BaslyHedi/Nexus-Platform/mechanical/README.md

# Mechanical - the parts we make, the chassis model, and its renders

Everything we build and model mechanically: the rear fascia, the proposed carrier tray, the
plate-1 stand-ins and the whole-vehicle model. The **why** lives in the design decisions
([`../decisions/README.md`](../decisions/README.md)); this folder owns the geometry.

| Folder | Holds |
|---|---|
| [`cad/`](cad/) | Models and the files made from them: OpenSCAD sources, the print STLs, the drilling template, and (untracked) the whole-vehicle model and its parts |
| [`scripts/`](scripts/) | The Python and Blender scripts that build the model and animate it |
| `renders/` | Videos and stills, **generated and untracked** - re-run the scripts. The SVGs are committed: the hand-made tray's template is the source of [`cad/carrier-tray-hand-template.pdf`](cad/carrier-tray-hand-template.pdf) |

The scripts find everything relative to themselves, so they run from any directory.

**Animation naming.** One rule for every animation: the script is `scripts/animate-<part>.py` and writes `renders/<part>-animation.mp4`; its stills are `renders/<part>-still-<seconds>.png`. `<part>` is the same slug as the part's CAD or drawing file, so the four are `harness-board` (MEC-16), `stm32-carrier` (`hardware/scripts/stm32-carrier.py`), `carrier-tray` (`carrier-tray.scad`, MEC-17, with the rear pad) and `compute-tray` (`compute-tray.scad`, MEC-18). Every script takes `-- --preview` (half size, every 4th frame) and, except the harness board's, `-- --still <seconds>`. They share one lighting (`paint.sl`), because the default studio light leaves surfaces seen from below black.

| File | Size | What it is |
|---|---|---|
| [`cad/fascia.scad`](cad/fascia.scad) | 18 kB | **Source of truth for both panels.** Every dimension, and why, in comments. Edit only here |
| [`cad/fascia-lower.stl`](cad/fascia-lower.stl) | 1.3 MB | Print file - lower panel, 124.2 × 18.9 × **52** mm, 19.6 cm³ (~25 g in PETG) |
| [`cad/fascia-upper.stl`](cad/fascia-upper.stl) | 2.2 MB | Print file - upper panel, 124.2 × 18.9 × **42** mm, 16.7 cm³ (~21 g in PETG) |
| [`cad/carrier-tray.scad`](cad/carrier-tray.scad) | 11 kB | **Carrier tray** (MEC-17), ordered 2026-10-06 (BOM 3.28): one plate under boards A, B and C and the Bauer converter, in two steps - the boards placed on the tray in its own frame, then the tray placed on plate 2 by one `PLACE` offset. It copies the plate-2 holes under it and bolts down at six of them with nut pockets; the Bauer is screwed to it through its own two holes. **Kept as ordered since board B became a 3×7 (2026-10-26):** one 2.1 mm hole is drilled in it by hand for B's rear inboard corner, at plate 2 (187.04, 83.65), and B's inboard pair stays empty (header STATUS, MEC-17). `PART="tray"` → [`cad/carrier-tray.stl`](cad/carrier-tray.stl) to print; `PART="template"` → a 1:1 SVG with a 50 mm check bar (the hand-cut fallback); `PART="step1"` / `"step2"` → the two placement views in `renders/`. Output is mirrored once from the layout frame into the real world |
| [`cad/compute-tray.scad`](cad/compute-tray.scad) | 9 kB | **Compute tray** (MEC-18), ordered 2026-10-06 (BOM 3.28): one 236.6 x 108.0 x 4 mm plate on plate 3, both boards turned across the vehicle - a spare pad in the nose (plate 3's outline moved in 5 mm), the Pi 5 pad, a plug gap with two ribs, the FRDM pad. Standoff screws go in from the underside through counterbores; 14 fixings to plate 3's own holes. `PART="tray"` -> [`cad/compute-tray.stl`](cad/compute-tray.stl) to print |
| [`cad/compute-tray-preview.scad`](cad/compute-tray-preview.scad) | 7 kB | The preview scene for MEC-18: plate 3, the tray, both boards on their standoffs (the FRDM's connectors from the NXP Quick Start Guide), the screws. `VIEW="top"`, `"iso"`, `"explode"` or `"side"`; the camera on the command line (see the file) |
| [`cad/plate3-data.scad`](cad/plate3-data.scad) | 5 kB | **Generated** by [`scripts/plate3-data.py`](scripts/plate3-data.py) from the layout drawing: plate 3's outline, holes, slots, standoffs and clamp holes. Do not edit |
| [`cad/plate2-rear-pad.scad`](cad/plate2-rear-pad.scad) | 5 kB | **Rear pad** (MEC-19), ordered 2026-10-06 (BOM 3.28): a separate 55 x 96 x 4 mm plain plate spread over plate 2's rear (x 196-251, y 12-108), to drill; six fixings on plate 2's own slot and holes, clear of the cross-slot, the standoffs and the carrier tray; the J7 lead lies across it. `PART="tray"` -> [`cad/plate2-rear-pad.stl`](cad/plate2-rear-pad.stl) to print |
| [`cad/carrier-tray-hand-template.pdf`](cad/carrier-tray-hand-template.pdf) | 52 kB | **Print-ready template for the hand-made tray** (MEC-17): A4 landscape, 1:1, print at 100 % and check the 100 mm bar. Written from `scripts/carrier-tray-hand.py`; regenerate it when the script changes |
| **Hiwonder** · *Ackermann Chassis (Single Layer)* `.3dm` | 186 MB | Hiwonder's own CAD, untouched. **Not in the repository** - it is theirs, not ours to redistribute, and it has to be fetched by hand on a fresh clone. Every chassis number in the project is measured from this, not from photos - see [`../bom/parts/2.1-Hiwonder-Ackermann-Chassis/SPECS.md`](../bom/parts/2.1-Hiwonder-Ackermann-Chassis/SPECS.md). It is the **single-plate** version |
| `cad/chassis-3deck-fascia.obj` | 65 MB | Whole-vehicle mock-up: Hiwonder's chassis + our deck 3 + the current panels. **Untracked, and a seed rather than output** - `make-assembly.py` reads it and rewrites it in place, so it cannot be rebuilt from this repository alone. It began as a Rhino export of the `.3dm`. Keep a local backup |
| `cad/assembly.stl` | 69 MB | The same assembly as one mesh, for renders. **Generated and untracked** - delete it and re-run |
| `cad/plate1/*.stl`, `cad/plate1/states/`, `cad/chassis-3deck-fascia.mtl` | 1 MB | **Generated and untracked** - the plate 1 parts; the two wires that cross between the decks in the `raised` and `open` positions (plate 2 lowering, 60 mm up, or hinged over like a book); and the colours. Re-run the two scripts |
| [`scripts/plate1.py`](scripts/plate1.py) | 20 kB | **Plate 1 stand-ins for an eye review** (MEC-16): every component and every wire run as its own STL in `cad/plate1/`, at the assumed sizes, plus the four tires the CAD leaves off (about 68 x 30, estimated from a photo). Not for building from |
| [`scripts/make-assembly.py`](scripts/make-assembly.py) | 8 kB | Rebuilds the assembly in `cad/` from the current STLs, fascia and plate 1, coloured through the `.mtl`. Run it after any fascia or plate 1 change |
| [`scripts/animate-harness-board.py`](scripts/animate-harness-board.py) | 10 kB | **Assembly animation** of the harness-board sandwich, in MEC-16's build order: parts onto the upturned plate 2, then all 30 wire runs one by one (each with a caption naming its ends and the clip, terminal or plug it finishes in), the flip, the lowering, the plugs, plate 3. `blender -b -P scripts/animate-harness-board.py` writes `renders/harness-board-animation.mp4` (about 1 min at double speed, 1080p; the timeline is in seconds at the top of the script); `-- --preview` renders a quick quarter-size version |
| [`scripts/animate-carrier-tray.py`](scripts/animate-carrier-tray.py) | 30 kB | **Carrier tray assembly animation** (MEC-17, MEC-19): the carrier built on the tray at the bench, then the tray set on plate 2, screwed from below, the separate rear pad nutted and screwed on behind it (67 s), and plate 2 lowered onto its standoffs; the Discovery plugs on last. Plate 2 is the survey's own outline and holes, the tray is `cad/carrier-tray.stl`, the boards are the as-built carrier through `carrier_model.py`, the Bauer is from the seller's drawing; the harness parts and the Discovery are stand-ins. `blender -b -P scripts/animate-carrier-tray.py` writes `renders/carrier-tray-animation.mp4` (50 s); `-- --preview` renders a quick half-size version; `-- --still 30` writes one PNG |
| [`scripts/animate-compute-tray.py`](scripts/animate-compute-tray.py) | 30 kB | **Compute tray assembly animation** (MEC-18): the nuts into the 14 pockets, the FRDM on its six standoffs and four screws from below, the Pi 5 on its standoffs (a later phase), the unit carried to plate 3 (held 60 mm clear of its standoffs), the 14 fixing screws from below, plate 3 lowering onto the chassis, then the BOM's three cables (J1, J11, J7). Plate 3 is the layout drawing's own outline, holes and slots (through `plate3-data.scad`); the FRDM's connectors are read off the Quick Start Guide. `blender -b -P scripts/animate-compute-tray.py` writes `renders/compute-tray-animation.mp4` (84 s, 1080p, about 20 min); `-- --preview` renders a quick half-size version, `-- --still 42` one frame at 42 s |
| [`scripts/carrier_model.py`](scripts/carrier_model.py) | 18 kB | The finished carrier (boards A, B, C and the Nucleo mock) as Blender objects, read from `hardware/scripts/stm32-carrier.py`. Used by `animate-carrier-tray.py`; `animate-stm32-carrier.py` still builds the same geometry step by step |
| [`scripts/carrier-tray-hand.py`](scripts/carrier-tray-hand.py) | 7 kB | **The hand-made tray's template** (MEC-17): a 1:1 A4 SVG (print at 100 %) with the all-right-angle cut line, true-size holes, the boards and the Bauer in outline, and the hole table, for a 4 mm sheet. Checks that no hole is too near an edge or another hole. `python3 scripts/carrier-tray-hand.py` -> `renders/carrier-tray-hand-template.svg` |
| [`scripts/animate-stm32-carrier.py`](scripts/animate-stm32-carrier.py) | 33 kB | **Carrier assembly animation** (MEC-15, HW-19), in the drawing's build order: sockets with the Discovery as the jig, the parts, the solder side run by run, the bridge, the module and standoffs, then board C. Built entirely from [`../hardware/scripts/stm32-carrier.py`](../hardware/scripts/stm32-carrier.py), so it cannot drift from the drawing. The Discovery is a **mock**: outline and headers from UM1472, everything on it placed by eye. `blender -b -P scripts/animate-stm32-carrier.py` writes `renders/stm32-carrier-animation.mp4` (47 s at double speed, 1080p); `-- --preview` renders a quick half-size version, `-- --still 40` one frame at 40 s |

## Building

```bash
cd cad
openscad -D 'PART="lower"' -o fascia-lower.stl fascia.scad
openscad -D 'PART="upper"' -o fascia-upper.stl fascia.scad
openscad -D 'PART="tray"'     -o carrier-tray.stl          carrier-tray.scad
openscad -D 'PART="tray"'     -o compute-tray.stl          compute-tray.scad
openscad -D 'PART="tray"'     -o plate2-rear-pad.stl       plate2-rear-pad.scad
openscad -D 'PART="step1"' --camera=0,0,0,0,0,0,300 --projection=o --autocenter --viewall -o ../renders/tray-step1.png carrier-tray.scad   # and step2
cd ..
python3 scripts/plate1.py
python3 scripts/make-assembly.py
blender -b -P scripts/animate-harness-board.py
blender -b -P scripts/animate-stm32-carrier.py
blender -b -P scripts/animate-carrier-tray.py
blender -b -P scripts/animate-compute-tray.py
```

Open `chassis-3deck-fascia.obj` in a viewer that reads OBJ materials (Blender, MeshLab, f3d) to see
the colours; the `.mtl` sits beside it. Plate 1's parts are the `P1_*` groups, one per component and
one per wire run, numbered as in the run table on the chassis layout drawing. Wire colours: red
unswitched +, orange switched +, black ground, teal the servo's 6 V.

`PART` also takes `both` / `exploded` / `blank` for previews, `fit` to see the panels
against the rear chassis, and **`clash`**, which intersects both panels with the plates and
standoffs. That one is the gate:

```bash
openscad -D 'PART="clash"' -o /tmp/clash.stl cad/fascia.scad   # must be zero volume
```

Zero volume - a few hundred triangles of coincident face - is a pass; those are the pad faces
lying on the plates, which is the clamp. Real volume is an interference. It has caught a live
bug once already (MEC-07), so run it before every print.

`PART="portclash"` is the second gate. It checks rough stand-ins of the three upper-panel
connectors against the panel, the rear chassis and each other, and must also
render zero volume (MEC-13):

```bash
openscad -D 'PART="portclash"' -o /tmp/portclash.stl cad/fascia.scad   # must be zero volume
```

## Print settings

PETG, 0.2 mm layers, ≥40 % infill, 4 walls, flat on the rear face, no supports.
Material choice and the reasoning behind it: **MEC-02**.

## Two panels, two heights

The gaps were measured on the built kit as **50 mm (lower)** and **40 mm (upper)** - the kit
ships two standoff lengths. So the panels are different parts and are **not** interchangeable
(**MEC-09**, which retires MEC-03). Mark each one on the inside face as it comes off the printer.

## What each decision owns

| | |
|---|---|
| **MEC-02** | The fascia exists at all, material, what each gap carries |
| **HW-18** | DE-9 as the CAN debug port, pinout |
| **MEC-03** | The split into two panels - its *interchangeable* half is retired by MEC-09 |
| **MEC-04** | Vents |
| **MEC-05** | The three debug ports and which board each reaches. Positions and apertures superseded by MEC-13 |
| **MEC-06** | DRIVE / LOGIC legends |
| **MEC-07** | The fixing: four pads per panel, six M3, captive nuts |
| **MEC-09** | The measured gaps, and the panels being different parts |
| **MEC-13** | The ports mounted from behind in pockets, in two horizontal rows; the USB-C grip limit; the upper panel's vents |
| **MEC-14** | The switch holes (⌀22.4) and what the switch drawing settles |
| **MEC-18** | *Proposed:* the compute tray on plate 3 - FRDM and Raspberry Pi 5 |

## Caveats worth knowing before you trust this geometry

- **Deck 3 is ours, not Hiwonder's.** The `.3dm` is the single-plate version; deck 3 in the
  `.obj` is a copy of deck 2, dropped to the measured 40 mm gap by `make-assembly.py`. Fixing
  the source CAD would make that patch unnecessary.
- **Some port geometry is read off photos** - the USB-C body width and flange depth, the Mini-B
  screw pitch and body. None of it is critical any more: the nearest body is 6 mm from a standoff,
  and the Mini-B's slotted hole takes any pitch from 27 to 30 (MEC-13).
- **The switch harness depth is checked on the real parts (2026-10-11).** The bare switch is 25 mm
  deep and clears the motors by about 8 mm; with the plug-on socket harness fitted it still fits
  behind the motors, with the cables pushed slightly to the side (MEC-14).
