BaslyHedi/Nexus-Platform/hardware/README.md

# Hardware

Build drawings for NEXUS. Each is an `.svg` in [`renders/`](renders/) **written by the script of the same name** in
[`scripts/`](scripts/): `chassis-layout.py` writes `chassis-layout.svg`, `wiring-schematic.py` writes `wiring-schematic.svg`,
`stm32-carrier.py` writes `stm32-carrier.svg`. Edit the script, never the SVG, then run it:

```bash
python3 hardware/scripts/chassis-layout.py        # -> hardware/renders/chassis-layout.svg
python3 tools/check-drawings.py                  # fails if any SVG is not what its script writes
```

[`scripts/drawing.py`](scripts/drawing.py) holds the small SVG helpers the first two share. The chassis plate (outline, slots, holes,
standoffs) is one table in millimetres drawn on all four plans; the wiring schematic's nets are one colour palette shared with its key.
Both scripts were made on 2026-10-05 from the SVGs as they stood and reproduce them exactly (the layout without 24 stray blank
lines), so nothing in a drawing changed when they took over. The plate outline in `chassis-layout.py` was traced from Hiwonder's CAD
export; the early scripts that did it were not kept (they can still be read in the commits of PR #6).

**No PDFs.** They are generated once, when the design is frozen. Until then the SVG is the
truth and a stale PDF beside it is just a second thing to get wrong. To read one, open the
SVG in a browser; to render, point headless Chrome at it.

| Drawing | Owns |
|---|---|
| [chassis-layout.svg](renders/chassis-layout.svg) | Where components sit on the **three** decks, to scale at 1.7 px/mm, plus the side elevation of the deck stack |
| [wiring-schematic.svg](renders/wiring-schematic.svg) | What connects to what - fuses, switches, wire gauges, 5 V rails, CAN, I²C, motor control |
| [stm32-carrier.svg](renders/stm32-carrier.svg) | Soldering and wiring for the three kit boards: A and B, which the NUCLEO-H533RE drops onto, and C, the 5 V split. Component side and solder side, hole by hole, with netlist and pre-solder checks (MEC-08, MEC-15, HW-19). **Generated** by `python3 stm32-carrier.py`, which also feeds the 3D animation in [`../mechanical/scripts/animate-stm32-carrier.py`](../mechanical/scripts/animate-stm32-carrier.py) |
| [`../decisions/README.md`](../decisions/README.md) | **Why** the drawings look the way they do - HW, MEC, SYS and SW entries, each with its reasoning and consequences. Not in this folder any more |

Part numbers, prices and status live in [`../bom/BOM.md`](../bom/BOM.md);
datasheets in [`../bom/`](../bom/).

## Still open

### Plate 1, the motor driver - fitted 2026-09-21

Footprint and position are both settled and the drawing matches the hardware. Geometry, the
as-mounted coordinates and the method behind them are in
[`../bom/parts/2.4-Encoder-Motor-Module/SPECS.md`](../bom/parts/2.4-Encoder-Motor-Module/SPECS.md).
In short: **42 x 58 at x 168-210, y 22.6-80.6**, long axis across the vehicle, connector edge to
the vehicle's right, **2 x M3 and spacers through the chassis slot at x 203.5**.

No chassis hole pattern matches the board's 32.4 x 48.4 - all 96 plate-1 features were searched,
nothing within 1.5 mm in either orientation - so that one slot is the whole fixing, and it takes
both rear holes anywhere along its length. What is still open:

- **The front pair is not fixed.** Two screws on one line let the board pivot. The front-left hole
  (y 75.8) sits **directly over the 14.6 x 59.8 cutout**, so a cable tie there is a straight pull
  with no diagonal; the front-right (y 27.4) lands on solid plate 3 mm past the cutout's end and
  can tie diagonally to the ⌀2.71 hole at x 169.9, y 20.2. Two ties, no new parts.
- **Spacer height is now a clearance, not a preference.** The board's rear 7 mm sits over the
  front of the motor cans, and at x 210 the ⌀33 can is only 10.7 mm above the plate. Measure what
  is fitted before ordering more.
- **M3 spacers are still not in the BOM** even though they are on the vehicle.
- **VM cannot be fed the way every other load is.** Input is a 2-pin 2.5 mm connector, about 3 A
  and 22 AWG, while the drive branch is 18 AWG behind a 5 A fuse and can see 4.6 A with both
  motors stalled. The adapter, and whether to double up through the 3-pin port, is open.
- **The board sits 8.6 mm off the centreline** because the forward screw is at the end of its
  slot. Fine as it is; the UBEC it displaced no longer sits on the floor at all (MEC-16).

### Plate 1 and the harness board - 2026-09-28

The pack is fixed right behind the tie rod (x 85-162). Plate 1's floor carries only the pack and the
driver; every clip, fuse, splice, the INA226 and the UBEC are taped to **plate 2's lower face**, and
the drops to plate 1 fold down when plate 2 is lowered (MEC-16). The logic fuse is gone (HW-20). The
drawing has plate 2's two faces as separate plans and the run table with cut lengths; the 3D model
is [`../mechanical/scripts/plate1.py`](../mechanical/scripts/plate1.py). What it still rests on:

- **Clip outlines**: 221-415, DOMAXWILL 3-port and 2-port, and which face the wires enter.
- **Fuse holder body**, with calipers - the base / cap shape is the seller's photo (2026-10-07), the sizes are scaled off it.
- **Battery height with its felt, and the driver's top height** - they set the clear air under the
  harness board.
- **The carrier and board C screw heads under plate 2** against the taped parts.
- **SW1 / SW2 tab layout** and the lengths of the SM-2P mating lead and the Bauer's own leads.

### Elsewhere

- **The carrier and board C are placed but not fitted** (MEC-15). The carrier's header row 1 is at
  x 181.20, fixed at four existing plate-2 holes. Board C sits across the waist at x 85.5-115.5, on
  the M3 pair at x 99.24. Two of the carrier's holes are drilled off grid, marked from the plate.
  Still to check: six 10 mm M2.5 standoffs in stock, and the Bauer not moving rearward into C.
- **The Bauer 50 W is still parked** on plate 2 with a `?` on it, because its 54 mm ear pitch
  matches no chassis rectangle.
- **The pack is fixed** right behind the tie rod, on a felt pad under two felt strips and zip ties
  (BOM 3.24, MEC-16). The hook-and-loop straps once planned were not needed.
- **The pack's real capacity is unknown.** 63 x 77 x 20 with the leads on a 63 face is three
  21700s in a single row, so 3S1P and **4300-5000 mAh, not the 6000 on the label**. Measure it on
  the first full discharge through the INA226 - it is the denominator for coulomb counting.
- **The CAN matrix is still to draw** - Phase 1 needs only the flashing identifiers and a heartbeat, the application messages come in Phase 2 ([`../system/phases.md`](../system/phases.md)).
- Switch depth and mounting-nut OD, once SW1/SW2 arrive (MEC-07).
- USB-C and Mini-B aperture sizes on the parts ordered 20 Sep (MEC-05).

## Related 3D files

The rear fascia and the chassis CAD live in
[`../mechanical/`](../mechanical/). Its
[README](../mechanical/README.md) owns the file-by-file description, the build
commands and the `PART="clash"` check that must pass before any print. The decisions behind the
panels are MEC-02, HW-18 to MEC-07 and MEC-09 in
[`../decisions/README.md`](../decisions/README.md).
