BaslyHedi/Nexus-Platform/decisions/MEC-Mechanical-Decisions.md

# MEC · Mechanical design decisions

Packaging, the deck stack, printed parts and how things are fixed to the vehicle. Each entry is settled - revisit one only if something concrete contradicts it.

Numbering is `MEC-nn`, unique across the project and never reused. Format, and how to add one: [README](README.md). Parts, prices and status: [`../bom/BOM.md`](../bom/BOM.md).

Drawings: [chassis layout](../hardware/renders/chassis-layout.svg). Geometry and build commands: [`../mechanical/README.md`](../mechanical/README.md).

| # | Decision |
|---|---|
| **MEC-01** | Power domain low, compute domain high |
| **MEC-02** | Rear fascia - 3D printed, covers the inter-deck gaps |
| **MEC-03** | The fascia is two interchangeable panels |
| **MEC-04** | Vents - six obround slots per panel, in the bands the features do not use |
| **MEC-05** | Board debug ports on the fascia - and the DE-9 moves off centre to fit |
| **MEC-06** | Switch legends - DRIVE and LOGIC, not POWER |
| **MEC-07** | The fascia is clamped at four corners - six M3 for the whole thing |
| **MEC-08** | The STM32 rides on a perfboard carrier, not on the chassis directly |
| **MEC-09** | The two deck gaps are 50 and 40 mm - the panels are different parts |
| **MEC-10** | The chassis holes are three sizes - and half of them are M2.5, not M3 |
| **MEC-11** | The FRDM's mounting holes land on the Hiwonder grid - 0.06 mm out |
| **MEC-12** | Component allocation across the three plates |
| **MEC-13** | The debug ports mount from behind, in two horizontal rows |
| **MEC-14** | The switch drawing closes the lower panel - and its holes open to 22.4 |
| **MEC-15** | The carrier is two kit boards joined by the Discovery, not one board. *The NUCLEO-H533RE joins them since 2026-10-25, CN7 over A since 2026-11-01* |
| **MEC-16** | Plate 2's lower face is the harness board - plate 1 carries only the battery and the driver |
| **MEC-17** | One tray carries boards A, B and C and bolts to plate 2 |
| **MEC-18** | One wide tray on plate 3 - a spare nose, the Pi 5, a plug gap, the FRDM, all turned across |
| **MEC-19** | A separate pad spread over plate 2's rear |

---

## MEC-01 · Power domain low, compute domain high

*Formerly HD-12.*

**Updated by HW-15:** the fuse block is replaced by a bus bar pair, so its placement on standoffs above the battery no longer applies.

**Decision.** Bottom deck: battery, Hiwonder driver, shunt, switches, fuse block on standoffs
above the battery. Top deck: both compute boards, both converters, CAN transceiver.

**Why.** Three reasons in order of weight: the fuse block is ~20 % of a deck and competes with
the boards; the battery is already on the bottom deck by the chassis's own design, so the
highest-current runs stay short; and motor switching currents end up on a different deck from
the CAN bus with an aluminium plate between them - free noise separation from a mounting choice.

**Converters go on the top deck deliberately.** Long wires then carry 12 V at low current and
short wires carry 5 V board-adjacent, which is where droop actually hurts.

---

## MEC-02 · Rear fascia - 3D printed, covers the inter-deck gaps

*Formerly HD-15.*

**Updated by MEC-14:** the switch holes are ⌀22.4, not 22.2.

**Updated by MEC-13:** the upper panel's ports are in two rows, not one, and mount from behind.

**Superseded in part by MEC-09 (2026-09-20).** The gaps were measured on the built kit: **lower 50,
upper 40** - the kit ships two standoff lengths. Everything below that assumes 52 mm pitch, a
104 mm span and identical gaps is wrong; the panels are 52 and 42 mm tall and the upper deck's top
face is z 123.12, not 133.12.

**Status.** Unfrozen 2026-09-17 - the CAN connector is chosen (HW-18) and the reserved
upper-gap cut-out is now defined. Source of truth:
[`../mechanical/cad/fascia.scad`](../mechanical/cad/fascia.scad); visual check:
`chassis-3deck-fascia.obj` in the same folder (`mechanical/cad/`).

**Decision.** Printed panels close the rear of the vehicle between deck 1 and deck 3
(z 29.12 → 133.12, 104 mm). They follow the real rear taper of the plate - 88.5 mm at the rear
face - rather than a rectangle, and fix to plate holes that already exist
(x −41.34 / +46.30, y 124.54, on every deck). **Split into two interchangeable panels by
MEC-03** - that record owns the split, the fixing count and the absence of vents.

| Zone | z | Carries |
|---|---|---|
| Lower gap | 29.12 → 79.12 | **SW1 / SW2** ⌀22.2 at 44 mm centres, z 54.12 · labelled **DRIVE / LOGIC** (MEC-06) |
| Upper gap | 81.12 → 131.12 | **Three ports in one row at z 101.12** (MEC-09; was 106.12) - USB-C (x −28.58), **DE-9 CAN** (x 0, HW-18), Mini-B (x +31.06). Layout and apertures owned by **MEC-05** |

**Why.**

- **Advanced kit has three decks at 52 mm pitch** (confirmed on the real kit), not the two in
  the Hiwonder "Single Layer" CAD - the model was extended by duplicating the plate and its four
  standoffs.
- **The rear tapers** from 118.7 mm at y 114 to 88.5 mm at the edge; a flat panel overhangs it.
- **Nothing below deck 1** - the running gear stays open and there is no ground-clearance question.
- **Printed nylon/PETG, not acrylic** - acrylic is notch-sensitive and would crack from its holes
  under vibration.
- Tabs are clipped to the wall interior and notched around the bronze standoffs, so they cannot
  break through the taper or foul the pillars.

**Consequences.**

- **Button bodies protrude ~25 mm into the rear of the lower gap**, which is also where the FRDM
  and STM32 are meant to sit - board placement must stay forward of y ≈ 109.
- **The deck-2 tab sits on the floor of the upper gap** (x ±38…50). This was once read as "keep the
  CAN connector central"; that is **retired by MEC-05** - the tab is at local z 0…4 and every port
  flange is at z 18…32, so they never interact and the DE-9 is free to move in x.

**Open before printing.** Measure all three port apertures against the parts in hand (MEC-05); ~~screw retention~~ (closed by MEC-07); optional chamfer on the square wrap ends at y 118.

---

## MEC-03 · The fascia is two interchangeable panels

*Formerly HD-22.*

**Updated by MEC-07:** 8 M3 becomes 6 - the tabs are now pads with captive nuts, and deck 2's shared hole takes one M3×10 through both panels, the option this record already foresaw.

**Decision.** The rear fascia is **two panels from one blank**, one per inter-deck gap, differing
only in their cut-out: buttons in one, the DE-9 in the other. Vents are common to both and are
owned by **MEC-04**.

**Why the split is free.** The one-piece part spanned z 29.12 → 133.12 = **104 mm = exactly two
deck pitches of 52**, both gaps measure **50.00 mm**, and the rear profile is a constant
cross-section. So the halves are the *same* blank rather than two parts that merely resemble each
other, and both cut-outs already fell at local z 25.0 of their own half. Splitting at deck 2's top
face cost no geometry change.

**Why interchangeable is worth having.** Either panel bolts into either gap, so the ports can swap
decks later without a reprint. One blank means one print profile to tune and one spare to keep. A
damaged panel - the buttons are the part that gets handled - is replaced on its own instead of
reprinting 104 mm of shell.

**Consequences.**

- **8 M3 instead of 6.** Each panel is caught at both ends (tabs at local z 0 and 46), where the
  one-piece part relied on three tab levels. More fixings, and no unsupported free edge.
- **Deck 2's hole is now shared** by the lower panel's top tab (underneath) and the upper panel's
  bottom tab (on top). Use one M3×16 through tab + deck + tab with a nyloc nut, or two M3×8 from
  opposite faces. Either way the tabs are clamped, so no heat-set inserts are needed there.
- **Each panel wraps the deck above it** (52 mm, not 50), so the rear face stays continuous and no
  deck edge is exposed. The only shut line is at z 81.12.
- **Verified disjoint:** the two panels rendered together give 3 CGAL volumes - two separate solids
  plus outer space - so nothing interferes at the shut line.
- Print both from `fascia.scad` with `-D 'PART="lower"'` and `-D 'PART="upper"'`; `PART="blank"`
  gives the uncut body if a third panel is ever wanted.

---

## MEC-04 · Vents - six obround slots per panel, in the bands the features do not use

**Updated by MEC-13:** on the upper panel the two port rows fill the middle, so its vents are six short slots at the ends and top corners.

**Updated by MEC-14:** the lower panel's vents are redesigned for cooling: a centre ladder, an upright slot at each end and a top row, 164 mm of slot. The rule below is kept in its intent (~10 mm from any switch hole).

*Formerly HD-23.*

**Decision.** Each panel carries **six obround slots**, two rows of three, symmetric about the
panel centreline and about the cut-out centre. They are cut into the **shared blank**, so both
panels get exactly the same pattern and interchangeability is unaffected.

| | |
|---|---|
| Rows | local z **8.5** and **41.5** - 16.5 mm either side of the centre at 25 |
| Slots | outer pair **7.0 × 3.0 mm**, centre pair **16.0 × 3.0 mm**, radiused ends (⌀3.0) |
| Columns | centres at XC ±38.67 and XC - the three gaps beside and between the button holes |
| Material above/below each switch | **9.9 mm**, solid - no slot is cut over or under a button hole |
| Thinnest in-plane margin | 2.9 mm (centre slot to button hole) · 2.1 mm (outer slot to the face fold) |

**Why this pattern and not the first one.** The original vents failed for two reasons, and both
are fixed here rather than worked around:

- **They were square-cornered `cube()` cuts.** A sharp internal corner is a stress riser and is
  where a crack starts in a printed part under vibration. These are obround - two radiused ends
  hulled together - so there is no corner to initiate from.
- **They ran directly over and under the button holes.** That is the load path around a ⌀22.2
  hole in a panel that vibrates, and a slot 3.9 mm from the hole edge pinches it to a ligament.
  Moving the rows down in height would only have taken that to 4.4 mm. Instead the slots were
  moved *sideways*, into the three x-gaps the buttons leave free, so the material above and below
  each switch is now solid for the full 9.9 mm - a 2.5× gain in the section that actually carries
  load. The rows remain clear of the DE-9 flange (18.7–31.3) and both tab bands (0–4, 46–50).

**Why vent at all**, given the chassis is open on three sides: cross-flow past warm boards is
cheap once the slots cost nothing structurally, and the lower gap is where the FRDM and STM32 sit.

**Consequences.**

- **Verified identical on both panels:** the vent vertex delta is **the same on each**, so the
  pattern is provably common to both and the blank stays shared. Both compile as a single solid.
- **Open airway is ~42 % of the first pattern** (180 mm² per panel vs 432 mm²). Accepted
  deliberately: the chassis is open on three sides, so the rear panel is not the airflow path,
  and strength around the switches was the binding constraint. The outer slots are short (7 mm);
  if they are not earning their keep they can be dropped without touching anything else.
- The slots are **through-cuts in a 3 mm wall**; no bridging, so they print without support in the
  panel's natural flat-on-the-bed orientation.
- **They consume no connector space.** The bays beside the DE-9 are bounded by the flange and the
  flat face, not by the vents, so the vent rows do not reduce room for debug ports (MEC-05).

---

## MEC-05 · Board debug ports on the fascia - and the DE-9 moves off centre to fit

*Formerly HD-24.*

**Updated by MEC-13:** both extensions mount from behind in pockets, the Mini-B flange is 36 mm, and the ports are in two rows, centred: DE-9 on top at x +2.48, USB-C (x −16.52) and Mini-B (x +21.48) below. The single row, positions, apertures and Mini-B figures below are historical.

**Updated by MEC-07:** the flat face widened from 88.47 to 94.24 mm. Port positions are unchanged, so every bay gained ~3 mm of margin.

**Vendor drawings checked 2026-09-19.** The DE-9 is fully confirmed - flange **30.84 ±0.38**, screw centres **24.99 ±0.13**, shell **16.92 ±0.13 × 8.38 ±0.13**, its own flange holes ⌀3.05. The USB-C drawing confirms flange 23, screw centres 15, body 40 × 7.5. The Mini-B photo confirms 28.0 across the flange. Apertures were opened to suit: DE-9 **17.9 × 9.2** (0.5 and 0.4 mm a side on the measured shell, was 17.6 × 9.0 against an assumed 16.9 × 8.4), and all three screw clearances to 3.0–3.4 mm, since every flange covers its holes. **Still unmeasured:** the USB-C and Mini-B apertures (both sized for a moulded boss nobody has published) and the Mini-B screw pitch - which is now designed around rather than measured.

**The Mini-B's outboard hole is a 5.5 × 3.0 slot** (2026-09-19). Its screw centre can sit anywhere across ±1.25 mm, so any pitch from **18.5 to 23.5 mm** bolts up, against a plausible range of 20–22. Only that one hole is slotted: the inboard hole stays round and locates the connector, so the part can only pivot slightly about it rather than slide bodily - two slots would be the loose, needs-glue failure. The 28 mm flange covers the slot, and a washer under the screw head spans it. The USB-C keeps two round holes, its 15 mm pitch being on the drawing.

**Decision.** Both compute boards get their debug connector brought out to the **upper panel**,
in one row with the DE-9, all three centred at local z 25:

| x | Port | Goes to | Flange |
|---|---|---|---|
| **−28.58** | USB-C panel-mount extension (CY type, 20 cm) | FRDM **J11** - USB-C UART console, 115200 8N1 | 23.0 wide, screws 15 mm |
| **0** | DE-9 male, CAN (HW-18) | CAN bus stub | 30.8 wide, screws 24.99 mm |
| **+31.06** | Mini-B panel-mount extension (JSER type, 50 cm) | Discovery **CN1** - ST-LINK/V2 | 28.0 wide overall |

**Labels.** Each port is named on the panel - **IMX91 · CAN · STM32** - debossed **0.6 mm**,
4.5 mm cap height, centred on its port at z 36. They name the *board*, not the connector: the
connector is obvious by shape, which board it reaches is not. The band at z 32…40 between the
flange tops and the upper vent row holds them with 1.75 mm clear either side, and 0.6 mm into a
3 mm wall removes nothing structural.

- **Debossed, not raised.** Raised letters on a vertical wall are fragile and print mushy; a
  recess takes a paint pen - wipe across, wipe the face clean, the letters stay filled. That is
  what makes them readable without a second filament.
- **The text is mirrored in the model on purpose.** The rear face looks down **+y**, so an
  observer standing behind the vehicle sees world **+x running to their left**. Without the flip
  in `label()` every name would print backwards. This is why STM32 (x +31.06) appears on the left
  in a face-on render and IMX91 (x −28.58) on the right - that is the correct real-world reading.

**The DE-9 moves from x 2.48 to x 0.** The three flanges total 81.8 mm across an 88.47 mm flat
face, leaving 6.67 mm. Left where it was, the bays came out 28.86 and 28.81 mm - the 23 mm USB-C
fits one comfortably, but the **28 mm Mini-B would have had 0.4 mm a side and does not fit**. A
2.5 mm shift rebalances the bays to 26.36 and 31.31, giving **~1.67 mm each side of every part**.

**Why that shift is allowed.** MEC-02 recorded "keep the CAN connector central" because the deck-2
tab occupies x ±38…50 on the floor of the upper gap. That tab is at local **z 0…4**; every port
flange here is at **z 18…32**. They never interact, so the constraint was stale rather than real.
On an 88 mm face a 2.5 mm move is invisible, and x 0 is a cleaner datum than 2.48.

**Why J11 and not J1.** J1 is the *power* input, fed dumb 5 V (HW-02). J11 is the separate USB-C
UART console. Bringing J1 out here would be actively wrong.

**Consequences.**

- ⚠️ **Every aperture is NOMINAL - measure all three parts before printing.** The DE-9's 24.99 mm
  screw pitch is the only genuinely fixed number. The USB-C flange (23) and screw pitch (15) are
  read off a vendor drawing; the Mini-B's **screw pitch is inferred** from its 28 mm overall, and
  both aperture sizes are guesses at the moulded boss. All are named constants in `fascia.scad`.
- **~1.67 mm margins are tight.** If a measured part comes in larger, the cheapest fix is a
  narrower CAN connector or accepting a smaller vent column - not squeezing the margins further.
- **Verified:** the upper panel went 1904 → 2496 vertices, **+592 = exactly 2 × 296**, the same
  delta the DE-9 alone produced. Both ports cut cleanly and the panel is still a single solid.
  Adjacent screws clear each other by 8.6 mm (USB-C↔DE-9) and 8.1 mm (DE-9↔Mini-B).
- **The lower panel is untouched** and still carries only the two buttons, so the blank stays
  common and the panels stay interchangeable (MEC-03).
- **A USB-C extension is not a USB-spec-compliant thing to build.** Fine for a 115200 baud UART,
  but if the cable does not pass CC through, a C-to-C lead from the PC will not enumerate - test
  with both C-to-C and A-to-C on arrival.
- **Cable runs are upward**: both boards live in the *lower* gap (MEC-02), so each port's tail has
  to reach the upper panel. 20 cm (USB-C) and 50 cm (Mini-B) both cover ~100 mm comfortably.

---

## MEC-06 · Switch legends - DRIVE and LOGIC, not POWER

*Formerly HD-25.*

**Updated by MEC-14:** the legends sit at z 41, not 43, to make room for the lower panel's top vent row.

**Decision.** The lower panel names both switches, debossed 0.6 mm at 4.5 mm cap height, z 43:

| x | Legend | Switch | LED |
|---|---|---|---|
| **+24.48** | **DRIVE** | SW1 - power train | red |
| **−19.52** | **LOGIC** | SW2 - compute | green |

**Why not "POWER".** SW1 switches the power *train*. **Neither switch is a master cut-off** - that
is the battery connector (HW-08: neither switch carries full pack current). A panel reading POWER
invites someone reaching for an emergency stop to believe they have found one. DRIVE says what it
actually does and carries no such promise.

**Why z 43, when there is only 3.9 mm above a button.** A ⌀22.2 hole spans z 13.9…36.1, leaving
bands far too thin for 4.5 mm text above or below it. The upper vent row solves it: its slots sit
at x −39.69…−32.69, −5.52…10.48 and 37.65…44.65, so the **27.2 mm spans between them** are clear
from the button tops to the panel top - and each span sits almost exactly over its own button.
z 43 also clears a 26 mm switch bezel by 2.75 mm, which the hole diameter alone does not.

**Which button is which - a choice, not a record.** Nothing in the project fixed the left/right
assignment. Taken from the SW1/SW2 numbering: **SW1 leftmost as faced**. Faced from behind the
vehicle world +x runs to the observer's **left**, so SW1 is x +24.48. The opposite convention -
logic on the left, switched on first, reading left to right - is equally defensible; swapping is
one line in `labels_lower()`.

**Consequences.**

- Lower panel 1896 → 3296 vertices, still a single solid. Upper unchanged at 5058.
- **Labels are per-panel, not in the blank**, like the ports. The blank stays common and the
  panels stay interchangeable (MEC-03).
- Same debossed-and-paint-filled treatment as the upper panel (MEC-05), and the same `mirror()` -
  without it every legend prints backwards.
- **The legends assume the red switch is fitted at x +24.48.** Colour and legend must agree on
  assembly; if the switches go in the other way round the panel lies, which is worse than no
  legend at all.

---

## MEC-07 · The fascia is clamped at four corners - six M3 for the whole thing

**Updated by MEC-14:** the switch drawing gives the nut (25 A/F, 28.5 across corners) and the bare depth (25 mm), closing the check below for the switch itself. **Checked on the real switches (2026-10-11):** the harness fits behind the motors, with the cables pushed slightly to the side. The harness depth is closed.

**Confirmed by MEC-10 (2026-09-20):** both fixing positions land exactly on real CAD holes,
and both are ⌀3.18 - the only M3-capable class on the plate.

*Formerly HD-26.*

**Decision (2026-09-18).** Each panel is clamped to the plate below *and* the plate above by a
**pad at each corner**, screwed through the plate holes that already exist at
**x −41.34 / +46.30, y 124.54** on every deck. Pads are 5 mm thick, at local z 0…5 and 45…50.
**Every nut is captive in a pad** - nothing has to be held inside the chassis.

| Joint | Screw | Driven from | Nut |
|---|---|---|---|
| Plate 1 | M3×8 | under the vehicle | captive in the lower panel's bottom pads |
| Plate 2 | M3×12 | above, in the open upper gap, downward | captive in the lower panel's **top** pads - **one screw clamps both panels**, the shared hole MEC-03 identified |
| Plate 3 | M3×8 | on top of the vehicle, downward | captive in the upper panel's top pads |

Washer under every head. Each pocket opens *away* from its own plate, so every nut is pulled onto
the closed end of its pocket as the screw tightens, and every screw is driven from whichever side
is open at that point in the build.

**Plate 2 is driven from above, not below.** The nut goes in the *lower* panel's top pad, pushed up
into its pocket from the open gap below; the screw then comes down through the upper panel's bottom
pad. The other way round - nut in the upper panel, screw upward from the lower gap - works
mechanically but asks for a blind upward drive in the gap where the FRDM and STM32 live. The upper
panel's own bottom pocket is then unused, and the washer under that head spans it.

**How this was arrived at.** The first cut of MEC-07 hung the panels on ring hangers round the
rear standoffs - screwless, dropped on during stacking. It was dropped before printing:

- **Rings locate, they do not clamp.** Bore 7.4 over a 6.0 A/F hex leaves 0.24 mm of play towards
  a corner and 0.7 mm towards a flat, ±0.36° of rotation (±0.37 mm at the panel ends) and 0.4 mm
  vertically. A panel carrying two latching switches and three connectors would have buzzed, and
  a switch press would have felt spongy.
- **Rings *and* screws is two features doing one job.** Once screws are there, they locate as well.
- **Bottom-only screws leave one direction open.** Pushing the panel in is stopped by the wrap
  hitting the plate edge after 0.4 mm, but *pulling* it - tugging a CAN or USB lead - is resisted
  only by the wall bending: about 0.3…0.5 mm of spring at 30 N, and a hard yank puts the load
  into the pad root. Clamping the top band removes it.
- **Top pads cost two screws, not four**, because plate 2's screw serves both panels.

**Why not the old 8 × M3 of MEC-03.** Same clamping for six screws instead of eight, and the
shared plate-2 hole is now used deliberately rather than worked around.

**Fixed along the way - the old wall collided with the decks.** The MEC-02 wall followed the plate
edge *on* the plate: its inner face was 0.3 mm inside the rear flat and up to ~3 mm inside along
the taper. Since each panel wraps the deck above (z 50…52), both printed panels would have hit a
deck across their whole width. The wall is now the plate outline offset by **0.4 mm clearance +
3 mm wall**, so it passes outside the deck edge. The rear face moves from y 134.24 to **134.94**,
which also widens the flat from 88.47 to **94.24 mm** - every port bay gained ~3 mm (MEC-05).

**Consequences.**

- **Assembled during stacking**, because each panel wraps the deck above it: lower panel in,
  plate 2 on, upper panel in, plate 3 on, then the six screws. Removal reverses that - this is a
  build-once fascia, which is what it is for.
- **Locked in all six directions** once the screws are tight. The only remaining motion is elastic.
- **Verified with a clash render.** `PART="clash"` intersects both panels with a stand-in of the
  three rear plates (holes and cross-slot cut) and the four rear standoffs: **zero volume** - the
  944 triangles it returns are the pad faces lying on the plates, which is the clamp itself. As
  controls, the same check on the pre-MEC-07 STLs returns solid overlap through the full panel
  height, and forcing `CLR=-0.3` returns 159 mm³. Both panels are single solids (CGAL: 2 volumes).
- **Parts:** 124.2 × 18.9 × 52 mm, 20.5 / 21.7 cm³ - about 26 and 28 g in PETG (was 19.0 / 20.2
  cm³ with the MEC-03 tabs). Re-quote before ordering.
- **Pads clear the standoffs** by 8.35 mm centre to centre, nicked to leave 0.5 mm, and sit in the
  z bands nothing else uses: vents 7…10 and 40…43, buttons and their nuts ~10…40, port flanges
  18…32.
- **Print orientation unchanged** - flat on the rear face, pads and nut pockets facing up and
  down, no support.

**Check before printing.** Switch depth with the spade terminals fitted, and the mounting nut's
outside diameter (switches arrive 29 Sep – 13 Oct): the body must clear the motors at y 101.7 -
a 25 mm body now ends at y ≈ 109.9, about 8 mm clear - and a nut over ~30 mm across would reach
the pad bands.

---

## MEC-08 · The STM32 rides on a perfboard carrier, not on the chassis directly

**Updated by MEC-15:** no kit board is large enough, so the carrier is two boards, A under P1 and B under P2, and the 130 × 85 outline is gone.

**Updated by MEC-15 (revision 2026-10-25) and HW-22:** the Discovery failed and a NUCLEO-H533RE drops onto the carrier by its ST morpho headers, CN10 on A and CN7 on B. The decision stands; the Discovery's pins and headers below are history.

**Resolved 2026-09-20:** the Discovery's P1/P2 pins protrude **downward**, so the carrier sits
**below** the board and the Discovery drops onto female headers. The open question about pin
direction is closed, and the arrangement in the carrier schematic is the correct one.

*Formerly HD-27.*

**Decision (2026-09-20).** The Discovery plugs into a hand-built **prototype-PCB carrier** (5.11).
The carrier is what bolts to the chassis; the Discovery is a module that lifts out. Everything the
board needs crosses one board-to-board interface instead of a loom of flying leads.

**UM1472 says this is the intended use.** §4.9: *"The male headers P1 and P2 can connect the
STM32F4DISCOVERY to a standard prototyping/wrapping board."* The headers ship populated and the
100 mil pitch matches the perfboard grid, so no adapter is invented.

| Carries | From | Note |
|---|---|---|
| **5 V in + GND** | Bauer 50 W via SW2 (HW-17) | §4.3: the 5 V pin is a valid **input**, and **D1/D2 protect it from external supplies** - the rail and the ST-LINK USB cannot fight |
| **CAN PD0 (RX) / PD1 (TX), AF9** | P2 | Put the **SN65HVD230 on the carrier** - it keeps the TX/RX stubs to a few cm and gives H/L/GND one clean twisted exit |
| **I²C2 PB10 SCL / PB11 SDA** | P2 | INA226, and possibly the motor module on the same bus at a different address (HW-10) |
| **Servo PWM** | STM32 → 3.18 UBEC'd servo | Signal only; the servo's power never touches this board |
| **3.3 V for the transceiver** | Discovery 3 V pin | ⚠️ §4.3: 5 V and 3 V as **outputs are limited to 100 mA**. The SN65HVD230 is ~10 mA, fine - but **nothing else may hang off them**, in particular not the motor module |

**Why a carrier rather than mounting the Discovery directly and running flying leads.**

- **Vibration.** Dupont jumpers are the project's known weak point (5.7: copper-clad aluminium,
  crimps that degrade under vibration). A carrier turns dozens of vibrating individual crimps into
  one seated header pair plus soldered joints.
- **The Discovery becomes replaceable.** Unplug and swap without unpicking the loom - worth a lot
  on a board carrying the only ST-LINK.
- **One ground reference.** The carrier gives a single point to bring back to the (−) WAGO bus,
  which is what HW-06's star ground asks for.

**Consequences.**

- ⚠️ **Check which way P1/P2's pins protrude on the board in hand.** The plan assumes the
  Discovery drops *onto* female headers. If the pins stand proud of the top face only, the carrier
  sits above the board instead of beneath it, or the headers need re-soldering. **This is the one
  thing that decides the mechanical arrangement, and the board is on the desk.**
- **Board size:** P1/P2 run the long edges, 25 pins = 63.5 mm, and the Discovery is ~97 × 66 mm.
  The carrier must span ~70 × 66 mm minimum - a 70 × 90 mm perfboard from the kit is enough; it
  does not have to match the Discovery's footprint.
- **Dry-fit before soldering anything.** The P1–P2 row spacing must land on the 2.54 mm grid.
  UM1472's wording implies it does, but a dry fit costs nothing and a misjudged row spacing wastes
  the board.
- **Two PC ground paths now exist** - the fascia Mini-B ST-LINK (5.10) and the CAN debug port
  (HW-18) both tie PC ground to battery ground. *This made an isolated USB-CAN adapter a requirement;
  **waived 2026-10-07** (HW-18): both paths meet the same laptop at the same time, so isolating the
  CAN one alone does not break the ground tie.*
- **Height:** carrier + female header + Discovery is ~28 mm in a 50 mm gap. It fits, but board
  placement must still stay forward of **y ≈ 109** where the switch bodies intrude (MEC-02).

---

## MEC-09 · The two deck gaps are 50 and 40 mm - the panels are different parts

*Formerly HD-28.*

**Updated by MEC-13:** the upper panel's ports are no longer one row at local z 20; they are two rows, at z 26 and z 9.

**Decision (2026-09-20).** Measured on the built kit: the **lower gap is 50.00 mm and the upper is
40.00 mm**. The kit ships two standoff lengths. The fascia is therefore two different panels -
**52 mm** and **42 mm** tall - and MEC-03's "one blank, two panels" is dead.

**Where the wrong number came from.** Hiwonder's `.3dm` is the **single-plate** version: one 50 mm
standoff. Our 3-deck model was built by duplicating that plate *and its standoffs*, which silently
asserted a second 50 mm gap. MEC-02 then recorded "three decks at 52 mm pitch (confirmed on the real
kit)" - a confirmation that never actually happened. Tape measurements off the build photos put the
upper gap at ~45, close enough to 40 to prove the equal-gap assumption wrong but not to replace it;
the standoffs themselves settled it.

**The corrected stack.**

| | z |
|---|---|
| plate 1 | 27.12 … 29.12 |
| **lower gap 50** | 29.12 … 79.12 |
| plate 2 | 79.12 … 81.12 |
| **upper gap 40** | 81.12 … 121.12 |
| plate 3 | 121.12 … 123.12 |

**What changed in the model.** `fascia.scad` is now parameterised per gap: `SO_L`/`SO_U` drive
`GAP_L`/`GAP_U`, panel heights, and each panel's cut-out centre (`FZ_L` 25, `FZ_U` 20).

- **Lower panel: unchanged.** 52 mm tall, buttons at local z 25, vents at 8.5 and 41.5. The STL is
  identical to the pre-MEC-09 one.
- **Upper panel: 42 mm tall**, ports at local z 20 (world 101.12), pads at 0…5 and 35…40.
- **Its vents moved** to rows at 9 and 31 (`VENT_DZU` 11). A 40 mm gap leaves only two clear bands -
  5…13.7 and 26.3…35, between the pads and the DE-9 flange - and the rows sit centred in them,
  keeping the ~3 mm margins MEC-04 asked for. Slot pattern and columns are untouched.
- **Its labels moved** to z 34.5, between the upper vent row and the wrap line.
- **Volumes:** lower 20.5 cm³ (26 g PETG), upper 17.5 cm³ (22 g) - the upper panel got cheaper.

**Consequences.**

- **No interchangeability.** A panel fits one gap only. Mark them on the inside face before fitting.
- **Six M3 unchanged** - the pads sit at each panel's own top and bottom, so MEC-07 is unaffected.
- **Verified:** `PART="clash"` is still zero volume against the corrected stack (plate 3 at 121.12),
  both panels single solids, and `CLR=-0.3` still returns 159 mm³ as the control.
- **`chassis-3deck-fascia.obj` is corrected too** - `make-assembly.py` drops our duplicated deck 3
  by 10 mm and shortens its four standoffs to 40 mm about their bases. The right fix is in the
  source CAD; this keeps the mock-up honest until then.
- **The chassis layout drawing** now states both gaps and draws the elevation to scale.

**Still assumed:** that both panels' gaps are uniform across the vehicle - i.e. that all four lower
standoffs are 50 and all four upper ones 40. Worth a glance when the panels go in.

---

## MEC-10 · The chassis holes are three sizes - and half of them are M2.5, not M3

**Decision (2026-09-20).** Fixings follow the hole that is already there, not a single preferred
thread. Surveyed from Hiwonder's CAD via the chassis layout: **64 holes per plate, in three
classes**.

| ⌀ | Count | Takes | Used for |
|---|---|---|---|
| **3.18** | 32 | **M3**, close fit (0.09 mm a side - not a clearance fit) | fascia clamps, STM32 carrier |
| **2.71** | 28 | **M2.5** clearance | compute boards on their own standoffs |
| **2.47** | 4 | M2.5 tight / M2 | - |

**MEC-07's fixing holes are verified.** Both clamp positions sit on real holes at **distance
0.00**, both ⌀3.18, spaced **87.65 mm** against `FIX`'s 87.64. `fascia.scad`'s "existing 3.2 mm
plate holes" is right to 0.02 mm.

**The M3 grid.** The ⌀3.18 holes form a regular block over the rear two-thirds - x stations
**99.24 · 148.18 · 196.88 · 245.88** (pitch ≈ 48.9) against y **23.76 · 38.76 · 81.76 · 96.76**
(pairs 15 apart, pair centres 58 apart). Usable rectangles are therefore **48.9 / 97.7 / 146.7**
wide by **43 / 58 / 73** deep. Plus pairs at x 104.41, 186.12, 50.00 and the clamps at 262.94.

**The M2.5 grid** is sparser but has one large rectangle: **58.00 × 92.00** at x 169.88/227.88,
y 14.24/106.24 (with 86 and 80 variants using the inner y holes), and **71.10 × 48.60** at
x 49.00/120.06.

**Why this matters.** The intent was "M3 everywhere". **Half the plate cannot take M3**, and the
M2.5 assortment already bought is the right kit for those. Forcing M3 would mean drilling out
28 holes in an anodised plate - for no gain, since the boards' own standoffs are M2.5 anyway.

**Consequences.**

- **Boards mount M2.5 into ⌀2.71**, on their own standoffs, the way the FRDM already is.
- **The STM32 carrier is ours to design, so its holes go onto the M3 grid** - MEC-08's carrier
  should be re-cut so its four holes land on a chassis rectangle rather than wherever is convenient.
- **M3 in ⌀3.18 is a close fit.** With the fascia's two screws 87.65 mm apart and 0.09 mm a side,
  the panel pads carry the tolerance. If a panel fights going in, ease the *panel*, not the plate.
- The survey lives in the chassis layout drawing, which draws all 64 holes per plate to scale.

**Resolved by MEC-11.** The FRDM's pattern came out of NXP's drill file, not a measurement, and
the transverse hypothesis above was wrong - it mounts fore-aft on the M3 grid.

---

## MEC-11 · The FRDM's mounting holes land on the Hiwonder grid - 0.06 mm out

**Updated by MEC-18:** the board is about 95 x 65 mm, not 105 x 65 (the 105 is the non-S board's), and it now sits across the vehicle at x 184-249 on a tray; the 49.00 x 58.00 grid match below no longer applies to it.

**Updated by MEC-15:** the carrier's 49.00 × 58.00 pattern is gone. The kit-board carrier fixes to (148.18, 23.76), (148.2, 72.2), (169.88, 14.24) and (169.88, 100.24).

**Decision (2026-09-20).** The FRDM-IMX91 bolts **fore-aft to plate holes that already exist**, on
four of its six mounting holes, with **M2.5 screws and washers up through the chassis** into the
female standoffs the board already carries.

**Where the pattern came from.** NXP's design files (`FRDM-IMX91_DESIGNFILES-Rev A1`), drill file
`LAY-94610_A1-1-10.drl`, tool **T11 = 106 mil = 2.692 mm, non-plated, quantity 6** - M2.5
clearance, and six of them, matching the standoffs on the board. Neither UM12262 nor the QSG
publishes this; the drill file is the authority.

| FRDM hole (board datum, mm) | |
|---|---|
| (3.5, 3.5) · (3.5, 61.5) | 3.5 mm inset all round - confirms the 105 × 65 outline |
| (52.5, 3.5) · (52.5, 61.5) | |
| (101.5, **23.0**) · (101.5, 61.5) | the sixth is pulled inboard, so the six are **not** a grid |

**The match.** FRDM spacings are **49.00 mm in x, 58.00 mm in y**. The chassis M3 grid (MEC-10)
is **48.94 in x, 58.00 in y**. That is **0.06 mm out in x and exact in y** - the board was never
designed for this chassis, and it fits anyway.

| FRDM hole | Chassis hole |
|---|---|
| (3.5, 3.5) | **(99.24, 23.76)** |
| (3.5, 61.5) | **(99.24, 81.76)** |
| (52.5, 3.5) | **(148.18, 23.76)** |
| (52.5, 61.5) | **(148.18, 81.76)** |

Board then spans **x 95.74 … 200.74**, y 20.26 … 85.26 - 7.5 mm off the centreline, which is
free to swap to the y 38.76/96.76 pair if the other side suits the wiring better.

**Why M2.5 into a ⌀3.18 hole is right.** The chassis holes on that grid are ⌀3.18, so an M2.5
screw has 0.34 mm a side of slop. **A washer spans it** - and the kit already bought has 60 of
them. The slop is a feature here: it absorbs the 0.06 mm pitch error without a fight.

**Consequences.**

- **Only four of the six holes are used.** The fifth (101.5, 23.0) has no chassis hole near it and
  the sixth is 0.36 mm out. Four M2.5 on a 105 × 65 board is ample.
- **Both boards cannot share plate 2.** The FRDM occupies x 95.7–200.7, which swallows the 196.88
  x-station. The STM32 carrier needs its own deck - see the layout note below.
- **The carrier is ours, so its holes are designed onto the grid**, not measured off it: four at
  **49.00 × 58.00**, which is an exact chassis rectangle (x 196.88/245.88 against y 23.76/81.76).
  That supersedes MEC-08's arbitrary 80 × 120 outline.
- **Recommended split:** carrier on **plate 2** (its I/O - servo PWM, I²C, motor module - all runs
  down to plate 1), FRDM on **plate 3** (Ethernet and Wi-Fi 6 want clear air, not a metal plate
  10 mm above them). Both plates are identical, so both use the same grid coordinates.

**To confirm.** Standoff height under the FRDM: the microSD is on the **underside** and a card is
fitted, so the standoff sets card access, not just clearance.

---

## MEC-12 · Component allocation across the three plates

**Updated by MEC-16:** plate 1's floor now carries only the battery (moved to x 85-162, behind the tie rod) and the driver. The buses, fuses, INA226, UBEC and splices are taped to plate 2's lower face, and the (−) B bus is gone.

**Updated by MEC-15:** on plate 2 the carrier is x 117.0-215.0 (boards to x 187.0), and board C, the 5 V split, sits across the waist at x 85.5-115.5.

**Updated by MEC-18:** on plate 3 the FRDM and, later, the Raspberry Pi 5 ride on one compute tray, both across the vehicle, with a spare pad in the nose.

**Updated by MEC-17:** the Bauer sits at x 11-75, screwed to the carrier tray through its own two holes, and the S6 / S7 splices are in two lanes either side of it; the carrier and board C ride on the same tray.

**Decision (2026-09-21).** Parts sit where their function puts them, not where a rule puts them.

| Plate | Carries |
|---|---|
| **1** (z 29.12) | front to rear: steering servo and axle, **battery** (x 55-132), **INA226** and **UBEC** above a **3 x WAGO 221-415** column (x 135-153.6), **motor driver** (x 158-200), motors from x 203.2 |
| **2** (z 81.12) | **STM32 carrier** (x 93.2-223.2) and the **Bauer 50 W converter** (x 20-85). Rear region x 224-266 left clear for the harness |
| **3** (z 123.12) | **FRDM-IMX91S** |

**Order along the vehicle (revised 2026-09-21).** The first cut put the motor driver at x 54-96,
so both motor looms ran the length of the chassis to reach the motors at x 203. The driver now
sits at **x 158-200, 3.2 mm clear of the motors**, and the battery moved forward into the waist
to make room. The heavy, electrically noisy motor wiring is now the shortest run on the plate
instead of the longest, and it no longer crosses the sensing and distribution area.

**Why this split and not "power low, compute high".** That rule was the starting point, but two parts
argue harder than the rule:

- **The INA226 cannot leave plate 1.** Its shunt is in the battery path, so moving it up would drag
  the full pack current onto the compute deck. The same logic keeps the WAGO buses low: they are
  where the high current is distributed, and the switches they feed sit in the lower gap.
- **The UBEC belongs near the servo**, which is at the front of plate 1. Putting it on plate 2 would
  run 6 V down a deck and back forward for no gain.

**Why the converter goes up.** The Bauer feeds only 5 V loads, both of which are above it: the
carrier on plate 2 and the FRDM on plate 3. Plate 1 also has no contiguous space left once the
battery (99.9-176.9) and motors (from 203) are placed; the free gaps there are 52 mm at the waist
and 26 mm behind the battery.

**Consequences.**

- **12 V climbs one deck and comes back down.** Battery on plate 1, converter on plate 2, motor
  driver back on plate 1. Accepted: the alternative was no home for the converter at all.
- **The rear of plate 2 (x 224-266) is deliberately empty.** That is where the harness to the three
  fascia debug ports fans out, and filling it would make the one part of the loom that gets
  unplugged regularly the hardest to reach.
- **Plate 1 packing is now high.** Region A (x 52-98) holds the motor driver, region B (x 177-203)
  the WAGO column, and the band above the battery the INA226 and UBEC.

**To confirm.** **Two footprints on the drawing are placeholders**, and both are on the critical
path: the **Bauer 50 W** (drawn 65 x 55) and the **Hiwonder motor driver** (drawn 40 x 60). Neither
is measured, and the Bauer is the larger risk since plate 2's front region is only 80 mm wide at
the waist.

---

## MEC-13 · The debug ports mount from behind, in two horizontal rows

**Decision (2026-09-24, layout revised 2026-09-25).** Both panel-mount extensions sit in
**pockets on the inside face** of the upper panel, not on its outside. All three ports are
**horizontal**, in **two rows**: the DE-9 alone on top, the two USB debug ports side by side
below. The layout is **centred on what shows on the face** (the flanges are hidden inside): the
DE-9 on the chassis centreline XC, the two USB sockets 19 mm either side of it, and the group
centred on the 42 mm face height. Every connector body clears the rear standoffs:

| Row | x | Port | Mounting | Held by |
|---|---|---|---|---|
| top, z 26 | **+2.48** (XC) | DE-9 (4.5), unchanged in itself | from behind, as before | its own screws, as before |
| bottom, z 9 | **−16.52** (XC − 19) | USB-C (5.9), flange 23 × ~8.3 × 6 deep | pocket 23.6 × 9.0, **1.2 mm skin**, rim slot 9.6 × 3.8 | its own **2 × M2.5 × 5** from outside, through the skin into the flange's metal inserts |
| bottom, z 9 | **+21.48** (XC + 19) | Mini-B (5.10), flange **36 × 10 × 8 deep** | pocket 36.4 × 10.4, **1.5 mm skin**, grip aperture 14 × 9.5 | its own M2.5 screws from outside, inboard hole round, outboard a slot |

Local z is measured from the top of deck 2; world z is 81.12 higher (top row 107.12, bottom row
90.12).

**What the parts showed (measured 2026-09-24).** Both extensions have **threaded M2.5 holes** in
the flange face, so the screws come from the front and the flange has to sit behind the wall.
Neither body can pass through the panel. And the Mini-B flange is **36 mm**, not the 28 read off
the vendor photo in MEC-05.

**Why.**

- **The bodies run forward into the vehicle, past the rear standoffs.** The USB-C body is ~14 wide
  and ~40 long; at MEC-05's x −28.58 it overlapped the left standoff (flat at x −32.61) by ~3 mm.
  Only the flanges had ever been modelled, never the bodies. At **x −16.52** it clears by **9.1 mm**.
  The Mini-B body (~20 wide) at x 11.5…31.5 clears the right standoff (flat at x +37.57) by 6.1 mm.
- **Three flanges side by side no longer fit.** 23 + 30.84 + 36 = 89.8 mm on a 94.24 mm face, and
  the two standoffs pin the outer bodies inward. Two rows take the width problem away: the bottom
  row carries 23 + 36 = 59 mm with 8.5 mm between the flanges, and the DE-9 has its row to itself,
  so it goes back on the chassis centreline.
- **Centred on what is visible.** The flanges sit behind the wall, so centring them would leave the
  sockets off-balance. The sockets, screws and labels are what the eye reads, so the USB sockets
  are placed symmetric about the DE-9 (±19) and the visible group, apertures at z 4.25 up to the
  CAN label at 37.75, is centred on the face height.
- **The rows fit the 40 mm gap with room left.** Bottom-row flanges span z 4…14, the DE-9 flange
  z 19.7…32.3, which leaves 5.7 mm between the rows and 7.7 mm to the wrap line at z 40. Nothing
  in either row reaches the fixing pads (z 0…5 and 35…40, x beyond ±36.7).
- **The USB-C uses its own screws, the way the vendor's bracket does.** The part ships with a
  ~1 mm steel bracket and two M2.5 × 5 screws driven from the front into the flange's metal
  inserts. The heads are **~4 across, 15 apart**, which leaves **~11 mm** clear between them. The
  bench cable's round grip is **10 mm** (tape-measured), and a photo of it seated in the vendor
  bracket confirms it clears the heads. Metal threads survive any number of refits.
- **The Mini-B uses its own screws too.** They are ~28.5 apart, so the heads sit ~11.7 mm from
  centre, far outside any Mini-B grip.
- **Skins, not full walls, in front of the sockets.** The USB-C metal rim stands ~0.9 proud of its
  flange, so a 1.2 skin leaves the socket face ~0.3 below the outside and the plug seats with the
  grip clear of the panel. The Mini-B surround is flush with its ears, so its grip enters a 1.5 mm
  skin through a generous aperture.
- **Rejected: the Mini-B standing upright** in a single row (USB-C −25.0 · DE-9 +3.25 · Mini-B
  +25.0, 2026-09-24). It fitted, but left one port turned 90° to the others and pushed the STM32
  label onto its side. Two horizontal rows read as one panel and give every part more margin.
- **Rejected: two rows packed to the left** (USB-C −25.0, Mini-B +12.0, rows at z 11 and 28). The
  first two-row draft kept the USB-C where the single row had it, which left the group visibly
  off-centre and the USB-C body 0.61 mm from its standoff.
- **Rejected: turning the DE-9 around**, mounting it from the front so its flange sits outside the
  others. In the single-row layout it would have put the DE-9 flange on the outer face exactly
  where the Mini-B's screw heads went.
- **Rejected: a printed clip behind the USB-C flange.** It was designed first, for the worst case:
  the USB-C spec allows a plug grip up to **12.35 wide**, which would land on the heads and stop the
  plug ~1.8 mm short of seating. The clip pressed the flange's side shoulders and was screwed to two
  printed bosses. It worked with any cable, but it added a part and put the thread in printed PETG
  instead of the flange's metal inserts. Dropped once the real cable proved narrow enough. Thinning
  the wall or countersinking the heads does not fix a fat grip: a countersunk M2.5 head is ~1.5
  tall, and only ~0.9 mm lies between the flange face and where the grip ends up.

**Consequences.**

- **The USB-C debug lead must have a slim grip, under ~11 mm.** The 10 mm bench cable fits. Most
  chunky USB-C cables (11.5-12.5 mm) will stop on the screw heads and not seat. Keep one slim
  cable as the robot's debug lead.
- **Each label sits directly above its port.** IMX91 and STM32 at z 14.75…19.25, between the
  screw heads and the DE-9 aperture; CAN at z 33.25…37.75, above the DE-9.
- **The upper vents are laid out after the ports, in the space they leave (updates MEC-04 for
  this panel).** Little heat sits behind this panel (the 5 V converter at under 1 A, the STM32
  carrier), so the slots stay short and the face stays stiff: one upright slot at each end (XC ± 42,
  z 12…28) and two flat slots in each top corner beside the DE-9 (XC ± 28.25, z 23 and 30, 12 long).
  80 mm of slot. The right upright keeps 3.3 mm of web to the Mini-B pocket. Dropped on the way: a
  118 mm set of long slots, too little face left to keep the panel stiff; and a 40 mm set matched to
  the lower panel's columns, symmetric but too little air.
- **The upper panel is now 16.7 cm³** (~21 g PETG).
- **`PART="portclash"` is a second gate**, beside `clash`. It checks rough stand-ins of the three
  connectors, including the screw heads, against the upper panel, the rear chassis and each
  other. It renders **zero volume**; the faces it returns are the flange-on-pocket contacts.
- **No thin margins left.** The closest are 6.1 mm from the Mini-B body to the right standoff and
  3.3 mm of web between the right vent and the Mini-B pocket.

**To confirm.**

- **USB-C body width** behind the flange: 14.0 is read off a photo. It is no longer critical:
  anything up to ~31 mm clears the standoff.
- **The grip limit** rests on a tape measure: collar 10, heads 4, so ~0.5 mm a side. The photo of
  the cable seated in the vendor bracket is the stronger evidence.
- **Mini-B screw pitch** (~28.5, photo). The outboard slot takes 27…30.
- **Mini-B body**, ~20 × 10 × 13 (photo). It has 6.1 mm to the standoff, so it would have to be
  over 32 mm wide to touch.
- **The DE-9 rear insulator** is assumed 19 × 10.5 × 8 in the stand-in, not measured.
- **The USB-C body against the STM32 carrier - closed by MEC-15:** the boards now end at x 187, and the Discovery reaches x 215 only at z 101 or higher, so even a 40 mm body clears by 5.3 mm. *Original note:* If the drawing's 40 mm body
  is all behind the flange, the body ends at y 87.7; the carrier's rear edge (MEC-12, plate x 223.2)
  is at y 84.8. That leaves **2.9 mm** at the carrier's height, and the cable still has to leave the
  body and bend up to the FRDM on deck 3. If the 40 mm includes the 6 mm flange, the gap is 8.9 mm.
  `portclash` cannot see this: it checks the plates and standoffs, not what sits on them. Moving
  the port sideways does not help, since the carrier spans that width. It is a packaging question,
  not a print one: measure the body length behind the flange, then either shift the carrier
  forward (up to ~8 mm before it meets the converter at x 85) or route the cable around it.

---

## MEC-14 · The switch drawing closes the lower panel - and its holes open to 22.4

**Decision (2026-09-24).** The lower panel's two switch holes are **⌀22.4**, up from 22.2. The
vendor drawing for the 22 mm switches (3.5a/3.5c) settles everything else the printed part
depended on, so the lower panel is ready to print.

| From the drawing (22 mm version) | What it settles |
|---|---|
| Thread **M22 × 1**, mounting hole 22 | the hole |
| Bezel **⌀24.8 × 2.0** | sits on the outer face. The DRIVE / LOGIC labels, moved to z 41 for the top vent row, clear it by 1.35 mm |
| Nut **25.0 A/F, 28.5 across corners** | under MEC-07's ~30 mm limit before a nut reaches the pad bands. The two nuts, 44 apart, are 15.5 mm apart |
| Thread length 14.2 | 3 mm wall plus nut uses ~6 of it |
| Body **20** behind the bezel, tabs **5** more | 25 mm: exactly the depth MEC-07 assumed, ending at y ≈ 109.9, 8 mm clear of the motors |
| Tabs **4.8 mm** wide | not 6.3 as BOM 3.17 assumed |

**Why 22.4.** 22.2 left 0.2 mm over a 22.0 thread. FDM holes from a print service commonly come out
0.1-0.2 mm small, which would leave the thread binding or no clearance at all. The bezel and nut
cover a 22.4 hole with 1.2 mm to spare a side.

**Consequences.**

- **MEC-07's "check before printing" is closed** for the switch itself: nut size and bare depth
  are on the drawing.
- **The wiring on the tabs is still open.** The red plug-on socket harness runs straight back;
  if the bezel-to-wire-exit depth is over ~33 mm it reaches the motors. The seller has been asked.
  The fallback is 4.8 mm flag (right-angle) receptacles, which add only 2-3 mm past the tabs.
- **BOM 3.17 is 4.8 mm receptacles, not 6.3.**
- **The lower panel's vents are redesigned for cooling (updates MEC-04),** 2026-09-25. The heat is
  behind this panel: the motor driver at the rear of plate 1, the UBEC, the battery. So it gets most
  of the open area, low to let air in by the driver and high to let warm air out:
  - a **centre ladder** between the switches, five 12 mm slots at z 8…40 with 5 mm bars;
  - an **upright slot at each end**, XC ± 41, z 8…42, 34 mm long;
  - a **top row** over each switch, XC ± 22, z 47.5, 18 mm long.

  164 mm of slot, against 60 originally. MEC-04's rule is kept in its intent rather than its
  letter: no slot comes within ~10 mm of a switch hole (the top row is 9.8 mm above), and none
  cuts into the nut footprint on the inside (25 A/F, 28.5 across corners). The closest is the
  centre ladder, 1.6 mm from a nut corner turned towards it. The DRIVE / LOGIC legends drop from
  z 43 to **z 41** to make room for the top row (updates MEC-06). The panel is 19.6 cm³.
- **Drag is not a concern.** A reader may worry the rear panel acts as an air brake at speed. At
  1.5 m/s it is ½ · 1.2 · 1.5² · 1.2 · 0.012 m² ≈ **0.02 N**, and about 0.2 N even at 5 m/s,
  against ~0.4 N of rolling resistance for a ~2 kg vehicle. What matters at speed is the panel
  staying put under vibration, which is MEC-07's clamp, unchanged by the vents.
---

---

## MEC-15 · The carrier is two kit boards joined by the Discovery, not one board

**Revised 2026-10-25: the NUCLEO-H533RE replaces the Discovery (HW-22).** The decision stands with a
different board: A and B are rebuilt on fresh boards and joined by the Nucleo's morpho headers. See
"Revision 2026-10-25", the two 2026-10-26 revisions and the 2026-10-27 one at the end. Everything about P1, P2 and the
Discovery below is the earlier build.

**Hole names changed 2026-09-29.** Holes are now named as **printed on the kit boards**: letters
A-X along the 70 mm side, numbers across, A1 bottom-left with the print readable, written board·hole
(A·K12). On A and B, header row n is letter X for row 1 back to A for row 24; P1 sits on A's
columns 10 (odd) and 9, P2 on B's 12 (odd) and 11. The fixings are **F1-F6**, so no fixing name
reads as a hole. The drawing computes every name from the geometry. Older text in this record uses
the drawing's first scheme, column letter + header row: A g14 is A·K12, B d14 is B·K15, and on
board C e4 is C·F4 and e21 is C·F21 (they were C·D6 and C·U6 until 2026-10-05, when C's print
was found to run the other way round: numbers along the long side, letters across).

**As built 2026-10-03: the CAN module lies face down, and A takes its ground from its own P1-5.**
The module's 1×4 socket is at B·F5-F2 (CTX, CRX, GND, 3V3) and its CAN H / L come down through a
1×2 socket at B·M4 / M3. Only the 3V3 bridge crosses between the boards. See the last three
revisions at the end.

**As built 2026-10-03: A's P1 sockets went in one hole toward CN1.** Only A is affected; B's
sockets are as drawn. A's grid now sits one pitch forward of B's, P1 pins 1/2 are not connected,
and B and the Discovery sit 2.54 mm further back on plate 2. See "Revision 2026-10-03" at the end.

**Rerouted 2026-09-30: every wire is insulated and runs pad to pad.** Wires meet only at pads,
no pad takes more than two wire ends, and the bare spines and bridges are gone. See "Revision
2026-09-30" at the end.

**Revised 2026-09-29: board A is a second 5×7 board, and the sockets are 1×25.** A keeps its outboard
edge and every hole name, and grows inward to 5.9 mm from B. The GND and 3V3 bridges now cross a
5.9 mm gap instead of about 50 mm of open air under the Discovery. Row 25 (pins 49/50, GND on both headers) is socketed: its tail is snipped and the
socket rests on the board margin, which has no hole there. See "Revision 2026-09-29" at the end.

**Decision (2026-09-28).** The carrier is built from the prototype kit that is in hand (BOM 5.11), as
**two boards under the two headers**: **board A**, a 3×7 cm board (10 × 24 holes), under P1, and
**board B**, a 5×7 cm board (18 × 24 holes), under P2. Each carries two 1×24 female sockets. The
Discovery plugs into both and is what holds them 53.34 mm apart. The USB-C pull-ups and the 5 V bulk
capacitor go on a third board, C, which is HW-19's business. The build drawing is
[`stm32-carrier.svg`](../hardware/renders/stm32-carrier.svg).

**Why.**

- **Nothing in the kit spans the Discovery and leaves room outboard.** *Corrected 2026-09-29:* the kit
  holds 6 × 2×8, 6 × 3×7, 3 × 4×6, 3 × 5×7 and **one 7×9 cm board**. This record first said the 7×9 was
  not in the kit; it is. The outer header rows are 53.34 mm apart (UM1472 Fig. 10), 22 holes across, and a
  header is 25 rows long. The 7×9 (24 × 30) takes both headers, but the 66 mm Discovery covers its 70 mm
  width, so every terminal, the 470 µF can and the module would have to sit under the board. Its five
  spare rows can only stick out at the front, into board C and the plate's waist.
- **The Discovery is a better jig than a ruler.** Soldering the four sockets with the board plugged in
  puts A and B exactly where the pins are, which a single large board would only do if its grid and
  the Discovery's agreed.
- **24 rows of holes are enough.** Row 25 is pins 49/50, GND on both headers, and GND already enters
  at row 1. Every net the carrier uses is in rows 1-18. *Since 2026-09-29* row 25 is still socketed, for
  grip, without a hole (see the revision below).
- **Tall parts go outboard.** Terminals, the servo and I²C headers, the capacitor and the SN65HVD230
  sit beyond the Discovery's edge, so the part of each board under it carries only wire and resistors.
  B needs the wider board because the transceiver module lives there.

**Rejected.** One 2×8 rail per header (25 rows): the 8 columns leave about 10 mm outboard, too
narrow for the 470 µF can or the module. Cutting and butting two 5×7 boards across the middle: it adds
a seam without adding anything the Discovery does not already provide.

**Consequences.**

- **The carrier is 98 × 106 mm, not 130 × 85:** 70 mm of board plus the Discovery's 28 mm rearward
  overhang, and 106 mm across. It needs the full-width part of plate 2, which runs from x 114 and is
  about 115 mm wide there.
- **Where it sits (2026-09-28).** Header row 1 at **chassis x 181.20**, boards from x 117.0 to 187.0,
  the Discovery's rear edge at x 215.0. *As built since 2026-10-03: B is x 119.54-189.54, header
  row 1 at x 183.74, the Discovery's rear edge at x 217.54. A is unchanged.* Board A's outboard edge at y 4.95 (5.11 since 2026-09-29), board B's at y 110.99. The
  window was narrow: the front is held by the plate's full width starting at x 114, and the rear by
  the fascia port bodies near x 220 and the harness zone behind x 224.
- **Fixings, all into holes plate 2 already has.** Only one M3 cross-line (x 148.2) and one M2.5 line
  (x 169.88) fall on the boards in that window, and the parts on A and B were moved to suit them:

  | Fix | Board hole | Chassis hole |
  |---|---|---|
  | F1 (was A1) | A·K12, on grid | M3 ⌀3.18 (148.18, 23.76) |
  | F2 (was B1) | B·K15, 0.18 mm | M2.5 ⌀2.71 (148.2, 72.2) |
  | F3 (was A2) | A, between T16 and S15, off grid | M2.5 ⌀2.71 (169.88, 14.24) |
  | F4 (was B2) | B, between T4 and S4, off grid, under the module | M2.5 ⌀2.71 (169.88, 100.24) |

  A 21.7 × 86 mm four-point pattern. ⌀3.2 in the board, **M2.5 on 10 mm standoffs**, a washer in
  every ⌀3.18 hole, as for the FRDM (MEC-11). Drill F1 and F2 on the grid, screw the carrier down,
  then mark F3 and F4 from under the plate. 10 mm keeps the solder side, wires included, well
  off the aluminium, and the stack still clears plate 3: the Discovery's top is at about z 111
  against the FRDM's screw heads at z 119.4 under plate 3.
- **Board C sits across the waist**, x 85.5-115.5 and y 25.2-95.2, between the Bauer and the
  carrier with 1.5 mm to spare at each side. Its terminals are at the two short ends, facing the
  plate edges, because there is no room at the front or rear for wires to enter. *Since
  2026-09-29 the row-1 end carries the USB-C socket instead, opening to the vehicle's right
  (HW-19). The plug stands about 20 mm past the plate edge there, which is still to be checked.* It is fixed at
  **F5 at C·F4 and F6 at C·F21** to the M3 holes (99.24, 38.76) and (99.24, 81.76), which are 43.00 mm apart:
  17 rows plus 0.18 mm. The Bauer's position is still a placeholder, and if it moves rearward it
  meets C.
- **MEC-13's USB-C clearance question is closed.** The boards now end at x 187 (B at 189.54 as
  built). Only the Discovery reaches x 215 (217.54 as built, 2.8 mm short of the body's end), and it does so at about z 101 or higher, above the bottom-row ports at z 90. A
  40 mm body behind the flange, which ends at x 220.3, still clears by 5.3 mm.
- **The two boards meet only through the Discovery and two soldered bridges** (GND and 3V3). *Since
  2026-09-30* each bridge is one insulated wire, from a P2 pin to the part it feeds on A. *Since
  2026-10-03 only the 3V3 bridge is left*: A takes its ground from its own P1-5.
- **Hook-up wire is not in the BOM.** The Dupont leads are copper-clad aluminium (5.7) and are not
  used for anything soldered here.

**To confirm.**

- The kit's hole counts. The drawing assumes the usual 18 × 24 for A and B and 10 × 24 for C.
- The SN65HVD230 module's outline. B reserves rows 3-17 by columns k-r, about 36 × 21 mm, and the
  module is socketed so that it can move within that. F4's screw sits under it, so the module comes
  out to reach that screw.
- That six 10 mm M2.5 standoffs are in the M2.5 kit. They are not in the BOM.
- Clearance under the Discovery with it seated. The design only needs resistor height there.

**Revision 2026-09-29 · two 5×7 boards, 1×25 sockets.**

- **Board A is a 5×7 (18 × 24), not a 3×7.** Its col a keeps its place, so everything in cols a-j keeps
  its hole name. Cols k-r are new and sit under the Discovery. The outboard edge moves 0.16 mm in, to
  y 5.11, and the inboard edge is at y 55.11. B is unchanged, from y 60.99, so the boards are **5.88 mm
  apart**. That gap is not a choice: A holds P1 at cols i/j and B holds P2 at g/h, and the Discovery
  fixes the rest. Butting the boards would take a 0.8 mm gap, and B would lose its outer two columns.
- **The bridges** *(as rerouted 2026-09-30; the GND one was replaced on 2026-10-03 by A's own
  P1-5)* are one insulated wire each: GND from B·X12 (P2-1) to A·V16 (6V IN −), 3V3 from B·V12
  (P2-5) straight to A·D16 (I2C-A VCC). Nothing lands in A's V column,
  so A·V9, which is P1-4 (VDD behind JP1), stays clear of the 3 V rail. Both boards are screwed down,
  so the short span across the gap cannot flex.
- **1×25 sockets.** Cut four strips of 25 from the kit's 40-pin female headers and snip each 25th tail
  flush. Row 25 falls 3.25 mm from the board's end, on the bare margin, clear of the corner holes (the
  sockets are mid-board). All 100 pins are held. Pins 49/50 carry no current through the carrier.
- **Kept:** the fixings and their hole names, the 106 mm width, the placement on plate 2 and board C.
  A now covers x 117-133, y 40-55 of plate 2's opening. The 6 V pair and the driver's I²C lead still
  rise through it at x 114-117, in front of the boards, as MEC-16 routes them.
- **Kit use:** 2 of the 3 5×7 boards (A, B) and 1 of the 6 3×7 boards (C).

**Revision 2026-09-30 · insulated wire, pad to pad.** The build uses insulated wire throughout, and
insulated wire can only be joined at a pad. The routing is redone to suit.

- **Every wire runs pad to pad on the solder side.** A wire meets another only at a pad, and no pad
  takes more than two wire ends. A pigtail or link arriving through the hole counts as one of them.
  Crossings are fine; running along another wire, or under a standoff, is not.
- **Nets with several pins are chains, part to part.** On A, GND runs 6V IN − → C2 − → SERVO →
  I2C-B → I2C-A, and 6 V runs 6V IN + → C2 + → SERVO +. On B, each P2 supply pin feeds one thing:
  P2-1 the CAN GND and the GND bridge, P2-2 the 5V IN return, P2-4 the 5V IN feed, P2-5 the 3V3
  bridge, P2-6 the transceiver. The Discovery ties each pair internally, which is what makes that
  legitimate.
- **Wire.** The servo current on A and the FRDM current on C run in **18 AWG silicone copper** (BOM
  3.11). Everything else is **22 AWG insulated copper hook-up wire**, still not in the BOM, and not
  the CCA Dupont leads (5.7). *(R1 and R2 were dropped on 2026-10-07, so C has no bent leads any more, HW-19.)*
- **A's P1 GND pins are no longer wired.** A's ground arrives through the GND bridge, and with the
  Discovery in, through its ground plane as well. *Reversed on 2026-10-03: the bridge is gone, and
  A's ground comes from its own P1-5 (last revision).*
- **The drawing's routing is checked by a script**, [`../tools/check-carrier-routing.py`](../tools/check-carrier-routing.py).
  It checks every net end to end through the Discovery's own pin ties, looks for shorts, and counts
  wire ends per pad. It also checks standoff clearance, overlaps, and wires lying over another net's
  joint. Run it after any change to the carrier.

**Revision 2026-10-03 · A's P1 sockets as built, one hole toward CN1.** The two P1 strips on
board A were soldered one hole toward the ST-Link end. P2 on B is as drawn. Rather than desolder
two 25-pin strips, the drawing follows the board.

- **What it means on A.** Discovery header row n now sits over A's hole row n - 1. **P1 row 1
  (pins 1/2, GND) hangs past A's last hole and is not connected.** Row 25 (pins 49/50) is soldered
  in hole A·A, so P1's tails cover A·A-X in columns 10 (odd pins) and 9 (even pins). Nothing used
  P1-1/2: A's ground came over the GND bridge (B·X12 → A·V16), and since the last revision comes
  from P1-5. P1-49/50 at A·A10 / A·A9 are GND
  and spare.
- **Three wires move one hole:** PE9 from A·K10 to **A·L10**, PB10 from A·H9 to **A·I9**, PB11 from
  A·G10 to **A·H10**. Every part on A keeps its holes. The routing check passes on the as-built map.
- **Because the Discovery holds both headers, A's grid is one pitch forward of B's.** In the
  chassis, A stays where it was: moving it forward would put its front edge 1 mm into board C,
  which is fixed by F5 and F6. **B and the Discovery move 2.54 mm rearward instead.** B is now
  x 119.54-189.54, header row 1 is at x 183.74, and the Discovery's rear edge is at x 217.54.
- **Fixings.** F1 and F3 on A are unchanged. On B, the plate holes now fall one row further along:
  **F2 at B·J15** (was K15), still on grid, and **F4 between S4 and R4** (was T4 / S4), marked from
  the plate as before. If F2 is already drilled at B·K15, drill B·J15 as well; the plate hole decides.
- **Clearances.** The Discovery's rear edge comes 2.54 mm closer to the fascia's port bodies. The
  USB-C extension's 40 mm body, ending at x 220.3, still clears by 2.8 mm, and it sits lower than
  the Discovery anyway. The CN1 plug of the Mini-B extension (5.10) has 2.5 mm less room behind it.
  **Check on the vehicle that the plug and its cable still bend clear.**

**Revision 2026-10-03 · the CAN module lies flat.** *(Face up and row 16 below were superseded the
same day: it went in face down, at row 19; see the next revision.)* The SN65HVD230 module in hand (BOM 4.1,
[`SPECS.md`](../bom/parts/4.1-SN65HVD230-Module/SPECS.md)) is **26.98 × 10.24 mm**, with a straight
header in its own plane. Plugged upright into its socket it would reach about 50 mm above plate 2,
and plate 3 is 40 mm up. The 25 × 18 mm flat module this record assumed was never the real part.

- **It lies flat, component side up,** about 10 mm above board B. Its four pins are bent 90° at the
  spacer, or its header is swapped for a right-angle one from the 5.11 kit. The screw terminal's
  top is then about 21 mm above B, well under plate 3.
- **Its socket moves from row 13 to row 16 (B·I5-I2)**, and the module points to the rear. Its
  terminal ends 8.6 mm short of B's CAN terminal, which is room for the H / L links, whose wires
  enter the terminal from the module's end. It stays clear of R3a / R3b and the TERM header in
  front, and outboard of the Discovery.
- **F4's screw head sits under the module's far end.** It is low enough; as before, the module
  comes out to reach it.
- **The four solder-side runs to the socket move with it** (3V3, GND, CAN TX, CAN RX). They are
  shorter than before, and the routing check passes.

**Revision 2026-10-03, later · the CAN module is face down, and CAN H / L use its 2-pin header.**
The module was bent toward its component side, so it lies **face down**. That changes four things
against the face-up revision above.

- **Pin order reverses across the socket.** The 1×4 socket now reads **CTX, CRX, GND, 3V3** from
  column n to q. It moves to **row 19, B·F5-F2**: at row 16 or 18, the screw terminal that now hangs
  under the module's far end would sit on F4's screw head. At row 19 it clears by 2.3 mm.
- **CAN H / L come down through the module's own 2-pin header**, which now points at the board, into
  a **1×2 socket at B·M4 (CANH) / B·M3 (CANL)**. That is seven holes behind the 4-pin row: the
  module has 17.55 mm there, so the pin bend is set to land it. **No link wires, and the screw terminal
  is unused.** The module plugs in and out as one part.
- **On the solder side** CAN H chains CAN terminal → socket → R3a, and CAN L chains CAN terminal →
  socket → TERM. The transceiver's GND now comes from the 5V IN return (B·B2), and its 3V3 runs
  along B's outer edge to clear F4. Routing check passes.
- **To measure:** the screw terminal's real height. 1.5 mm off the board is the estimate for a
  10 mm terminal. If it touches, it is plastic and may rest on the board, but nothing may be
  soldered under it.

**Revision 2026-10-03 · A takes its ground from its own P1-5.** The GND bridge (B·X12 → A·V16) is
replaced by one wire on A, **A·W10 (P1-5, as built) → A·V16 (6V IN −)**, the head of A's ground
chain. The Discovery ties all its GND pins together, so A's servo, I²C and INA226 grounds reach
the STM32 through it, as on B. **One wire still crosses between the boards: the 3V3 bridge**
(B·V12 → A·D16), built as a soldered end and a plug. Routing check passes.

**Revision 2026-10-25 · the NUCLEO-H533RE on A and B.** The Discovery failed (HW-22) and the
NUCLEO-H533RE takes its place. Boards A, B and C, their standoffs and the tray (MEC-17) keep their
places on plate 2; A and B are rebuilt on fresh boards (Hedi: no desoldering of the old sockets).

- **Sockets.** The Nucleo plugs in by its ST morpho headers, whose rows are **63.50 mm apart** (25
  pitches, UM3121 Fig. 7). Each board's sockets move two columns outboard of the Discovery's: **A g/h
  under CN10, B i/j under CN7**, four 1×19 female strips, every tail in a hole (A rows 5-23, B 6-24).
- **Position.** The board sits 5 rows forward of the Discovery's row 1, **rear edge at plate 2 x 202.7**.
  Its top is at z 113.8, 4.8 mm under the plate-3 screw heads, none of which is over a tall part.
- **The parts follow the pins.** Every CAN and I2C1 pin the carrier uses is on CN10, and the only supply
  pins are on CN7 (HW-22), so **A carries the CAN side**: the SN65HVD230 module, the CAN terminal and
  the two I2C headers; **B carries power and the servo**: 5V IN to E5V, 6V IN, C2, R4 and the SERVO header.
- **One wire crosses between the boards: 3V3**, from CN7-16 on B to I2C-A's VCC on A, which feeds the
  transceiver. A takes its ground from its own CN10-9 and CN10-20; the Nucleo ties its grounds.
- **I2C headers in each module's own order**, so a straight lead is right: I2C-A is VCC, SDA, SCL, GND
  (the INA226 module), I2C-B is SCL, SDA, GND (the motor module) with pin 4 not wired. The mismatched
  order is what took the Discovery. Both are 90° headers **on top of A**, along the gap to B, pointing
  forward; their leads leave A's front edge over the tray window. **The solder side carries wires only**
  (Hedi).
- **Left out:** R3a, R3b and the TERM jumper (HW-09: the module's own 120 Ω terminates this end), and
  any LED on the carrier (Hedi). The node's only user LED is the Nucleo's LD2.
- The drawing, the 3D model, the routing check and the layout follow (`stm32-carrier.py`,
  `carrier_model.py`, `check-carrier-routing.py`).

**Revision 2026-10-26 · board B on a 3×7.** A and B are rebuilt on fresh boards for the NUCLEO-H533RE
(revision 2026-10-25 above), and only one 5×7 is left in the kit.

- **A keeps the 5×7.** It uses all 18 columns: the CAN module and its terminal outboard (a-d), the
  CN10 sockets (g/h) and I2C-A out to column r.
- **B moves to a 3×7 (10 × 24).** Every part on B is in columns i-q: the CN7 sockets (i/j), R4 (k),
  SERVO (m-o), C2 (n) and both terminals (q). The 3×7 covers i-r, flush with the old outboard edge
  (plate 2 y 81.15-111.15, 0.16 mm further out), with the same 24 rows, so no part and no wire moves.
  The scripts keep the 18-column letters; the printed names follow the 3×7's own print, as on C:
  numbers 1-24 from the front, letters A-J from column r inward, A1 at the front outboard corner.
- **The gap between A and B is 26 mm, not 5.9.** Only the 3V3 bridge crosses it, one insulated wire,
  laid along the tray.
- **Three corner holes on B, not four** (MEC-17). The front inboard one is 2 mm from the end of the
  CN7 socket, so a screw head or nut there would sit against it.
- **Not used:** the 7×9 (90 mm across where the carrier needs 106, and none of its holes meets the
  tray), the 4×6 and the 2×8 (too short for the 19-row socket and the terminals, or too narrow).
- **Kit use:** the last 5×7 (A) and a second 3×7 (B; C is the first).
- **The routing check** now also fails any pad or wire that is off its board's columns.

**Revision 2026-10-26 · no wire on a pin: it lands on a free hole, bridged to the pin.** Soldering a
wire onto a pin whose tail already fills the hole is hard (Hedi). On A and B every wire end now lands
on a free hole orthogonally beside its pin, one wire per hole, and a solder bridge joins that hole to
the pin. Board C is built and stays as it is.

- **Rules the routing check enforces:** a bridge holds pins of one net only; none of its free holes
  has another net's pin beside it; a pin with two wires gets two free holes, or a bridge over two
  holes. That is why I2C-B's SDA bridge runs down its column (k20-k18), and SCL and CN10-9's GND fork
  at the socket over two holes: every I2C header pin has only the hole behind it, because the plug
  lies on the row in front and its neighbours are pins.
- **Short same-net runs are bridges, not wires:** C2 + to SERVO + (n20-n23) and R4 to SERVO SIG
  (k23-m23).
- **Two pins move to CN7's outer row, where column k gives them a free hole:** B's ground to the
  Nucleo now uses **CN7-19** (was CN7-22), and the servo PWM uses **PA15 on CN7-17** (was PA0 on
  CN7-28). PA15 has TIM2_CH1 on AF1 (DS14539 Rev 3), the same timer channel PA0 had, so only the pin
  changes in firmware. After reset PA15 is JTDI with its pull-up on, so the servo line idles high
  through R4 until software takes it; the bootloader should drive it low early.
- **Two exceptions stay, in B's column i:** E5V (CN7-6) and 3V3 (CN7-16) take the wire straight on
  the pin. Neither exists on the outer row: E5V is the only 5 V input (UM3121 Table 8), and the
  other 3V3 is Arduino CN6-4, on top, where a plug would have to fit in about 7 mm under plate 3.
  Shifting B one column inboard (h-q) would give them a free hole, but its outboard corners would
  then fall 2.38 mm from the tray's printed holes, so every new hole would run into an old one.
  Hedi kept i-r and the printed tray as it is.
- The drawing shows the bridges in silver on the solder side and rings the two exceptions.

**Revision 2026-10-27 · the servo PWM on PC2, R4 turned round.** PA15 is tied to the ST-LINK's JTDI on
the Nucleo, and the Nucleo is not modified (HW-22), so the servo PWM moves to **PC2 on CN7-35**, B·I2,
on CN7's outer row. Its only free neighbour, B·H2, is where R4's lead was, so **R4 is turned round**: its
MCU end now sits in B·H2, bridged straight to PC2 (two pins, no wire), and its servo end stays in B·H6.
One wire runs from B·G6 (bridged to R4's B·H6) to B·F1, bridged to SERVO SIG at B·F2. CN7-17 is now
free, and so is B·H11, the hole that served it. Routing check passes.

**Revision 2026-10-27 · a header for the LED stick at B's rear.** The optional WS2812B stick (BOM 1.3,
HW-22) sits on top of plate 3, just behind the FRDM, facing the rear; how it stands is decided when plate 3
is assembled. On the carrier it takes a **straight 1×3 male header on top of B at B·F22, E22, D22**
(DIN, 5V, GND), behind the CN7 sockets and outboard of the Nucleo's edge, so nothing is above the plug.
Data comes from **PC12 on CN7-3** (B·I18, bridged to the free hole B·H18), 5 V from a second free hole on
5V IN + (B·B13), GND from a fourth hole on 5V IN − (B·A11); each header pin is bridged to a free hole
beside it, as everywhere on B. No level shifter is fitted (Hedi). The 3-wire lead to plate 3 is made when
the stick is mounted. Routing check passes.

**Revision 2026-11-01 · A under CN7, B under CN10: the parts change boards (HW-24).** The drawing showed
the Nucleo mirrored across the vehicle. Seen from above with CN1 at the rear, CN7 is over A and CN10
over B (Hedi's photo of the Nucleo on the boards as soldered, sockets at A·B11-T12 and B·I1-J19, as
drawn). The sockets, the boards, their corner holes and the tray stay; the parts follow the pins, with
no GPIO change (HW-24):

- **A carries power, the servo and the LED stick, all tall parts on its outboard strip (a-e):** 5V IN
  at A·P17 / N17 and 6V IN at A·K17 / I17, entry outboard; C2 at A·D16 (+) / F16 (−); SERVO, straight,
  across the front at A·B15 (SIG) / B16 / B17 (GND outboard); the LED header, straight, across the rear
  at A·V15 (DIN) / V16 / V17. R4 lies flat in column f under the Nucleo's edge, its MCU end A·C13
  bridged straight to PC2 (CN7-35, A·C12), its servo end A·G13. E5V, 3V3, PC12, PC2 and GND (CN7-19)
  each land on a free hole beside the pin; A has no wire straight on a pin.
- **B carries CAN and I2C:** the face-down module in columns l-o, its 1×4 at B·G13-D13 (CTX, CRX, GND,
  3V3) and its CANH / CANL at B·F19 / E19 (six holes behind, where the 2-pin header landed; it was drawn at
  F20 / E20, seven behind), pointing to the rear, 0.5 mm outboard of the Nucleo's edge;
  the CAN terminal in the outer column at B·A13 (H), A11 (L), A9 (GND), entry outboard, under plate
  3's left slot; I2C-B (B·G7-E7: GND, SDA, SCL) and I2C-A (B·D7-A7: 3V3, SDA, SCL, GND), 90°,
  across the front, pointing forward. The headers sit on hole row 18, so the plugs stop 1 mm short of
  B's front outboard screw head. I2C-B is a 1×3: a fourth pin for the motor module's unwired 5V, in
  column k, does not clear the CN10 socket (Hedi, 2026-11-01). PB6 and PB7 are the board's only wires straight on a pin (B's first column).
- **One wire crosses: 3V3**, A·M10 to B·D12, behind the sockets (A row 2.5 = B row 3.5).
- **Routing check passes:** 29 wires (9 in 18 AWG), 35 solder bridges, 2 wires on a pin. The check
  now takes the board of the 5V IN terminal from the data instead of assuming B.
- **The Nucleo model is mirrored** in `stm32-carrier.py` (`ny()`): CN1 is nearer CN10, CN12 on A's
  side, CN11 on B's, CN5 / CN9 beside CN10 and CN6 / CN8 beside CN7. The 3D model takes it from there;
  the animations are not re-rendered.

---

## MEC-16 · Plate 2's lower face is the harness board - plate 1 carries only the battery and the driver

**Decision (2026-09-28).** Every clip, fuse, splice and the INA226 is stuck to the **lower face of
plate 2** with 3M double-sided foam tape, and the harness is wired there with plate 2 upside down on
the bench. The **lower fascia panel with SW1 and SW2 rides with plate 2** during the build, so the
switches are wired there too. Plate 1's floor keeps only the battery and the motor driver. Plate 2
and the panel go down onto plate 1 together, and **only two plugs cross between the decks** - the
SM-2P and the driver's VM - both plugged from the vehicle's right side once it is closed. The
harness closes like a sandwich.

Positions, x from the front of plate 1 and y from its right edge, as modelled in
[`../mechanical/scripts/plate1.py`](../mechanical/scripts/plate1.py) and checked there against Hiwonder's CAD:

| Part | Where | On |
|---|---|---|
| **Battery** | x 85-162, y 30-93, lengthwise right behind the tie rod | plate 1, felt pad, felt straps and zip ties - fixed 2026-09-28 |
| **Motor driver** | x 168-210, y 22.6-80.6 | plate 1, as mounted 21 Sep |
| **(+) bus**, 221-415, 2 of 5 ports (INA226, S8) | x 88-107, y 40-70, entry face towards the opening | plate 2, levers down |
| **(−) bus**, 221-415, 4 of 5 ports (battery, S4, S5, S7) | x 134-153, y 40-70, entry face towards the opening | plate 2, levers down |
| **Main fuse** 7.5 A | x 96-146, y 2-29: base 34 x 12 (x 104-138), cap 26 x 15 (x 108-134) toward the right | plate 2 |
| **Motor fuse** 5 A | x 152-202, y 2-29, base x 160-194, cap x 164-190 toward the right | plate 2 |
| **UBEC fuse** 5 A | x 157-207 (moved 5 mm rear, clear of S5), y 91-118, cap toward the left | plate 2 |
| **INA226** | x 108-134, y 78-100, upside down, terminals facing the opening | plate 2 |
| **SW1 split**, DOMAXWILL 3-port | x 178-197, y 51-69, over the driver | plate 2 |
| **S8** (switch feed), 3-port | x 157-176, y 51-69, ports on its front face | plate 2 |
| **S9** (SW1 out + its LED +), 3-port | x 178-197, y 32-51, beside the split | plate 2 |
| **UBEC** | x 100-135, y 100-112 | plate 2 |
| **S1** (SM-2P + to main fuse) | x 83-96, y 21-40 | plate 2 |
| **S2 / S4** (driver VM + and −) | x 157-176, y 35-48, stacked | plate 2 |
| **S3 / S5** (UBEC + and −) | x 139-157; **S5 is a 5-port clip** (y 87-117, taped to the plate) with the 2-port S3 (y 104-117) hanging under it | plate 2 |
| **S6 / S7** (Bauer + and −) | beside the Bauer; **S6 is a 3-port clip** (y 96-114) | plate 2, top face |

The two buses face each other across **plate 2's 22.7 × 35.4 opening** (x 110-133). Every wire that
has to reach plate 2's top face - the UBEC's 6 V pair to carrier board A, the Bauer's feed and
return - goes up through it, between the buses. The rearward runs lie flat on plate 2 in one
**trunk** and cross over the motors, where there is 9 mm under plate 2 for wires but not for parts.

**Why.**

- **The clips and fuses were never on the drawing.** MEC-12 placed bare WAGO bodies and no fuse
  holders. The holders are about 50 long and 28 across in plan, 18 deep (a 34 x 12 base with a narrower 26 x 15 cap on a strap, as the seller's photo shows) with 12-13 cm leads each side, and every clip needs
  strip length and a bend in front of its face.
- **The battery fixed the floor.** Hiwonder's CAD puts the steering linkage at x 47-85.5 - servo
  bracket up to 38.5 mm high, the tie rod at 15-19 mm - so a 21 mm pack cannot sit forward of
  x 85.5. The drawing's x 55-132 went through the tie rod. On the vehicle the pack went in right
  behind it, which fills the old bus bay up to the plate cutout, and the floor has no room left for
  a clip with its wires.
- **Plate 2's lower face is the one large free surface.** Forward of the motors the tallest thing
  on the floor is the driver at about 16 mm, so 34 mm is free under plate 2. Over the motors, which
  Hiwonder's CAD puts at 40.8 mm, there is 9 mm: enough for wires lying flat, not for a part. The
  first drafts of this entry assumed 16 mm there and hung the split and both SW1 fuses over them;
  the 3D model showed the collision.
- **A harness built flat on one board is built at a bench, not inside a 50 mm gap.** Every joint
  is made with plate 2 upside down and in the open, and checked before it closes.
- **Only two wires cross, and both end in a plug that already exists.** The pack lead's SM-2P
  and the driver's VM connector are both at the vehicle's right side, below the harness board, so
  they are plugged with the sandwich closed. The SM-2P last, because it is the disconnect.
- **The switches ride with plate 2 because the lower panel already clamps to it** (MEC-07). Wired
  on the bench, their leads never cross the decks. The first version of this entry had them as
  drops with 6 cm spare, plugged with plate 2 held above; the 3D states showed that slack had
  nowhere to go - over the motors there is 9 mm.
- **Modelled open, lowering and closed.** `plate1.py` gives each crossing wire a fixed length and
  recomputes its curve for each position of plate 2.
- **Foam tape instead of zip ties.** The parts are small and light, the tape takes up the plate's
  holes and slots, and it holds a part wherever it has to go rather than where a hole happens to be.
- **The UBEC left plate 1** because its output never stays there: HW-19 routes the servo's 6 V
  through carrier board A, so it climbs to plate 2 whatever happens.
- **One (−) bus is enough.** Since 2026-10-06 the two switch LED returns join the UBEC's return in S5, so the star has four returns: battery, driver, UBEC (with both LEDs) and Bauer. One port is spare.

**Rejected.**

- **Everything on plate 1's floor.** Four fuse holders alone need about 6000 mm²; once the pack was
  in, the free floor was two strips about 25 mm wide beside it.
- **Parts over the motors.** 9 mm under plate 2.
- **Fuse lids facing down.** A holder is 30 mm tall that way, and changing a fuse needs about 20 mm
  more below the lid.
- **Zip ties through plate 2's holes.** They fix a part only where a hole is, and two of the
  carrier's screw heads (F3, F4) sit under plate 2 where the ties would go.

**Building it.**

1. **Plate 2 off, upside down on the bench**, on two blocks so the carrier and the Bauer on its top
   face hang free. Clean the face with isopropyl alcohol where each part goes.
2. **Hold the lower fascia panel with SW1 and SW2 to plate 2** at its top pads - a temporary
   M3 × 8 into each captive nut, replaced by the M3 × 12 when the upper panel goes on (MEC-07).
3. **Tape the parts** in the positions above: buses levers-down, fuse holders flat with the lids to
   the sides, the INA226 upside down, the splices beside their runs. Fuses out.
4. **Wire everything**, switches included. Two tails stay loose: the SM-2P male (from S1 and the
   (−) bus) and the driver's VM plug (from S2 and S4), about 3 and 7 cm.
5. **Lower plate 2 and the panel together** onto the standoffs, the panel's bottom pads onto
   plate 1, and fit the screws (panel bottom from under the vehicle). Check nothing is pinched
   against the pack.
6. **From the right side**, plug the driver's VM, fuses in, then the SM-2P last - the battery is
   the disconnect (HW-08).
7. The driver's I²C lead goes up to the carrier on plate 2's top face; route it with the 6 V pair
   through plate 2's opening.

**Consequences.**

- **The (−) bus has no spare port.** A sixth return means bridging one of the three spare 221-415s
  back in, which is the HW-16 arrangement.
- **3M double-sided foam tape is a new BOM line**, and the hook-and-loop straps in BOM 3.24 were not
  used: the pack is held by felt strips and zip ties.
- **The fuse lids face the sides of the lower gap** and are changed from there without lifting
  plate 2. The main fuse's front end reaches past the plate edge by about 4 mm at the waist.
- **18 AWG needed is about 1.5 m red and 1.1 m black** against 2.5 m each bought. The clips come from stock: 2 × 221-415 (3 spare),
  1 × 3-port and 7 × 2-port from the DOMAXWILL kit.
- **The chassis layout drawing shows plate 1's floor only**; the harness board is this table and
  the 3D model, where each part and each run is its own coloured group.

**To confirm.**

- The clip outlines and which face the wires enter: the model uses 30 × 18.6 × 8.5 for the 221-415
  and 18.6 × 18.4 for the 3-port.
- The fuse holder body with calipers - the base / cap shape is the seller's photo (2026-10-07), the sizes are scaled off it.
  *Decided 2026-10-07: no calipers, so the estimates stand (fuse holders, the kit boards' corner holes at 2.5 mm in, the switch harness). They are checked by dry-fit instead: tape the holders to plate 2 before wiring, lay boards A and B on a 1:1 printout, measure the harness length with a ruler and read its gauge off the ferrule that fits.*
- The pack's height with its felt (modelled 21 + 3) and the driver's top height.
- **The switch wiring (decided 2026-10-06).** Each switch has four wires: **two green** (the contact, no polarity), **red** (LED +) and **black** (LED −); the LED has its own resistor and runs on 12 V (tested). To light the LED only when the switch is on, **LED + is joined to the switched output, never to the (+) bus**. Every join ends in a clip, so no wire meets another without one:
  - **S8** (3-port, toward the rear) takes **(+) bus port 2** and both switches' first green wires. One bus port feeds both switches, so the switch harness reaches (run 05, 06a, 06b). (+) bus port 3 is spare.
  - **SW1's output** (second green) and **its red LED +** meet in **S9** (3-port), and one wire goes from S9 to the SW1 split (runs 07a-07c).
  - **SW2's output** and **its red LED +** meet in **S6**, which becomes a **3-port** clip with the Bauer's red lead (runs 15a, 15c, 15b). Two wires pass up the left slot instead of one: 2.4 + 1.6 mm in an opening about 5 x 10 mm, so check it on the real tray.
  - **Both black LED − wires** go into **S5**, which becomes a **5-port** clip: UBEC (−), the run to the (−) bus (port 4), and the two LED returns (runs 13a, 13b). The (−) bus is then **4 of 5** ports, one spare.
  - S9's pigtail enters the split's second port. Nothing is crimped on the switch tabs: the supplied socket harness is used, so BOM 3.17 (flag receptacles) is not needed.
  [`../tools/check-harness-clearance.py`](../tools/check-harness-clearance.py) fails if a part overlaps another, a wire runs through a part, two wires share space, or wires meet with no clip.
  Clips used: **3-port x 4** (split, S8, S9, S6), **5-port x 1** (S5), **2-port x 5** (S1, S2, S3, S4, S7). The positions of S8, S9 and S5 are stand-ins in the model; what must hold is the height over the motors (9 mm: no clip there, 8.5 mm + 1 mm of tape).
- The screw heads under plate 2 - carrier F1-F4 and board C's F5, F6 - against the taped parts. *Done for the tray's own six fixings in MEC-17 (2026-10-05); the direct-fixing scheme it replaces would have clashed.*
  F3 lands at the motor fuse's lid edge.
- **Checked on the real parts (2026-10-11):** battery and driver are about 20 mm tall; the clips and fuse holders went in as designed and the wiring is clean. The layout stands unchanged.
- The switch harness: wire length (the model assumes the leads reach S8 / S9 or are extended) and gauge of the contact wires, which carry up to about 6 A for SW1.
- That the driver's VM socket can be reached from the right side under the motor fuse - about
  16 mm of height between the floor parts and the holder. If not, the VM tail needs about 12 cm to
  be plugged with plate 2 held above, and that slack has to be stowed.
- The Bauer's own lead length, which sets S6 and S7. S6 is a 3-port clip since 2026-10-06 (y 96-114): check it fits on the tray before the splices are taped.
- The tires' outside diameter. The model uses about 68 mm, scaled off a photo - the CAD has the
  rims only. At that size a rear tire's front edge is at about x 191 at fuse height, and the
  motor and UBEC fuse lids end at x 190, so the lids are reached from the side just in front of
  the rear tires.

---

## MEC-17 · One tray carries boards A, B and C and bolts to plate 2

**Status (2026-10-06): fit-reviewed for a single print; see "Fit review before ordering". Ordered 2026-10-06 (BOM 3.28), nothing printed yet.** Proposed 2026-10-05. A brainstorm with Hedi, modelled so it can be
judged. Source: [`../mechanical/cad/carrier-tray.scad`](../mechanical/cad/carrier-tray.scad).
**Recommendation: print it** (PETG, 4 mm), for the reasons in "Two ways to make it" below.

The layout drawing ([`chassis-layout.svg`](../hardware/renders/chassis-layout.svg)) shows the tray, the Bauer, the splices and the six
fixings on plate 2's top face, and the six screw heads among the taped parts on its lower face.

**Placed in two steps (2026-10-05).** First the carrier on the tray, then the tray on plate 2.

1. **Boards on the tray, in the tray's own frame** (u from the front, v from the right edge, origin at
   the tray's front-right corner): A at u 108.50-178.50, v 0-50; B at u 111.04-181.04, v 55.88-105.88;
   C at u 77.00-107.00, v 20.09-90.09; the Bauer's end of the tray ahead of C. The tray is 183 x 110 mm with its corner pads.
   The Discovery fixes A against B (5.88 mm apart, A one pitch ahead); C's 1.5 mm to A is a choice,
   since the tray no longer forces it.
2. **Tray on plate 2** by one offset, `PLACE = (8.50, 5.11)` in the plate-2 layout frame. That puts
   the boards exactly where MEC-15 has them: A at x 117.0-187.0, B at x 119.54-189.54, C at
   x 85.5-115.5.

**The tray also carries the Bauer 50 W (2026-10-05).** Its front end reaches x 8.5, which is as far as
plate 2's narrowing front allows (the front is tapered to stay 1.5 mm inside the plate edge). The Bauer
is screwed to the tray **through its own two mounting holes**, so it needs no cable ties and no plate hole
of its own. From the seller's drawing and Hedi's photo (2026-10-05): 64 x 57 x 22 mm, corners chamfered
about 8 x 6.5, two 6.8 mm holes **inside the outline**, 5 mm in from each end (54 mm apart) and 26 mm
from the edge the leads leave by, a raised central plateau with three ridges, two fins each side of it
(round bosses on the outer ones), and the four leads (yellow, black, black, red) leaving through a
grommet in the middle of that long edge. (This record had taken the holes for ears outside the body;
the BOM's "54 mm matches no chassis rectangle" no longer matters.)

- **Where it sits:** x 11-75, y 28.5-93 (the body with its side walls, 2026-10-06; 32-89 was the base alone), 9 mm ahead of where `plate1.py` parks it, with its **leads wall on
  the vehicle's left** (y 93), the side board C's 5 V terminals face. **Cable room:** a lane of tray beside
  that wall (3 mm clear before the S6 splice, 4 mm on the right before S7), 10.5 mm behind the Bauer before
  board C, and a mirror lane on the right. The two output leads (yellow, black) run along the left lane and the
  rear lane to C's IN terminal. Nothing closes the lanes (the rim is gone). The S6 / S7
  splices and their wiring are under "Where the splices go" below.
- **Holding it:** two M3 x 8 screws from above through its holes into M3 nuts held in hex pockets in the
  tray (E1 at (16, 63), E2 at (70, 63)) (the rim of four corner legs that located it is removed, see "Fit review before ordering", item 6).
- **Held to the plate** by T1 (24.82, 60.24) and T2 (52.82, 60.24), two of the plate's M3 holes under the Bauer.
- **Cable passages:** the plate's two slots beside the Bauer (x 56-80, y 27-37 and 83-93) are open in the
  tray too, but the Bauer's body (to x 75) covers all except their last 5 mm (x 75-80); the wires to the splices come up there. The window
  by C is left for the 6 V pair and the driver's I2C lead.

**The tray has the plate's holes.** Every plate-2 hole wholly under the tray is copied at the plate's
own diameter, plus the plate's slots, so nothing open on the plate is blocked. Surveyed from the
chassis layout. Not copied, with the reason in the .scad: the holes outside the tray or too near its
edge, those that would run into a nut pocket (the two 9 mm holes among them), and the two long side
slots (x 109-158) that run off the tray's edge. The large slot at x 161-176 cuts the A-B bridge; the
tray stays one piece through the front part and the 20-25 mm bands beside the slot.

**Fixings (T1-T6).** Six of those holes take the tray down, M2.5 from below: T1 (24.82, 60.24) and T2 (52.82, 60.24) under
the Bauer, T3 (99.24, 81.76) under board C, T4 (120.06, 35.94) under A, T5 (148.18, 81.76) and T6 (148.18, 96.76) under B. They
are named T so they do not collide with MEC-15's F1-F6, the direct-fixing scheme this replaces. Each has a hex pocket on the top
that captures the nut. This matters: the nut sits under a board or the Bauer, so without a captive pocket the tray could not
be unscrewed without taking them off first. A hand-cut sheet cannot have the pocket. The board holes are separate (four per
board, M2.5, counterbored from below) and no longer have to match anything on the plate.

**Assembly order (proposed), animated in
[`../mechanical/scripts/animate-carrier-tray.py`](../mechanical/scripts/animate-carrier-tray.py).** The tray goes on after
plate 2's harness is built and plate 2 is the right way up, because its screws come from below and
its boards would be in the way while plate 2 lies upside down (MEC-16).

1. At the bench, with the tray on three posts clear of every screw: a nut pressed into each of the eight
   pockets (six M2.5, two M3).
2. The Bauer onto the tray, two M3 screws with 9 mm washers through its holes. Boards C, then A and B, lowered onto the
   tray, their nylon standoffs on the tray's board holes.
3. Twelve M2.5 screws from below into the standoffs.
4. The S6 and S7 splices into their outlines, either side of the Bauer.
5. The unit is lifted across onto plate 2 (raised on blocks, as in MEC-16's lowering), its holes over
   the plate's, the Bauer's 12 V wires pulled up the two slots to the splices.
6. T1 to T6: an M2.5 screw from below into each nut pocket, a washer in the M3 holes.
7. Plate 2 comes off the blocks and lowers onto the chassis standoffs; the Discovery plugs on last.

This differs from the MEC-16 animation, which has the carrier on plate 2 from the start. The tray lifts
out again as one unit, six screws from below. The video builds the boards from `stm32-carrier.py`, so
they are the boards as built; the harness parts under plate 2 and the Discovery are stand-ins.

**Screw heads under plate 2, checked against `plate1.py` (2026-10-05).** This was MEC-16's open check, and it decided which holes
the tray uses. Against the taped parts (head r 2.3, washer r 3.0, distance from the hole centre to the part's edge), the
direct-fixing holes clash: F1 (148.18, 23.76) is 2.2 mm from the main fuse holder, F2 (148.18, 72.24) 2.2 mm from the (-) bus, F5
(99.24, 38.76) only 1.2 mm from the (+) bus. The tray does not need those holes, because it can use any plate hole under
it, so it takes six that are clear: T3 8.8 mm from the nearest part (the INA226), T5 7.3 (the UBEC fuse), T4 3.9 (the main
fuse), T6 3.8 (the UBEC fuse, 0.8 mm clear of a washer), and T1, T2 under the Bauer, where nothing is taped. That
rejects the alternative of moving the buses. The wire runs still have to be routed round the heads.

**The window** is now the plate's real opening (x 110.3-133.0, y 42.5-77.9, measured on the layout,
where this record had assumed y 40.4-75.8) cut off at x 115.0, so it stays 1.7 mm clear of A's
front-inboard corner counterbore. It is 4.7 mm wide.

**The idea.** Instead of six separate fixings (F1-F6) drilled through the boards and screwed into
plate 2, the three boards sit on one tray, using their own M2.5 corner holes and the nylon
standoffs already fitted. Only the tray is screwed to plate 2.

**Why it is attractive.**

- **Nothing drilled into the built boards.** The kit boards' four corner holes are all free on A
  and B (fitted with standoffs, 2026-10-03), and the tray follows the boards as built, A's one-pitch
  offset included.
- **Six screws through plate 2, none off-grid and none new.** The tray uses six existing plate holes
  chosen to be clear of the taped parts (see "Fixings"), so MEC-15's F1-F6, three of which clash with a fuse holder or a bus
  under plate 2, are all dropped.
- **The electronics lift out as one unit** for bench work, and the tray can stand on its own.
- **It carries the S6 / S7 splices too,** in lanes either side of the Bauer (see "Where the splices go"), where
  their levers can open and the plate's two slots bring up their wires.

**Two ways to make it, one file.**

| | Best | Cheap |
|---|---|---|
| How | printed PETG, 4 mm, ~25 € (Craftcloud quote) | 3 or 4 mm plastic sheet (PVC foam, ABS or polycarbonate; not acrylic, MEC-02), cut and drilled by hand |
| File | `carrier-tray.stl` | a 1:1 A4 template from [`carrier-tray-hand.py`](../mechanical/scripts/carrier-tray-hand.py), printed and taped to the sheet; a 100 mm bar checks the print scale. See "The hand-made tray" below |
| Board screws | from below into the standoffs, in printed counterbores, so the tray sits flat | from below; the heads lift the sheet ~1.8 mm, accepted |
| Board height | 4 + 8 mm standoffs = 12 mm | 3 + 1.8 + 8 = 12.8 mm |

**The hand-made tray (2026-10-05).** Printing was quoted at about 25 €, and the cheapest result under Craftcloud's CNC tab was 47.91 € plus
14.07 € shipping for laser-cut acrylic (which cannot make the pockets and is excluded by MEC-02 anyway; no milling price was
looked at). So the sheet is the way to try next, and the printed tray's features are cut to what can be done with a saw and a drill.
[`carrier-tray-hand.py`](../mechanical/scripts/carrier-tray-hand.py) writes a 1:1 A4 template (SVG; print at 100 %, the 100 mm bar
must measure 100 mm; the PDF is stored as [`carrier-tray-hand-template.pdf`](../mechanical/cad/carrier-tray-hand-template.pdf)) with the cut line, true-size holes, the boards and the Bauer in dashed outline, and the hole table.

- **Outline:** twelve straight cuts, all right angles, 182.5 x 109.4 mm, the closest point 1.1 mm inside plate 2. It needs a sheet
  of at least 189 x 116 mm. The printed tray's tapered front, curved corner pads, splice wings and rim are gone.
- **21 holes, not about 70:** 12 board screws (3.4 mm), four fixings to plate 2 (T1, T3, T4, T5; T2 and T6 are left out, four spread
  points are enough for a part that only has to stay down), the Bauer's two M3, and three 8 mm cable windows (W1 by board C, W2 under A, W3 under B) spread over plate 2's opening (x 110.3-133.0, y 42.5-77.9), so the 6 V pair and the I2C lead can drop through next to where they end. Plate 2's
  own copied holes and slots are not needed.
- **Nuts:** no pockets. Tap the fixing holes M2.5 (2.1 mm drill) and the Bauer's M3 (2.5 mm) in the sheet, or open them to
  2.8 / 3.2 mm and glue a nut on the top. Tapping needs a material that takes a thread: nylon (PA6), acetal, ABS or polycarbonate,
  not PVC foam.
- **Board screws:** 3.4 mm holes countersunk 90 degrees from below for flat-head M2.5 x 8, so the tray lies flat on plate 2. If you
  only have pan-head screws, drill a 6 mm x 2 mm counterbore instead (twelve of them, with a depth stop).
- **Splices:** S6 and S7 go back on plate 2's top face at the same x, y (x 42-60.6, y 96-109 and 11.5-24.5), taped, beside the tray.
  They were on the tray only because the tray had to carry them; the tray's edges at y 31 and y 89 leave the outer 4 mm of each of the plate's two slots (x 56-80) open,
  so the Bauer's 12 V wires still come straight up beside them. Whether 4 mm is wide enough for both wires is checked at fitting.
- **Mark from the boards if you can:** stand the boards, with their standoffs fitted, in their dashed outlines on the sheet and
  mark the twelve holes through the standoffs. That makes the unmeasured corner inset irrelevant.
- **Heights:** a 4 mm sheet leaves every height unchanged (boards 12 mm above plate 2). The 3 mm ABS sheet bought on 2026-10-06 puts them at 11 mm, which only adds clearance to the FRDM above; at 3 mm the 90 degree countersink leaves about 0.6 mm of sheet under the screw head, so cut it shallow.

**Heights.** All three boards stay on the 8 mm M2.5 standoffs already fitted (Hedi, 2026-10-05: the same on
A, B and C, length not gauged; the corner holes were widened by hand with scissors to take them), so
they stand 12 mm above plate 2, 2 mm higher than with direct fixing on 10 mm standoffs. The Discovery is 2 mm closer
to the FRDM above it: MEC-15 put its top at about z 111 against the FRDM's screw heads at z 119.4 under plate 3,
which leaves about 6 mm.

**Where the splices go (decided 2026-10-05).** S6 and S7 (the Bauer's 12 V + and -) are 8.5 mm tall (`plate1.py`)
and C's underside is only 8 mm above the tray, before the solder joints and wires that hang 1-3 mm lower, and a
lever splice needs room above it to open. So they are not under C. S6 (+) sits at x 42-60.6, y 96-109, left of the
Bauer, beside the plate's left slot (x 56-80, y 83-93); S7 (-) is its mirror at y 11.5-24.5, right of the Bauer, beside
the right slot. Plate 2 narrows behind x 62, so two splices do not fit in one lane; it is symmetric about y 60.25,
which is why the second lane is the mirror of the first. The tray has a wing for each (1.5 mm inside the plate edge).

- **Wiring:** SW2's wire comes up the left slot into S6, the (-) bus wire up the right slot into S7. The Bauer's red
  lead goes into S6; its black input lead runs round the Bauer's rear, through the 10.5 mm lane before C, to S7
  (about 135 mm of the lead's roughly 150 mm, measured by Hedi on 2026-10-05, so about 15 mm to spare). The window no longer carries the
  Bauer feed.
- **Harness changes** (`plate1.py`, the cut table in `chassis-layout.svg`): run 15 (SW2 to S6) is 32 cm, was 31;
  run 16 (S7 to the (-) bus) is 22 cm, was 13. Both go under plate 2 along y 73-88 and y 75, clear of the buses
  and the INA226.
- **Rejected:** 12 mm standoffs under C only (a part that is not in the BOM, splices buried under a board with
  about 1.7 mm of margin and no room for the levers); recessing them into the tray (4 mm is too thin).

**Fit review before ordering (2026-10-06).** One print, so every open point was checked against the real plate data
(`chassis-layout.py`, the survey) and `plate1.py`, with shapely on the model's own outline. Findings, worst first:

1. **The tray sat on two chassis standoffs (fixed).** The four chassis standoffs (6 mm hex, `STANDOFFS`) stand on plate 2's top face to carry plate 3.
   Two of them, (27.35, 22.17) and (27.35, 98.36), are under the Bauer end's two lanes, and the tray was solid over both (22.8 mm2 of overlap each,
   in either hex orientation): it would have rested on two hexes and not on the plate, and the model had copied the plate's 4.29 mm
   hole there as if it were a free hole. Now a ⌀9.0 notch round each. The hand-cut sheet template starts at y 31 and never reached them.
2. **The six fixings had no tolerance (fixed).** Tray hole 2.8 against an M2.5 screw left +-0.15 mm, and T4 sits on a 2.71 plate hole (+-0.10), so T4
   tolerated +-0.26 mm in total, less than a printed part's error over 120 mm (0.3 % is 0.37 mm). Now the tray holes are 3.4, so the captive nut
   locates the screw, the nut pockets are 5.4 across flats (nut 5.0; a printed hex comes out 0.1-0.2 small), and T4's hole and pocket are slots 1.0 mm long
   along the tray, so its nut can sit 0.5 mm either way. The other five have +-0.34 from their 3.18 plate holes plus the nut's float.
3. **The board holes had little margin (fixed).** The inset is an estimate (2.5 +-0.5), the standoffs were fitted into holes widened with scissors, and 3.4 mm held +-0.45.
   Now 4.0 mm, with a 6.4 mm counterbore 2.4 mm deep (was 6.0 and 2.0) so a screw head up to 2.2 mm tall still leaves the tray flat on plate 2.
4. **M3 nut pockets** for the Bauer widened from 5.7 to 5.9 across flats (nut 5.5).
5. **Checked and fine:** the tray is one piece (one 2D region, no feature under 1.2 mm), 0.60 mm inside plate 2's edge at its closest (board A's front
   corner pad, 6.8 mm of edge within 1 mm; the survey and the print each add about 0.3 mm, so it may touch the edge and cannot hang over by more than a
   tenth), every fixing sits on a plate hole within 0.01 mm, the nut pockets are at least 1.9 mm from any other opening, and the counterbores 4.5 mm
   from any pocket. The screw heads under plate 2: T4 3.9 mm, T6 3.8, T3 8.8, T5 10.9 from the nearest taped part. T4 is the only clear hole
   under board A, so it stays.
6. **The Bauer, measured from Hedi's photo on 5 mm paper (2026-10-06; no callipers).** Scale from the grid (17.2 px/mm), corrected for the camera's
   height (about 36 cm, so +1.7 % at the tab and +6 % at the fin tops). Holes **54 mm apart** (read 53.8, +-1) and about 5 mm from each tab end: the
   critical dimension is confirmed. Bore about 6.9 mm. But the body is **about 64 wide across the holes' axis, not 57**: the side walls of the fin banks stand
   3.5-4 mm outside the base, so the holes are about **30 mm from the leads wall and 34 from the other** (the drawing's 26 + 31 = 57 is the base). The fin
   tips also reach about 5 mm past the tab at one end, the front once the leads are on the vehicle's left. Consequences, all handled in the file or below:
   - the **rim would have collided** (its legs stood 1.2 mm off a 57 mm body, inside the real walls): removed, the two screws locate the Bauer alone;
   - the body covers y 28.5-93 (was 32-89): **3.0 mm from S6, 4.0 from S7, 1.9 and 2.9 mm from the two chassis standoffs, 10.5 from board C**, all clear;
   - it **covers most of the plate's two tie slots**, which run x 56-80: only the last 5 mm (x 75-80) is open for the S6 and S7 wires, enough for one
     18 AWG wire each (2.4 mm), no more. Route them there;
   - the Bauer's hole is 6.8 mm, wider than an M3 head (5.5), so each screw needs a **washer of 8 mm or more (M3 DIN 9021, 9 mm)** on top, not in the BOM. M3 x 8 suits a
     tab 3-6 mm thick; try the stack on the real part first.
7. **Nuts.** The M2.5 nut was checked on 5 mm paper on 2026-10-06: **5.0 mm across flats**, matching the 5.4 mm pocket. The M3 nuts and screws are not bought yet:
   buy **plain hex nuts** (ISO 4032 or DIN 934, 5.5 mm across flats, 2.4 thick; **not nyloc**, 4 mm tall, which would not sit in the 2.6 mm pocket), M3 x 8 screws with a
   pan, cheese or socket head (not countersunk), and two DIN 9021 washers (9 mm).
8. **Still not verifiable from here:** the corner-hole inset (now absorbed, not known). A socket-cap M2.5 head is 2.5 mm tall, 0.1 mm more than the 2.4 mm counterbore:
   the tray would rest on the heads by 0.1 mm, harmless.
9. **How it is printed matters:** flat, PETG, 0.2 mm layers, 3 perimeters, 20 % infill, a brim against warping (a 183 x 110 x 4 mm slab curls a
   little at its corners). Order it as FDM and not as SLS or resin, whose small holes close up.

**To measure or decide before making it.**

- **The corner holes' inset** from the board edges is **estimated, not measured: 2.5 mm, give or take 0.5**. The basis is
  Hedi's photo of board C (2026-10-05): the 5.8 mm-across-corners standoff hexes sit almost flush with the board edges,
  so their centres are close to the edge, and the holes are separate from the 2.54 mm grid (its first hole is 3.6 mm from the
  long edge and 5.8 mm from the end). Hedi cannot measure them. So the tray is built to tolerate the error: board holes of
  4.0 mm for the M2.5 screws (0.75 mm of play each way, less about 0.1 a printed hole loses; changed from 3.4 on 2026-10-06) and a round pad of r 4.6
  mm round each corner so the 6.4 mm counterbore, even 0.5 mm off centre, leaves a 0.9 mm wall at the tray's edge. The pads stay inside plate 2 (0.6 mm to spare
  at board A's front corner). A hand-cut sheet should be drilled from the boards, not the template.
- **Board C's corner holes:** C is built (2026-10-05) with a standoff in each of its four corners, so the four board holes per
  board are right; their inset is the estimate above.
- **Board C's silkscreen is the other way round from A and B** (photo, 2026-10-05): numbers 1-24 along the long side, 1 at the USB-C end, letters A-J across. *Renamed the same day:* A1 is at the bottom left with components up and the USB-C socket on the left, so F5 is C·F4 and F6 is C·F21, in `stm32-carrier.py`, MEC-15, HW-19 and the BOM.
- **Whether a 4.7 mm window is wide enough** for the 6 V pair and the driver's I2C lead, and how the 6 V pair then gets from the window to A's 6V IN, about 60 mm away under the 8 mm gap.
- **Whether anything above plate 2 stands on (186.12, 9.71) and (186.12, 110.82).** The tray covers them: they are 2.5 mm from A's and B's rear corner holes.
- **Which side of the vehicle the Bauer's leads edge faces.** The photo fixes the leads and the holes to the same edge; putting it on the left is a routing choice.
- **The M3 nut's real depth and across-flats** (assumed 2.4 and 5.5 mm), before printing the Bauer's two pockets.
- **Print or sheet.** The model serves both.

**Update 2026-10-26 · board B is a 3×7 (MEC-15).** The printed tray stays as ordered.

- **B's two outboard corner holes** land on the tray's B outboard pair, 0.16 mm off, inside the 4.0 mm
  holes' play. The tray's B inboard pair is left empty, in the gap between A and B.
- **One hole is drilled by hand** for B's rear inboard corner, at plate 2 **(187.04, 83.65)**, clear of
  every copied plate hole. Mark it through B itself, set on its other three standoffs. It is only 2.5 mm from the tray's rear edge: the tray follows the board's
  outline there and has no corner pad, so a 6.4 mm counterbore would break out. Instead, **drill 2.1 mm
  and screw in an 8 mm male-female nylon standoff** from the M2.5 kit (3.31), its 6 mm stud cut to
  3.5 mm so that it cuts its own thread in the 4 mm PETG and does not reach plate 2. The board screws
  onto it from above like the others. *(The hand-made tray's straight rear edge is 4.5 mm away and
  takes the usual countersunk screw.)*
- **B's front inboard corner takes no screw.** On top, the CN7 socket ends 2 mm from it; below, the
  copied plate hole at (120.06, 84.53) is 2 mm away. Three screws and the Nucleo in CN7 hold B.
- **Eleven board fixings, not twelve.** On the printed tray that is ten screws from below and B's
  threaded standoff; the hand-made tray's template and its PDF carry B's three holes as countersunk
  screws. Window W3 now sits beside B, not under it.

---

## MEC-18 · One wide tray on plate 3 - a spare nose, the Pi 5, a plug gap, the FRDM, all turned across

**Status (2026-10-06): ordered 2026-10-06 (BOM 3.28), with the checks below accepted; nothing printed or dry-fitted yet.** Source: [`../mechanical/cad/compute-tray.scad`](../mechanical/cad/compute-tray.scad) -> `compute-tray.stl`;
the renders come from [`../mechanical/cad/compute-tray-preview.scad`](../mechanical/cad/compute-tray-preview.scad) (plate 3's data is exported from the layout drawing by
[`../mechanical/scripts/plate3-data.py`](../mechanical/scripts/plate3-data.py)). Ordered **together with the carrier tray (MEC-17) and the rear pad (MEC-19)** in one Craftcloud order: a print service charges less for one order with everything than for two.
PETG, 4 mm, flat, no supports, **236.6 x 108.0 x 4 mm** (needs a bed of 240 mm or more). It follows MEC-12 (the FRDM on plate 3).

**History of the layout (all 2026-10-06, all in git).** First the FRDM at MEC-11's place with the Pi in the nose; then a spare nose with the FRDM along the vehicle (rejected: its USB plugs need about 25 mm behind the board and the Pi pad
sat there). **This one:** Hedi asked for both boards turned across the vehicle and the tray spread over more of plate 3, then moved the FRDM 6 mm toward its 40-pin side to leave room for the debug cable.

**The FRDM's connectors** (NXP *FRDM-IMX91S Quick Start Guide*, figures 1 and 2; read off the photo at 10 px / mm, +-1 mm; u along the long edge, v along the short one, 40-pin header at u 0, CAN header and microSD at v 0):

| Edge | What | Faces, as placed |
|---|---|---|
| u 0 | 40-pin expansion header (nothing in the BOM uses it) | the vehicle's **right** |
| u max | USB-C DBG **J11**, USB-C, USB-A (overhanging the edge by about 1.8 mm) | the vehicle's **left**; the plugs hang over plate 3's left edge, 17 mm of plate beside them |
| v max | audio jack, USB-C power **J1**, RJ45 (overhanging by 2.5 mm) | the **nose**, toward the Pi: the plugs need about 35 mm, and plate 3's big slot (x 161-176, y 30-90) lets the cable climb |
| v 0 | 30-pin FPC, 2x5 CAN header **J7**, buttons; **microSD slot** on the underside, opening to this edge | the **rear**, where plate 3's cross-slot at x 260 is |

**The board is about 95 x 65 mm, not 105 x 65.** In the guide's photos the six mounting holes sit 49.0 mm apart, then about 40, on a 58 mm spacing, and the outline is 95 x 65 at that scale. The 105 is the *non-S* board's (UM12262 and its
design files; MEC-11 took its drill file from there, and its first four holes still match). Hedi measured **96 x 67** over the connectors, which is the PCB plus the RJ45 and USB-A that overhang it. The tray uses 95 x 65 and its
FRDM screw holes are loose (4.2 mm, counterbore 7.2 mm) so the +-1 mm in the photo does not matter.
**Confirmed 2026-10-06 against the -S's own design files** (board 95020 rev B, in `vendor/`): the Gerber outline is **95.0 x 65.0 mm**, the six mounting holes are plated ⌀3.175 at u 3.5 / 52.5 / 91.5 and v 3.5 / 61.5, exact, and every connector in the table above lands within 1 mm of where the photo put it (full table: `bom/parts/1.1-FRDM-IMX91S/NOTES.md`). The tray as ordered is right on all four screwed holes; the two far-edge standoffs it simply stands on sit at u 91.5, 0.5 mm further than the model's 91.0, which its pad covers with room to spare. The ordered `compute-tray.stl` does not change.

**The layout** (plate 3 frame, x from the nose):

- **Spare pad, x 14-93:** plate 3's own outline moved in 5 mm, plain plate, six fixings, two windows over plate 3's slots (x 56-80, y 27-37 and 83-93), a notch round each chassis standoff. Drill it. (The Sense HAT idea is parked; its 40-pin ribbon is not in the BOM.)
- **Pi pad, x 94-150:** the Pi 5 across the vehicle, **ports to the left**, GPIO header to the rear. Plate 3 is 84.5 mm wide at x 70-88, so the Pi (85 across) cannot go further forward. Four M2.5 standoffs, **8 or 10 mm, Hedi's choice**
  (recommended 8), each held by an M2.5 x 6 from below through a counterbore, the Pi screwed on top. Works the same if the standoffs turn out male-female (the bottom screw is then not needed).
- **Plug gap, x 150-184:** two ribs, 10.5 and 8.75 mm wide, at the plate's edges and nothing between them.
- **FRDM pad, x 184-249, y 6.75-101.75:** the board on its 6 mm metal standoffs, four screwed from the tray's underside (M2.5 x 6 in counterbores, the tray sits flat); the two on the far edge just stand on the tray.
  5.1 mm to the plate's right edge, 17 mm to its left.
- **Fixings to plate 3**, 14, all on plate 3's own holes: M3 at (17.82, 53.24 and 67.24), (196.88 and 245.88, 38.76 and 81.77); M2.5 at (49, 35.94 and 84.53), (86.94, 40.23 and 80.23), (120.06, 35.94 and 84.53), (143.47, 52.65 and 67.88).

**Wiring: only the BOM's parts (2026-10-06).** Three cables reach the FRDM. Figure: `renders/compute-tray-1-top-wiring.png` (untracked; regenerate from the preview file).

| Cable (BOM) | Route | Length needed | Verdict |
|---|---|---|---|
| **J1 power**, C-to-C 20 cm (5.1), from board C's USB-C socket (plate 2, HW-19) | socket plug -> up through plate 3's right-hand slot (x 109-158, y 10-15) -> along the right edge, over the right rib -> J1 on the nose edge | about 13 cm | **fits**, about 3 cm to spare. The big slot in the plug gap is the second way up |
| **J11 console**, USB-C extension 0.2 m (5.9), from the fascia's USB-C port | the port's body ends at x 225, y 41.3 (z 101) -> along the upper gap to the left edge (78 mm) -> up outside the plate edge (35 mm) -> J11's plug, 25 mm past the edge | about 14 cm | **fits**, the cable is 20 cm beyond the port's own 40 mm body. The slot at x 219.5 above the body's end is under the FRDM pad, which is why the route goes round the edge instead |
| **J7 CAN**, 2x5 mating lead (4.4, not yet bought) to the CAN terminal (4.1's end of the bus), twisted pair, BOM 4.3 says about 30 cm. *Updated 2026-10-27: since the NUCLEO-H533RE (MEC-15) the transceiver and its terminal are on **board A**, at A·F17 / D17 / B17, plate 2 x 125-135, opening to the vehicle's right edge; they were on board B* | the plug on J7 -> 10 mm over the rear edge -> down plate 3's cross-slot (x 260-265, clear: the fascia's wall is at x 267-270) -> on plate 2, diagonally over the rear pad to the right edge **behind** the Nucleo (x 203 and more: the Nucleo covers x 120-203, y 20-90) -> forward along the right edge to the terminal | about 22 cm (15 cm to board B before) | **fits** with a 30 cm lead; the run along plate 2's right edge is to confirm on the vehicle. *2026-10-30 (HW-23): the lead is the 20 cm Dupont jumpers, cut at A's terminal, and the DE-9 tails (20 cm) end in the same clamps. Both are short for this estimate: lay them on the vehicle before cutting.* *2026-11-01 (HW-24): the terminal is on **board B** again, at B·A13 / A11 / A9, plate 2 x 146-156, y 107.6, opening to the vehicle's left edge. The route goes to the left edge behind the Nucleo instead; the left edge is nearer the slot's y 74, so the estimate drops by about 4 cm, to about 18 cm. Still to lay on the vehicle* |

No other BOM item touches the FRDM (Ethernet, USB-A, audio and the 40-pin header are unused). Nothing here needs a change to the tray. **To confirm on the vehicle:** the J11 cable's bend behind the fascia, and the J1 plug's clearance
over the right rib.

**Checked (2026-10-06, every vertex of the STL against `hardware/scripts/chassis-layout.py`).** No vertex is outside plate 3, the nearest is 3.7 mm inside it (the Pi pad's front corners, where the plate narrows). All 14 fixings land on a plate
hole of the right size, 10.6 mm or more from every counterbore. The FRDM pad's rear edge is 4.4 mm short of the chassis standoffs' hexagons. One solid.

**Accepted risks.** The FRDM connector boxes are from a photo (+-1 mm, heights guessed), so they judge placement and build nothing; the tray's only dependence on them is the plug gap (generous) and the rear room (4.4 mm). The Pi's port block and GPIO position are indicative.
Nothing has been printed or dry-fitted; the carrier tray's fit review (MEC-17) is the model for the first fit on the real boards.

---

## MEC-19 · A separate pad spread over plate 2's rear

**Status (2026-10-06): ordered 2026-10-06 (BOM 3.28); modelled, checked against the plate data, not printed.** Source: [`../mechanical/cad/plate2-rear-pad.scad`](../mechanical/cad/plate2-rear-pad.scad) -> `plate2-rear-pad.stl`.
A third part in the same print order as the carrier tray (MEC-17) and the compute tray (MEC-18). PETG, 4 mm, flat. **55 x 96 x 4 mm.**

**Why a separate part, not a longer carrier tray.** Hedi asked whether the carrier tray should reach plate 2's rear. It should not: the carrier tray in the cart was already fit-reviewed (MEC-17), and a longer one meant a new STL, a new review and
swapping the file. A separate pad changes nothing else. It was first drawn small (30 x 43 mm); Hedi then asked for it to be **spread over plate 2**, the way the compute tray spreads over plate 3, and this is that version.

**Where.** x 196-251, y 12-108, behind the carrier tray. It stays clear of:

- the carrier tray: its rear corner pads end at x 191.6, 4.4 mm ahead;
- the chassis standoffs at (256.82, 22.17 and 98.36): 2.3 mm to the nearest hexagon corner;
- the cross-slot (x 260.3-265.7) and the fascia's pads and clamp holes (x 262.9);
- the Discovery, which overhangs the carrier tray to x 217.5 at z 95 and above. The pad is 4 mm tall, so nothing meets it.

**The J7 lane and the harness cross it.** The CAN lead (MEC-18) comes down the cross-slot at about y 74 and runs to plate 2's right edge behind the Nucleo, then forward to board A's CAN terminal: a diagonal over the pad's top, where it lies like any wire. Keep that lane (from about y 74 at the slot to the right edge) free of drilled parts, or tie the lead down. *Updated 2026-10-27: it ran to board B (y 92 at x 190, lane y 70-96) until the Nucleo moved the transceiver to A (MEC-15).* *Updated 2026-11-01 (HW-24): the terminal is on board B again, so the lane runs from the slot at about y 74 to plate 2's left edge.*
The harness to the fascia's ports (MEC-12) lies over the pad the same way. The pad has no windows, so plate 2's three long slots under it (x 203.5, 219.5, 235.5, y 26-94) are covered; nothing in the BOM passes through them.

**Six fixings, from below** into nuts held in pockets on top, each on an opening plate 2 already has: two places along the long slot at x 203.47-207.77 ((205.62, 40) and (205.62, 80); the slot is 4.29 mm wide, so the screw may slide along it, a washer under the head, and the pad can be moved along y by hand before it is tightened),
M2.5 into the holes at (227.88, 20.23 and 100.23), M3 into the holes at (245.88, 38.76 and 81.77). The harness taped under plate 2 stops at x 202, so the heads are free.

**Checked (2026-10-06, against `hardware/scripts/chassis-layout.py`).** The pad is inside plate 2 with 10.5 mm to its edge. All four plate holes exist at the sizes the fixings need; both slot fixings are inside the slot with at least 2.15 mm to its ends; the fixings are 25.8 mm or more apart and 5.1 mm or more from the pad's edge. One solid. Drawn on the layout drawing (R1-R6) and animated in `animate-carrier-tray.py` (step 8).

**Open.** The M3 and M2.5 nuts' real across-flats and thickness (assumed 5.5 / 2.4 and 5.0 / 2.4 mm). Nothing is planned for the pad yet; it is a drilling zone. Hardware: BOM 3.27.
