BaslyHedi/Nexus-Platform/requirements/TRACE.md

# Traceability

Generated by [`../tools/check-requirements.py`](../tools/check-requirements.py) from the requirement files; do not edit. The interactive view is [renders/traceability.html](renders/traceability.html).

154 requirements in 21 files: 39 system, 54 subsystem, 61 component.

## Needs

| Need | Requirements |
|---|---|
| Deliverable 1.1 | Nexus-Vehicle-R001, Nexus-Vehicle-R002, Nexus-Vehicle-R003, Nexus-Vehicle-R004, Nexus-Vehicle-R005, Nexus-Vehicle-R006, Nexus-Vehicle-R007 |
| Deliverable 1.2 | Nexus-Enabling-R010 |
| Deliverable 1.7 | Nexus-Enabling-R001, Nexus-Enabling-R002, Nexus-Enabling-R003, Nexus-Enabling-R004, Nexus-Enabling-R005, Nexus-Enabling-R011 |
| Phase 1 goal: no motors driven | Nexus-Vehicle-R010 |
| Phase 1: 201 fitted and powered but not driven | Nexus-Vehicle-R008 |
| Phase 1: 202 fitted and powered but not driven | Nexus-Vehicle-R009 |
| Phase 1: 503 debug access | Nexus-Vehicle-R022 |
| T1.1 | Nexus-Enabling-R012, Nexus-Vehicle-R012, Nexus-Vehicle-R013, Nexus-Vehicle-R014, Nexus-Vehicle-R015, Nexus-Vehicle-R018 |
| T1.2 | Nexus-Enabling-R015, Nexus-Enabling-R016, Nexus-Vehicle-R016 |
| T1.3 | Nexus-Vehicle-R017 |
| T2.1 | Nexus-Enabling-R006, Nexus-Enabling-R007, Nexus-Vehicle-R018 |
| T2.2 | Nexus-Enabling-R008, Nexus-Enabling-R009, Nexus-Vehicle-R018, Nexus-Vehicle-R019 |
| T2.3 | Nexus-Enabling-R013, Nexus-Enabling-R014, Nexus-Vehicle-R011, Nexus-Vehicle-R020, Nexus-Vehicle-R021, Nexus-Vehicle-R023 |

## Tests

Each phase test and the requirements it verifies directly.

| Test | Requirements |
|---|---|
| T1.1 | Nexus-Enabling-R012, Nexus-Physical-01-04-R001, Nexus-Physical-01-04-R002, Nexus-Physical-01-04-R003, Nexus-Physical-01-04-R004, Nexus-Physical-01-04-R005, Nexus-Physical-01-04-R006, Nexus-Physical-01-04-R007, Nexus-Physical-01-04-R012, Nexus-Physical-01-06-R004, Nexus-Physical-01-06-R006, Nexus-Physical-02-03-R006, Nexus-Physical-02-05-R001, Nexus-Physical-02-05-R002, Nexus-Physical-02-05-R003, Nexus-Physical-04-R006 |
| T1.2 | Nexus-Enabling-R015, Nexus-Enabling-R016, Nexus-Physical-01-04-R009, Nexus-Physical-01-05-R001, Nexus-Physical-01-05-R002, Nexus-Physical-01-05-R003, Nexus-Physical-01-05-R005 |
| T1.3 | Nexus-Physical-01-04-R010, Nexus-Physical-01-04-R011, Nexus-Physical-01-05-R004, Nexus-Physical-01-06-R005 |
| T2.1 | Nexus-Enabling-R006, Nexus-Enabling-R007, Nexus-Physical-02-04-R003, Nexus-Physical-02-05-R004, Nexus-Physical-02-06-R001 |
| T2.2 | Nexus-Enabling-R008, Nexus-Enabling-R009, Nexus-Physical-02-01-R004, Nexus-Physical-02-02-R001, Nexus-Physical-02-03-R002, Nexus-Physical-02-03-R003 |
| T2.3 | Nexus-Physical-01-06-R001, Nexus-Physical-01-06-R002, Nexus-Physical-01-06-R003, Nexus-Physical-02-01-R002, Nexus-Physical-02-03-R001, Nexus-Physical-02-03-R004, Nexus-Physical-02-03-R005, Nexus-Physical-02-04-R001, Nexus-Physical-02-04-R002, Nexus-Physical-04-R001, Nexus-Physical-04-R006, Nexus-Physical-04-R007, Nexus-Physical-04-R008 |

## Function allocation

Which systems hold requirements on each function, from the `Function` fields.

| Function | Systems |
|---|---|
| `Nexus-Logical-101-F01` | Nexus-Vehicle |
| `Nexus-Logical-101-F02` | 05, Nexus-Vehicle |
| `Nexus-Logical-101-F03` | 05, Nexus-Vehicle |
| `Nexus-Logical-101-F04` | Nexus-Vehicle |
| `Nexus-Logical-101-F05` | 01, 01-01, 01-02, 02, 02-01, 05, Nexus-Vehicle |
| `Nexus-Logical-102-F01` | 06, Nexus-Vehicle |
| `Nexus-Logical-102-F02` | Nexus-Vehicle |
| `Nexus-Logical-102-F03` | 06, Nexus-Vehicle |
| `Nexus-Logical-201-F01` | 01, 01-01, 01-02, 07, Nexus-Vehicle |
| `Nexus-Logical-202-F01` | 01, 01-01, 01-02, 08, Nexus-Vehicle |
| `Nexus-Logical-401-F01` | 01, 01-01, 01-02, 01-03, 01-04, 01-06, 02, 02-01, 02-03, 02-04, 04, Nexus-Vehicle |
| `Nexus-Logical-501-F01` | 02, 02-01, 02-02, 02-03, Nexus-Vehicle |
| `Nexus-Logical-501-F02` | 05, 06, Nexus-Vehicle |
| `Nexus-Logical-503-F03` | 02, 02-03, Nexus-Vehicle |
| `Nexus-Logical-503-F04` | 01, 01-01, 01-04, 01-05, 01-06, 02, 02-01, 02-04, 02-05, 02-06, 04, Nexus-Vehicle |
| `Nexus-Logical-504-F01` | 01, 01-01, 01-04, 01-05, 01-06, 02, 02-03, 02-05, Nexus-Vehicle |
| `Nexus-Logical-504-F02` | 01, 01-04, 01-05, Nexus-Vehicle |
| `Nexus-Logical-504-F03` | 01, 01-04, Nexus-Vehicle |

## Derivation

- **Nexus-Vehicle-R001**: The vehicle shall operate from the on-board battery without an external supply.
  - **Nexus-Physical-01-R001**: The node shall run from the 5 V supply of the power element.
    - **Nexus-Physical-01-01-R001**: The MCU board shall run from 5 V applied to E5V, CN7 pin 6, with JP5 on [5-6].
    - **Nexus-Physical-01-02-R001**: The carrier shall feed the 5 V supply into E5V, CN7 pin 6 of the MCU board.
  - **Nexus-Physical-02-R001**: The node shall run from the 5 V supply of the power element.
    - **Nexus-Physical-02-01-R001**: The FRDM board shall run from 5 V on USB-C port J1 without USB power delivery.
  - **Nexus-Physical-05-R001**: The element shall supply 5 V to the STM32 node and to the FRDM node from one converter, s…
- **Nexus-Vehicle-R002**: The vehicle shall give the operator a switch for the drive power that leaves the computin…
  - **Nexus-Physical-05-R005**: SW1 shall switch the drive branch, which consists of the motor driver and the UBEC.
  - **Nexus-Physical-05-R006**: SW2 shall switch the logic branch, which consists of the 5 V converter.
  - **Nexus-Physical-06-R003**: SW1 shall carry the legend DRIVE.
  - **Nexus-Physical-06-R004**: SW2 shall carry the legend LOGIC.
- **Nexus-Vehicle-R003**: If a current exceeds the rating of the conductor that carries the current, then the vehic…
  - **Nexus-Physical-05-R007**: The pack connector shall be the only disconnect in the main current path of the pack.
  - **Nexus-Physical-05-R008**: The main fuse shall be rated 7.5 A.
  - **Nexus-Physical-05-R009**: The main fuse shall sit within 15 cm of the positive battery terminal.
  - **Nexus-Physical-05-R010**: The motor-driver fuse and the UBEC fuse shall each be rated 5 A.
- **Nexus-Vehicle-R004**: The vehicle shall accept charge from the supplied charger. *(as-is to Nexus-Physical-05)*
- **Nexus-Vehicle-R005**: The vehicle shall hold each component in a defined position.
  - **Nexus-Physical-06-R001**: The element shall carry the components on three decks as allocated by MEC-12.
- **Nexus-Vehicle-R006**: The vehicle shall enclose the wiring and the electronics against contact from outside the… *(as-is to Nexus-Physical-06)*
- **Nexus-Vehicle-R007**: The vehicle shall present the power switches and the service ports on one face, reachable…
  - **Nexus-Physical-06-R002**: The rear fascia shall carry SW1, SW2, the DE-9 port, the ST-LINK USB port and the FRDM co…
- **Nexus-Vehicle-R008**: The vehicle shall carry a rear-wheel drive, fitted and supplied with power.
  - **Nexus-Physical-01-R016**: The node shall bring out I2C on PB6 and PB7 to the motor driver.
    - **Nexus-Physical-01-01-R006**: The MCU board shall leave PB6 and PB7 free for I2C1.
    - **Nexus-Physical-01-02-R005**: The carrier shall connect PB6 and PB7 to the motor driver header.
  - **Nexus-Physical-05-R002**: The element shall supply the motor driver at pack voltage through SW1 and a 5 A fuse.
  - **Nexus-Physical-07-R001**: The element shall drive the rear wheels with two 12 V encoder gear motors through the Enc…
- **Nexus-Vehicle-R009**: The vehicle shall carry an Ackermann front steering, fitted and supplied with power.
  - **Nexus-Physical-01-R017**: The node shall bring out the servo PWM on PC2 through a 1 kΩ series resistor.
    - **Nexus-Physical-01-01-R007**: The MCU board shall leave PC2 free for channel 4 of TIM4.
    - **Nexus-Physical-01-02-R006**: The carrier shall connect PC2 to the servo header through R4, rated 1 kΩ.
  - **Nexus-Physical-01-R018**: The node shall pass the 6 V servo supply from the UBEC to the servo header.
    - **Nexus-Physical-01-02-R007**: The carrier shall pass the 6 V UBEC supply to the servo header.
    - **Nexus-Physical-01-02-R008**: The carrier shall hold C2, rated 470 µF, across the servo header.
  - **Nexus-Physical-05-R003**: The element shall supply the steering servo at 6 V from a UBEC fed through SW1.
  - **Nexus-Physical-05-R004**: The element shall isolate the steering servo from each 5 V rail.
  - **Nexus-Physical-08-R001**: The element shall steer the front wheels with the LD-1501MG servo through the Ackermann l…
- **Nexus-Vehicle-R010**: While the vehicle has received no drive command, the vehicle shall keep the rear wheels s… *(as-is to Nexus-Physical-07)*
- **Nexus-Vehicle-R011**: The vehicle shall show continuously on the diagnostic port that the on-board software is…
  - **Nexus-Physical-01-R002**: The node shall connect to the bus through an SN65HVD230 transceiver on FDCAN2, with PB12…
    - **Nexus-Physical-01-01-R002**: The MCU board shall leave PB12 and PB13 free for FDCAN2.
    - **Nexus-Physical-01-02-R002**: The carrier shall connect PB12 to the receive output of the transceiver module.
    - **Nexus-Physical-01-02-R003**: The carrier shall connect PB13 to the transmit input of the transceiver module.
    - **Nexus-Physical-01-02-R004**: The carrier shall carry no CAN termination resistor.
    - **Nexus-Physical-01-03-R001**: The transceiver module shall translate between the CAN bus and the 3.3 V logic of the STM…
    - **Nexus-Physical-01-04-R001**: The bootloader shall operate CAN1 at the bit rate of the CAN matrix.
    - **Nexus-Physical-01-06-R001**: The application shall operate CAN1 at the bit rate of the CAN matrix.
  - **Nexus-Physical-01-R003**: The node shall terminate the bus at the STM32 end.
    - **Nexus-Physical-01-03-R002**: The transceiver module shall terminate the bus with the 120 Ω resistor of the module.
  - **Nexus-Physical-01-R004**: The node shall publish a heartbeat at the rate set in the CAN matrix.
    - **Nexus-Physical-01-06-R002**: The application shall publish a Cyphal heartbeat at the rate set in the CAN matrix.
  - **Nexus-Physical-01-R005**: When the node receives a heartbeat from the FRDM node, the node shall indicate the recept…
    - **Nexus-Physical-01-06-R003**: When the application receives a heartbeat from the FRDM node, the application shall indic…
  - **Nexus-Physical-02-R002**: The node shall connect to the bus through the on-board transceiver, on pins 8 and 10 of t…
    - **Nexus-Physical-02-01-R002**: The FRDM board shall present CAN_H and CAN_L of the on-board transceiver on pins 8 and 10…
    - **Nexus-Physical-02-03-R001**: The Linux image shall bring up the CAN interface at the bit rate of the CAN matrix.
  - **Nexus-Physical-02-R003**: The node shall terminate the bus at the FRDM end.
    - **Nexus-Physical-02-01-R003**: The FRDM board shall terminate the bus with jumper JP1 fitted.
  - **Nexus-Physical-02-R004**: The node shall publish a heartbeat at the rate set in the CAN matrix.
    - **Nexus-Physical-02-04-R001**: The heartbeat program shall publish a Cyphal heartbeat at the rate set in the CAN matrix.
  - **Nexus-Physical-02-R005**: When the node receives a heartbeat from the STM32 node, the node shall log the heartbeat.
    - **Nexus-Physical-02-04-R002**: When the heartbeat program receives a heartbeat from the STM32 node, the heartbeat progra…
  - **Nexus-Physical-04-R001**: The bus shall operate as classic CAN at 500 kbit/s.
  - **Nexus-Physical-04-R002**: The bus shall consist of a twisted pair CAN_H and CAN_L with a CAN_GND reference.
  - **Nexus-Physical-04-R003**: The bus shall have exactly two 120 Ω terminations, one at each end.
  - **Nexus-Physical-04-R006**: The bus traffic shall use the identifiers and the timing of the CAN matrix released by ta…
  - **Nexus-Physical-04-R007**: While each node publishes heartbeats, the bus shall run for 10 minutes with zero error fr…
  - **Nexus-Physical-04-R008**: While each node publishes heartbeats, the bus shall run for 10 minutes with zero bus-off…
- **Nexus-Vehicle-R012**: When an external tool sends new control software to the diagnostic port, the vehicle shal…
  - **Nexus-Physical-01-R006**: When the node receives a software-update request, the node shall receive the image over t…
    - **Nexus-Physical-01-04-R002**: When a software-update request arrives, the bootloader shall pull the image from the requ…
  - **Nexus-Physical-01-R007**: When the node has received an image, the node shall program the image into the applicatio…
    - **Nexus-Physical-01-04-R003**: When the image is received, the bootloader shall erase and program the application region…
  - **Nexus-Physical-01-R008**: When the CRC of the programmed image matches, the node shall start the image.
    - **Nexus-Physical-01-04-R004**: When the application region is programmed, the bootloader shall compute the CRC of the pr…
    - **Nexus-Physical-01-04-R005**: When the CRC of the programmed image matches, the bootloader shall jump to the applicatio…
    - **Nexus-Physical-01-06-R004**: The application shall be linked for the application region of the memory map of the node.
  - **Nexus-Physical-04-R001**: The bus shall operate as classic CAN at 500 kbit/s.
  - **Nexus-Physical-04-R006**: The bus traffic shall use the identifiers and the timing of the CAN matrix released by ta…
- **Nexus-Vehicle-R013**: The vehicle shall install new control software held on board, with no external tool attac…
  - **Nexus-Physical-01-R006**: When the node receives a software-update request, the node shall receive the image over t…
    - **Nexus-Physical-01-04-R002**: When a software-update request arrives, the bootloader shall pull the image from the requ…
  - **Nexus-Physical-01-R007**: When the node has received an image, the node shall program the image into the applicatio…
    - **Nexus-Physical-01-04-R003**: When the image is received, the bootloader shall erase and program the application region…
  - **Nexus-Physical-01-R008**: When the CRC of the programmed image matches, the node shall start the image.
    - **Nexus-Physical-01-04-R004**: When the application region is programmed, the bootloader shall compute the CRC of the pr…
    - **Nexus-Physical-01-04-R005**: When the CRC of the programmed image matches, the bootloader shall jump to the applicatio…
    - **Nexus-Physical-01-06-R004**: The application shall be linked for the application region of the memory map of the node.
  - **Nexus-Physical-02-R006**: When the bootloader of the STM32 node requests an image, the node shall serve the image.
    - **Nexus-Physical-02-03-R006**: The Linux image shall include the flashing client of a tagged Nexus-CAN-Utils release.
    - **Nexus-Physical-02-05-R001**: When a node requests an image, the flashing client shall serve the image as a Cyphal file…
    - **Nexus-Physical-02-05-R002**: The flashing client shall run on Linux.
    - **Nexus-Physical-02-05-R003**: The flashing client shall log each download with the image version and the result.
  - **Nexus-Physical-04-R006**: The bus traffic shall use the identifiers and the timing of the CAN matrix released by ta…
- **Nexus-Vehicle-R014**: If an update is interrupted, then the vehicle shall remain ready to receive a new update.
  - **Nexus-Physical-01-R009**: If a download is interrupted, then the node shall remain ready for a new download.
    - **Nexus-Physical-01-04-R006**: If a download is interrupted, then the bootloader shall remain reachable over the bus.
- **Nexus-Vehicle-R015**: If the new control software is invalid, then the vehicle shall remain ready to receive a…
  - **Nexus-Physical-01-R008**: When the CRC of the programmed image matches, the node shall start the image.
    - **Nexus-Physical-01-04-R004**: When the application region is programmed, the bootloader shall compute the CRC of the pr…
    - **Nexus-Physical-01-04-R005**: When the CRC of the programmed image matches, the bootloader shall jump to the applicatio…
    - **Nexus-Physical-01-06-R004**: The application shall be linked for the application region of the memory map of the node.
  - **Nexus-Physical-01-R010**: If the application region holds no valid image, then the node shall remain ready for a ne…
    - **Nexus-Physical-01-04-R007**: If the application region holds no valid image, then the bootloader shall remain reachabl…
- **Nexus-Vehicle-R016**: When an external tool sends a new update mechanism to the diagnostic port, the vehicle sh…
  - **Nexus-Physical-01-R011**: The flash of the node shall hold the bootloader region apart from the application region.
    - **Nexus-Physical-01-01-R003**: The flash of the STM32H533 shall allow the bootloader sectors to be erased apart from the…
    - **Nexus-Physical-01-04-R008**: The bootloader shall reside in the bootloader region of the memory map of the node.
    - **Nexus-Physical-01-06-R004**: The application shall be linked for the application region of the memory map of the node.
  - **Nexus-Physical-01-R012**: The node shall let an image run from the application region rewrite the bootloader region.
    - **Nexus-Physical-01-01-R003**: The flash of the STM32H533 shall allow the bootloader sectors to be erased apart from the…
    - **Nexus-Physical-01-04-R009**: The bootloader shall download and start the FBL-Updater as an application image.
    - **Nexus-Physical-01-05-R001**: The FBL-Updater shall be an image for the application region.
    - **Nexus-Physical-01-05-R002**: The FBL-Updater shall rewrite the bootloader region with a new bootloader.
    - **Nexus-Physical-01-05-R003**: The FBL-Updater shall verify the rewritten bootloader region.
  - **Nexus-Physical-04-R006**: The bus traffic shall use the identifiers and the timing of the CAN matrix released by ta…
- **Nexus-Vehicle-R017**: The vehicle shall show the state of the software update without tools.
  - **Nexus-Physical-01-R013**: The user LED of the node shall show a distinct pattern for each of these states: bootload…
    - **Nexus-Physical-01-01-R004**: The MCU board shall provide a user LED driven by the STM32H533.
    - **Nexus-Physical-01-04-R010**: While idle, the bootloader shall show the idle pattern on the user LED.
    - **Nexus-Physical-01-04-R011**: While receiving an image, the bootloader shall show the receiving pattern on the user LED.
    - **Nexus-Physical-01-05-R004**: While running, the FBL-Updater shall show the FBL-Updater pattern on the user LED.
    - **Nexus-Physical-01-06-R005**: While running, the application shall show the application pattern on the user LED.
- **Nexus-Vehicle-R018**: When a user requests the software versions, the vehicle shall report the name and the ver…
  - **Nexus-Physical-01-R014**: When asked over the bus, the node shall report the version of the running program in the…
    - **Nexus-Physical-01-04-R012**: When asked over the bus, the bootloader shall report the bootloader version in the node i…
    - **Nexus-Physical-01-05-R005**: When asked over the bus, the FBL-Updater shall report the FBL-Updater version in the node…
    - **Nexus-Physical-01-06-R006**: When asked over the bus, the application shall report the application version in the node…
  - **Nexus-Physical-02-R009**: When asked on the console, each program of the node shall report the name and the version…
    - **Nexus-Physical-02-04-R003**: When asked on the console, the heartbeat program shall print the name and the version of…
    - **Nexus-Physical-02-05-R004**: When asked on the console, the flashing client shall print the name and the version of th…
    - **Nexus-Physical-02-06-R001**: When started, each test application shall print the name and the version of the test appl…
- **Nexus-Vehicle-R019**: When the vehicle powers up, the vehicle shall start the on-board software from on-board s…
  - **Nexus-Physical-02-R007**: When the node powers up, the node shall boot from the SD card.
    - **Nexus-Physical-02-01-R004**: When powered up, the FRDM board shall boot from the SD card.
    - **Nexus-Physical-02-01-R006**: The boot switch SW1 of the FRDM board shall be set to 0011, which selects the SD card.
    - **Nexus-Physical-02-02-R001**: The SD card shall hold the Linux image.
    - **Nexus-Physical-02-03-R002**: When the FRDM board powers up, the Linux image shall boot to a login prompt.
  - **Nexus-Physical-02-R008**: The image of the node shall carry each released application.
    - **Nexus-Physical-02-03-R003**: The Linux image shall carry each released application at the release tag of the applicati…
- **Nexus-Vehicle-R020**: The vehicle shall accept a PC on the diagnostic port as a further node of the CAN bus.
  - **Nexus-Physical-04-R004**: The diagnostic port shall be a male DE-9 wired to CiA 303-1: pin 2 CAN_L, pin 3 CAN_GND,…
  - **Nexus-Physical-04-R005**: Pin 9 of the diagnostic port shall stay unconnected.
- **Nexus-Vehicle-R021**: The vehicle shall keep the CAN communication free of errors with or without a PC on the d…
  - **Nexus-Physical-04-R003**: The bus shall have exactly two 120 Ω terminations, one at each end.
  - **Nexus-Physical-04-R007**: While each node publishes heartbeats, the bus shall run for 10 minutes with zero error fr…
  - **Nexus-Physical-04-R008**: While each node publishes heartbeats, the bus shall run for 10 minutes with zero bus-off…
- **Nexus-Vehicle-R022**: The vehicle shall give external access for debugging the on-board software.
  - **Nexus-Physical-01-R015**: The node shall give SWD access through the on-board ST-LINK.
    - **Nexus-Physical-01-01-R005**: The MCU board shall provide SWD to the STM32H533 through the on-board STLINK-V3EC over US…
  - **Nexus-Physical-02-R012**: The UART console of the node shall be reachable through the USB-C debug port.
    - **Nexus-Physical-02-01-R005**: The FRDM board shall provide the UART console on USB-C port J11.
- **Nexus-Vehicle-R023**: The vehicle shall record the internal communication on board, with a timestamp for each m…
  - **Nexus-Physical-02-R010**: The node shall present the CAN controller as a SocketCAN interface.
    - **Nexus-Physical-02-03-R004**: The Linux image shall include SocketCAN support for the FlexCAN controller.
  - **Nexus-Physical-02-R011**: The node shall record the bus traffic with candump, with a timestamp for each frame.
    - **Nexus-Physical-02-03-R005**: The Linux image shall include the candump tool.
