BaslyHedi/Nexus-Platform/bom/parts/3.4b-Bauer-15W/SPECS.md

# 3.4b - Bauer Electronics DC-DC 12 V → 5 V, 3 A / 15 W (Wire)

No manufacturer datasheet published. Listing captured 2026-09-12 from Amazon.de, €11.99.

| Parameter | Value |
|---|---|
| Input | 8–32 V DC |
| Output | 5 V, 3 A, 15 W |
| **Dimensions** | **53 × 27 × 14 mm** (one of the few listings with real data) |
| Connection | tinned flying leads |
| Protection | over-voltage, reverse polarity, short circuit, overload, over-temperature |
| Construction | epoxy potted, IP68 |
| Reputation | 464 ratings @ 4.5, #1 best seller, *"customers usually keep this item"* |

**Role:** MCU rail, feeds the STM32F407 Discovery. Heavily over-specified for a board
drawing ~0.3 A, which leaves headroom for sensors on the same rail.
