BaslyHedi/Nexus-Platform/bom/parts/3.8-Geloo-Fuse-Block/SPECS.md

# 3.8 - Geloo 6-way blade fuse block (ASIN B08CKMSSX5)

No datasheet; listing captured 2026-09-12 from Amazon.de, €12.34, 4.6★ (195).

| Parameter | Value |
|---|---|
| Ways | 6 |
| Current | 30 A per circuit, 100 A per panel |
| Voltage | 32 V max |
| Terminals | screw, **one positive AND one negative per circuit** |
| Indicators | red LED per circuit, lights when that fuse blows |
| Material | PBT / polycarbonate, marine-grade stainless screws |
| Cover | clear, splash- and dust-proof |
| Mounting | 4 pre-formed holes |
| Dimensions | **listing says "8.8 × 8.8 × 8.8 cm" - placeholder junk. Measure on arrival** |

**Why this part:** the negative bus is what makes it a distribution *board* rather than a
fuse holder. Every return lands on one bar, which is the star ground for the whole vehicle.

**Considered and rejected:** FULARR 6-way (B07GXCR732), 115 × 53 × 42 mm. Narrower, but
only 8 % less deck area, no negative bus, no blown-fuse LEDs, 6.3 mm spade terminals
instead of screws, and 12 mm taller - worse on the deck gap, which is the tighter constraint.
