BaslyHedi/Nexus-Platform/decisions/SW-Software-Decisions.md

# SW · Software design decisions

Firmware and Linux-side decisions - RTOS choice and configuration, the CAN matrix in software,
service layout, build and OTA. Numbering is `SW-nn`, unique across the project and never reused.
Format, and how to add one: [README](README.md).

| # | Decision |
|---|---|
| **SW-01** | The flash bootloader speaks OpenCyphal, not UDS |
| **SW-02** | The FBL's Cyphal stack is written in-house, not taken from libcanard |
| **SW-03** | The FBL is written in C++17, as a freestanding subset |
| **SW-04** | The STM32 flash holds the FBL in sectors 0 to 4 and the application in sectors 5 to 11 |
| **SW-05** | The FBL uses the main SRAM only, leaves the CCM empty and does not use the FPU |
| **SW-06** | The application hands over to the FBL through the backup SRAM |
| **SW-07** | The FBL executes from the SRAM, not from the flash |
| **SW-08** | Every image carries a 64-byte version record at a fixed offset. *Offset moved to 0x400 by SW-11* |
| **SW-09** | STM32H533 flash map: FBL, CFG and NvM in bank 1, the application alone in bank 2 (256 KB), one image and no bank swap |
| **SW-10** | The FBL uses SRAM1 only and no FPU; the hand-off record is in the 2 KB backup SRAM |
| **SW-11** | The FBL still runs from the SRAM; the H533 vector table is 596 bytes, so the version record moves to 0x400 |

The rest of what Phase 1 has to settle is listed in [`../system/phases.md`](../system/phases.md) under
*Decided in Phase 1*: the CAN matrix and its tooling, the Zephyr board port, the
repository and CI template, and how the STM32 reports a fault to the i.MX 91. Related hardware constraints are
[HW-10](HW-Electrical-Decisions.md) (I²C pins) and [SYS-01](SYS-System-Decisions.md) (over-discharge protection).

---

## SW-01 · The flash bootloader speaks OpenCyphal, not UDS

**Updated by SW-02:** the FBL's Cyphal stack is written in-house; `libcanard` is a design reference and the fallback, not a dependency. Read the libcanard items under *Consequences* and *To confirm* against the in-house stack. The language is C++17 ([SW-03](#sw-03--the-fbl-is-written-in-c17-as-a-freestanding-subset)).

**Decision (2026-10-11).** The STM32 flash bootloader (FBL) receives its application image over
**Cyphal/CAN** (OpenCyphal v1) on the 500 kbit/s classic-CAN bus. The host sends a software-update command to
the node, and the bootloader then **pulls** the image from a file server block by block, verifies it and jumps
to it. The FBL stays **bare-metal and small**. The host side is a file server in `Nexus-CAN-Utils`, which must
run on Linux so it works from the PC adapter now and from the i.MX 91 later.

**Why.**

- **The project exists to learn new ground**, and the author already knows UDS and AUTOSAR bootloaders well.
  Cyphal is a different design (publish/subscribe, node-pulled file transfer, typed data from DSDL) used in
  robotics and aviation, which is where NEXUS is heading.
- **It fits the hardware.** Cyphal/CAN runs on classic CAN, which is all the STM32F407's bxCAN and the SN65HVD230
  do. `libcanard` (C, MIT, compact) is built for exactly this kind of deeply embedded target.
- **There is a reference for the bootloader.** Zubax's Kocherga is a platform-agnostic Cyphal/DroneCAN bootloader
  library. It is read as a design reference, not adopted wholesale, so the FBL is still written here.
- Adoption data gathered 2026-10-11 (GitHub and PyPI): `libcanard` 450 stars, `pycyphal` about 7.8k downloads a month,
  against DroneCAN's roughly 68k, ArduPilot 16k stars and PX4 12.8k. It is small next to DroneCAN, and
  Kocherga's last commit is April 2024. For a two-node learning vehicle that is acceptable, since interoperability
  with other vendors' parts is not needed.

**Rejected.**

- **UDS over ISO-TP**: the automotive standard and the cheaper option, since it is familiar. Rejected because the
  familiarity is exactly why it teaches little here. It stays the fallback if Cyphal proves a poor fit.
- **DroneCAN (UAVCAN v0)**: more widely deployed and with the same pull model, but it is the legacy line that
  Cyphal replaces.
- **STM32 ROM bootloader, mcumgr/SMP, DFU**: fast to use, but none of them is a bootloader that the project writes,
  and none runs over the bus the vehicle already has.

**Consequences.**

- `Nexus-CAN-Utils` ships a **Cyphal file server** as the flashing client, and the Linux side needs a Cyphal stack
  (libcanard in C, libcyphal in C++, or `pycyphal` for tooling). The language choice is still open.
- The bootloader needs a **node ID** and a fixed set of subjects and services. Its identifiers, and any ID ranges
  the application uses, are part of the CAN matrix.
- **The application layer is not decided here, and is not a Phase 1 question.** Phase 1 needs only the flashing identifiers and a heartbeat; the application layer is decided in Phase 2. Whether the vehicle's own messages (motion request, state,
  heartbeat) are also Cyphal, with the matrix as a set of DSDL types and a subject-ID table, or a plain-ID matrix
  sharing the bus, is a separate entry. Running both on one bus is possible but needs the ID ranges kept apart.
- Diagnostics (Phase 2) can use Cyphal services instead of UDS. That is also left to its own
  entry.

**To confirm.**

- That `libcanard` builds and runs cleanly on the F407 at 500 kbit/s with the bare-metal FBL's flash and RAM budget.
- That the FBL's size stays small. Kocherga's own footprint is the yardstick to compare against, and it has not been measured.
- The Cyphal services and subject names, from the specification, before the matrix is written. They were recalled
  from memory when this entry was drafted.

---

## SW-02 · The FBL's Cyphal stack is written in-house, not taken from libcanard

**Decision (2026-10-11).** The FBL carries its own implementation of Cyphal/CAN: the CAN identifier layout, the
tail byte, segmentation and reassembly of multi-frame transfers, the transfer CRC and transfer-ID handling, and the
serialization of the standard types it uses. **The scope is what the download needs and nothing more:** publish
`uavcan.node.Heartbeat`, serve `uavcan.node.GetInfo` and `uavcan.node.ExecuteCommand`, and act as a client of
`uavcan.file.Read`. The stack lives in its own folder and build target inside `Nexus-STM32-FBL`, with no dependency
on the rest of the bootloader. Whether it then moves out and is shared, with the App, `Nexus-CAN-Utils` or the
Linux programs, is decided once the FBL works, not now. `libcanard` and Kocherga stay as design references.

**Why.**

- **The protocol is the new ground in the FBL, and a library hides it.** The bootloader mechanics (flash, vector
  table, CRC, jump) are known ground ([`phases.md`](../system/phases.md), *Learning focus*). Linking `libcanard`
  would leave the one unfamiliar part as a black box. `phases.md` already says to take the longer road where a
  library hides the protocol.
- **The scope is small enough to finish.** One node, four ports, and one reassembly session at a time. That is
  a fraction of a general-purpose stack, and it is what T1.1 and T1.2 need.
- **There is an independent implementation to check against.** The PC adapter runs `yakut` and `pycyphal` over
  SocketCAN ([HW-18](HW-Electrical-Decisions.md)), so every frame the in-house stack sends or accepts can be
  tested against a stack it shares no code with.

**Rejected.**

- **`libcanard`** (C, MIT): compact, proven and made for this kind of target. Rejected only because it does the
  part that is meant to be learned. It stays the fallback if the in-house stack proves a poor use of the phase.
- **`libcyphal`** (C++): the same reason, and it is larger.
- **A general-purpose stack written now** (many ports, many sessions, both transports): rejected because no
  second user exists yet. Generality comes with the second user, if it comes.

**Consequences.**

- **Correctness has no library behind it.** The stack is tested on the host, layer by layer, against the
  specification's examples, and on the bench against `yakut`. A download that completes is not enough evidence on
  its own: the multi-frame and error paths need their own tests.
- **The four standard `uavcan` types are serialized by hand.** They belong to the Cyphal specification, not to the
  NEXUS CAN matrix, so the rule that nothing hand-copies a matrix definition ([`phases.md`](../system/phases.md),
  *Repositories*) still holds. Any NEXUS-specific type the FBL needs comes from a `Nexus-CAN-Utils` release.
- **SW-01's footprint question moves to the in-house code.** The size budget is measured on this stack, with
  Kocherga's footprint still the yardstick.
- **The Linux side's stack is still open** (SW-01). The in-house stack becomes one more candidate, which is part
  of why it is kept free of FBL dependencies.

**To confirm.**

- ~~The port IDs and type versions of the four standard types.~~ Checked against Specification v1.0, revision
  2025-05-16 (2026-10-11): Heartbeat 7509 v1.0, GetInfo 430 v1.0, ExecuteCommand 435 v1.3, file.Read 408 v1.1. The
  update command is `COMMAND_BEGIN_SOFTWARE_UPDATE` = 65533. SW-01's to-confirm on names is settled the same way.
- That the stack interoperates with `yakut` at 500 kbit/s: a full download and an interrupted one (T1.1).
- That it fits the FBL's 128 KB region (SW-04), once it is built.

---

## SW-03 · The FBL is written in C++17, as a freestanding subset

**Decision (2026-10-11).** The bootloader and its Cyphal stack ([SW-02](#sw-02--the-fbls-cyphal-stack-is-written-in-house-not-taken-from-libcanard))
are written in **C++17**, built with `arm-none-eabi-gcc`, as a freestanding subset: **no exceptions, no RTTI, no
dynamic allocation**, and no part of the standard library that allocates or pulls in I/O. **C++17 is the starting
point, not the ceiling:** a later move to C++20 is planned, made once the FBL works, as a deliberate step to learn
what the newer standard changes on a known code base. That move gets its own entry. The FBL-Updater's toolchain is
not decided here; [`phases.md`](../system/phases.md) leaves it until it is written.

**Why.**

- **C on bare metal is known ground; C++ on bare metal is not.** C++ is on the project's learning list
  ([`../CLAUDE.md`](../CLAUDE.md)). The FBL is a low-risk place to learn it: it is small, and the ST-LINK stays
  the recovery path (T1.2).
- **Cyphal maps well onto the language.** Node ID, port ID and transfer ID become distinct types, so mixing them
  up is a compile error. CRC tables are computed at compile time with `constexpr`. Buffers have a fixed capacity
  set by a template rather than a macro, with no heap.
- **The Linux side is C++ first** ([`phases.md`](../system/phases.md), *Repositories*). If the Cyphal stack is
  later shared (SW-02), it is already in the language its other users are written in.
- **C++17 is the standard MISRA C++:2023 is written for** (its title: *Guidelines for the use of C++17 in critical
  systems*). Starting on C++17 means the whole code base can sit under one published rule set, with no feature
  outside it.
- **The standard version does not change the image.** For the same source, C++17 and C++20 produce the same code;
  size and speed follow from which features are used. The choice is about how the source is written and which
  rules cover it, so starting on the more conservative standard costs nothing at run time.
- **Migrating later is a lesson in itself.** Moving a working code base to C++20 shows what each feature replaces,
  which is easier to see than starting with it.

**Rejected.**

- **C**: the default for a small bootloader and the language of `libcanard`. Rejected because it keeps the whole
  FBL on known ground.
- **C++20 from the start**: it brings `constinit` (a global that cannot be initialized at compile time becomes a
  build error), concepts, `std::span`, designated initializers and `<bit>`. Only `constinit` is more than a
  convenience, and none lets the FBL do something C++17 cannot. Rejected for now because MISRA C++:2023 would cover
  only the C++17 part of the code. It is the planned second step, not a dead end.
- **Rust**: on the learning list too, but a much larger step on a part that has to work for T1.1 and T1.2. Its
  place is on the Linux side, later.

**Consequences.**

- **The startup code has one more job.** It runs the static constructors before `main`, or the FBL has no
  non-trivial globals. Without `constinit`, that is held by discipline and checked in the map file: an empty
  `.init_array` shows nothing runs before `main`. Nothing may still be pending at the jump to the application.
- **What C++20 would give is written by hand.** A small span type of its own for buffer and length, helpers for
  byte order and bit operations, and `static_assert` on templates where a concept would state a driver's contract.
  These are the places the C++20 migration replaces, so they are kept few and easy to find.
- **Size is watched, not assumed.** A stray `std::function`, `new` or stream pulls library code into the image.
  The map file is checked and CI reports the image size on every build.
- **The coding rules are written down in `Nexus-STM32-FBL`:** MISRA C++:2023 as the reference rule set, which
  standard headers are allowed, and the compiler flags that enforce the subset.
- **Host tests are C++ too**, built for the PC from the same sources.

**To confirm.**

- That the image links with no exception-handling or RTTI support and no allocating library code, shown by the map file.
- That MISRA C++:2023 is written for C++17, as stated above. MISRA's document is not in `vendor/` and this was not checked here.
- That the image fits the FBL's 128 KB region (SW-04) with room for Phase 3's signature checking, measured once it is built.

---

## SW-04 · The STM32 flash holds the FBL in sectors 0 to 4 and the application in sectors 5 to 11

**Superseded by SW-09** (2026-11-01): written for the STM32F407, which failed (HW-22). Kept as the record.

**Decision (2026-10-11).** The STM32F407VGT6 has 1 MB of flash in one bank, in 12 sectors. The map is:

| Region | Sectors | Address range | Size |
|---|---|---|---|
| FBL | 0 to 4 (4 x 16 KB, 1 x 64 KB) | `0x08000000` to `0x0801FFFF` | 128 KB |
| Application | 5 to 11 (7 x 128 KB) | `0x08020000` to `0x080FFFFF` | 896 KB |

The FBL's vector table is at `0x08000000`. The application is linked for `0x08020000`. **No configuration (CFG) region
and no non-volatile memory (NvM) region exist yet.** Both are left open, see *Consequences*.

**Why.**

- **The FBL must be in sector 0.** At reset the core reads its stack pointer and reset vector from `0x00000000`. RM0090
  Rev 22 (section 2.4) gives three boot spaces, chosen by the BOOT pins and latched on the fourth rising SYSCLK edge after
  reset: BOOT0 low is the main flash, aliased at `0x00000000` and so starting at `0x08000000`; BOOT0 high with BOOT1 low is
  the system memory (ST's ROM bootloader, `0x1FFF0000`); both high is the embedded SRAM1. **The only boot address in the
  main flash is therefore the first sector.** The F407 has no boot-address option byte, and the dual-bank boot bit (BFB2)
  belongs to the F42x and F43x. `SYSCFG_MEMRMP` can change what is mapped at `0x00000000` after the boot, which is not a
  second boot address. A region of constants in sector 0 was proposed and dropped for this reason.
- **128 KB is room, not a measured need.** The in-house FBL is expected to fit in far less, but it is not written and
  SW-02 means no library footprint exists to compare against. Phase 3 adds signature checking and anti-rollback to the
  FBL. The application's start address is the one value every application build depends on, so it is fixed generously
  now rather than moved later.
- **The application starts on a 128 KB sector boundary.** Its first erase unit is a full sector, and the region is a
  whole number of sectors of one size.
- **The FBL region is 5 sectors.** Sector 4 is 64 KB, so the FBL-Updater erases four small sectors and one 64 KB sector
  when it rewrites the region.

**Rejected.**

- **FBL of 64 KB (sectors 0 to 3), the first proposal.** Smaller, but it gives Phase 3 no room, and moving the application
  start later breaks every application build.
- **FBL in sectors 5 to 7 (384 KB).** Reset cannot reach it, and it is far larger than the FBL needs.
- **NvM in the 16 KB sectors, with the FBL in sector 0 only (32 KB).** The small sectors minimise the erase time, but a
  32 KB FBL has no room for Phase 3.

**Consequences.**

- **The ST ROM bootloader stays available as a second recovery path.** With BOOT0 high and BOOT1 low the device boots
  from the system memory and offers USART1, USART3, CAN2 and USB DFU (RM0090 section 2.4). It is not used for updates
  (SW-01) and the vehicle's bus is CAN1, but it can reflash a device whose FBL has been lost without the ST-LINK. Its
  entry depends on the BOOT0 pin being reachable on the carrier, which is a hardware question.
- **Flash erase and program stall every flash read on this single-bank part.** Code and data in SRAM keep running, but an
  application that fetches from flash waits for the erase to finish. At 3.3 V with 32-bit programming the datasheet
  (DS8626 Rev 8, Table 40) gives a typical and maximum erase time of 250 ms and 500 ms for a 16 KB sector, 550 ms and
  1.1 s for the 64 KB sector, and 1 s and 2 s for a 128 KB sector. A word takes 16 µs typical and 100 µs at most to program. For a flash-based NvM that means **erase and
  garbage collection can only happen in a safe vehicle state** (standby or off), never while a control loop runs.
  Putting the whole control path in RAM is not a practical way around it.
- **NvM is deferred to Phase 2**, where the plan places configuration and calibration parameters. The options then are
  flash with erase only in a safe state, or an external memory on I²C (no erase, no garbage collection, needs a BOM
  item and a hardware decision). If NvM is on-chip, it is carved from the top of the application region, so only the
  application's end moves and never its start.
- **The FBL-Updater rewrites sectors 0 to 4 and the rewrite is not power-fail safe.** The erase alone takes about 1.6 s
  typical and 3.1 s at most (four 16 KB sectors and the 64 KB one). A power loss from the first erase until the new
  vector table is written leaves no valid FBL, and the ST-LINK is the recovery path, as T1.2 already says.
- **The first FBL goes on with the ST-LINK, by sector erase.** A full-chip erase would also wipe any later NvM.
- **The interface headers and `memory_map.ld` in `Nexus-STM32-FBL` carry these addresses**, and both the FBL and the
  application build take them from there.

**To confirm.**

- ~~The sector layout and addresses.~~ Checked against RM0090 Rev 22, Table 5 (2026-10-11): 4 x 16 KB from `0x08000000`,
  one 64 KB sector at `0x08010000`, 7 x 128 KB from `0x08020000`, last address `0x080FFFFF`.
- That the FBL fits the region with room for Phase 3, measured once it is built.

---

## SW-05 · The FBL uses the main SRAM only, leaves the CCM empty and does not use the FPU

**Superseded by SW-10** (2026-11-01): written for the STM32F407, which failed (HW-22). Kept as the record.

**Updated by SW-06:** the hand-off block lives in the backup SRAM, so it does not depend on the main SRAM surviving a reset. **Updated by SW-07:** the FBL's code and constants are in the SRAM too, so the 128 KB of SRAM holds the code as well as the data.

**Decision (2026-10-11).** The FBL places its stack, variables and buffers in the main SRAM at `0x20000000`. **The
64 KB core-coupled memory (CCM) at `0x10000000` is left empty.** The FBL is built without floating point
(`-mfloat-abi=soft`) and never enables the FPU.

**Why.**

- **Nothing in the FBL needs the CCM.** It reaches the CPU through the data bus only, so no DMA contention touches it,
  which makes accesses deterministic. The FBL has no timing that depends on that. The CCM stays free for data that
  does, when there is some.
- **The CCM is a poor place for anything both images share.** It is a separate region, it needs its own clock enable bit
  in `RCC_AHB1ENR`, and it is reached only by the CPU through the data bus, outside the bus matrix (RM0090 section 2.3.1), so DMA cannot use
  it and instructions are not fetched from it. The hand-off block from the application to the FBL does not live in the
  main SRAM, because RM0090 does not document it as retained across a reset (SW-06).
- **The FBL has no floating-point work.** The FPU is off after reset and the FBL leaves it so. The application
  enables it, which Zephyr does itself. The two images are never linked together, so their ABIs need not match.

**Rejected.**

- **Stack in the CCM from the start**: gains determinism the FBL does not need, and adds a second region to the linker
  script and the startup code.
- **Hard-float in the FBL**: no benefit, and a lazy-stacking cost on interrupt entry for no gain.

**Consequences.**

- `fbl.ld` describes one RAM region. The CCM is not in it.
- The hand-off block is not in the main SRAM. It lives in the backup SRAM (SW-06).

**To confirm.**

- ~~That the main SRAM survives the software reset.~~ Checked against RM0090 Rev 22 (2026-10-11): a system reset sets
  all registers to their reset values and the manual says nothing about the main SRAM, neither kept nor cleared. It
  states that Standby loses it, and a power-on reset leaves it undefined. **Only the backup domain is documented as
  surviving a system reset:** the 4 KB backup SRAM at `0x40024000` to `0x40024FFF` (cleared only by a protection level
  change from 1 to 0) and 20 RTC backup registers (80 bytes). Writing either needs the `PWREN` clock, `PWR_CR.DBP` and,
  for the SRAM, `RCC_AHB1ENR.BKPSRAMEN`. Whether the main SRAM keeps its contents across `SYSRESETREQ` on this part is
  then a measurement on the board, and the hand-off record carries a magic value and a CRC in any case.

---

## SW-06 · The application hands over to the FBL through the backup SRAM

**Superseded by SW-10** (2026-11-01): written for the STM32F407, which failed (HW-22). Kept as the record.

**Decision (2026-10-11).** When the application accepts `uavcan.node.ExecuteCommand` with
`COMMAND_BEGIN_SOFTWARE_UPDATE`, it writes a hand-off record into the **4 KB backup SRAM** (`0x40024000` to
`0x40024FFF`) and resets the device. The FBL reads the record after the reset. **The first 512 bytes of the backup SRAM
are reserved for the record**, which carries the requesting node's ID and the file path, a magic value and a CRC. The
remaining 3.5 KB is not claimed. The record's layout is written in the interface headers of `Nexus-STM32-FBL`.

**Why.**

- **It is the memory the manual documents as surviving a system reset.** RM0090 Rev 22 says a system reset resets
  registers and says nothing about the main SRAM. The backup SRAM is not affected by it, and only a protection level change
  from 1 to 0 clears it (sections 7.1.3 and 5.1.2). The main SRAM would have to be measured on the board, and the manual would still not back the result.
- **It is big enough.** The `ExecuteCommand` parameter is a path of up to 255 bytes, and the record adds the node ID, the
  magic and the CRC. The 80 bytes of the RTC backup registers cannot hold that.
- **It leaves the main SRAM free of an agreement between two images.** Neither image's linker script has to keep the other's
  block out of its `.bss`.

**Rejected.**

- **The main SRAM at a fixed address.** It probably works across a software reset, since no hardware clears it on this
  part, but the manual does not say so, and both linker scripts would have to keep the block out of reach.
- **The RTC backup registers.** Documented to survive, but 80 bytes cannot carry a file path. They stay available for a
  short flag.
- **A flag in the flash.** It costs an erase, which stalls the bus (SW-04) and wears a sector for each update.

**Consequences.**

- **Both images enable the same three things before touching the record:** the `PWR` clock (`RCC_APB1ENR.PWREN`), write
  access to the backup domain (`PWR_CR.DBP`) and the SRAM clock (`RCC_AHB1ENR.BKPSRAMEN`). The application is Zephyr, so
  how it gets there is a question for `Nexus-STM32-App`.
- **After a power-on the record is garbage unless a battery on VBAT keeps the SRAM.** The magic value and the CRC are what
  tell a real request from noise, so the FBL treats anything else as no request.
- **The FBL clears the record once it has read it**, or a later reset would repeat the update.
- **The linker scripts of both images carry the region and the section**, and the numbers are in
  `interface/linker/memory_map.ld`.

**To confirm.**

- The record layout and its size against the 512 bytes reserved.
- Whether the record also carries the node's own node ID, so that the FBL takes the ID the application had, or whether the
  ID is fixed in the CAN matrix (SW-01). When the host sends the command to an FBL that is already running, no record is
  written and the FBL takes the request directly.
- That the backup SRAM keeps its content over the reset from the application on the board.
- Whether the Discovery board's VBAT is wired to a battery or to VDD, which sets what survives a power loss.

---

## SW-07 · The FBL executes from the SRAM, not from the flash

**Updated by SW-11** (2026-11-01): the decision stands on the STM32H533; its numbers (F407 sectors, 98 vectors, 512-byte alignment) are replaced there.

**Decision (2026-10-11).** The FBL is stored in the flash sectors 0 to 4 (SW-04) and **runs from the SRAM**. A small start-up
routine and the vector table stay in the flash. At reset the routine copies the vector table, the code, the constants and the
initialised data to the SRAM, points `VTOR` at the copy in the SRAM, clears the `.bss` and calls `main`. Once `main` runs, no
instruction, constant or vector is fetched from the flash. The constructor tables, if any, are read once, before `main`.

**Why.**

- **Any read of the flash while it is being erased or programmed stalls the bus.** RM0090 Rev 22, section 3.6: "code or data
  fetches cannot be performed while a write/erase operation is ongoing". The F407 has one bank, so there is no other bank to
  read from. A sector erase takes up to 500 ms for 16 KB, 1.1 s for 64 KB and 2 s for 128 KB (SW-04).
- **A stalled FBL drops off the bus.** The FBL erases up to seven sectors of the application region, each taking up to 2 s
  (SW-04). A Cyphal node publishes its heartbeat at least every second and is considered offline after 3 s without one
  (Cyphal Specification v1.0, `uavcan.node.Heartbeat`: `MAX_PUBLICATION_PERIOD` 1 s, `OFFLINE_TIMEOUT` 3 s). A 128 KB erase
  plus one heartbeat period reaches that limit. Requests such as `GetInfo` that arrive during the erase also go unanswered.
  A full frame with a 29-bit identifier and eight data bytes is about 131 bits, so 0.26 ms at 500 kbit/s, and the bxCAN
  holds three frames per receive FIFO (RM0090), so traffic that passes the acceptance filters can overflow a FIFO in
  under 1 ms. With the code, the constants and the vector table in the SRAM, the CPU keeps running while the flash
  controller works.
- **The flash driver only reads and polls registers during the operation.** `FLASH_SR` is polled for the BSY bit. The manual
  notes that a write to `FLASH_CR` with BSY set stalls the bus, so the driver must not write it then.

**Rejected.**

- **Execute in place, with only the erase routine in the SRAM.** The interrupt entry still fetches its vector from the flash
  and the handler runs from the flash, so the first CAN interrupt during an erase stalls.
- **Execute in place and pace the transfer around each erase.** The host's file transfer is driven by the FBL's
  `file.Read` requests (SW-01), so the FBL controls when file data arrives and can erase between requests. That protects the
  file data. It was set aside because it cannot keep the heartbeat going through a single erase, and because every other flash
  read in the FBL, such as a `const` table, is a stall waiting to happen.

**Consequences.**

- **The SRAM budget includes the code.** The FBL's image, plus the 512-byte vector table copy, the `.bss` and a stack,
  must fit in the 128 KB (SW-05). The FBL is far smaller than that today.
- **The start-up routine is the only code that runs from the flash.** It is placed in its own section, `.boot_text`, so the
  linker can keep it in the flash. It must not use a function, a constant or a global that is in the copied image.
- **The vector table has to be aligned.** The F407 has 82 maskable interrupt channels (RM0090 Rev 22), so 98 entries and a
  table of 392 bytes. PM0214 Rev 10, section 4.4.4, sets the minimum `VTOR` alignment at 128 words, which is 512 bytes.
  Bit 29 of the offset selects the SRAM region, which is where the copy lives.
- **The copy is complete before `VTOR` is written.** PM0214 section 4.3.10 requires the new table's fault, NMI and enabled
  interrupt entries to be valid before it is programmed.
- **The application is not affected.** It runs from the flash, as Zephyr does by default, and reinitialises the SRAM when
  it starts. The FBL's SRAM contents do not survive the jump.
- **A debugger sees the code at its SRAM addresses.** The symbols match the running code, and the start-up routine's own
  symbols are at their flash addresses.

**To confirm.**

- ~~The vector alignment.~~ Checked against PM0214 Rev 10 (2026-10-11): 128 words, 512 bytes, for the 98 entries.
- On the board, that the FBL keeps receiving over a 128 KB sector erase.
- The time the start-up copy takes, which has not been measured.

---

## SW-08 · Every image carries a 64-byte version record at a fixed offset

**Updated by SW-11** (2026-11-01): on the STM32H533 the record is at offset `0x400`, not `0x200`. The vector table is 596 bytes there.

**Decision (2026-10-14).** Every image of the STM32 (the FBL, the application, the FBL-Updater) carries a **64-byte version
record at offset `0x200` from the start of its flash region**, after the vector table and before the first code. For the
FBL that is `0x08000200` (SW-04). The record is plain ASCII with fixed field widths, so `strings` on the ELF or the binary
shows it, and a hex or SREC dump shows it at the same place in every image:

| Offset | Size | Content | FBL now |
|---|---|---|---|
| 0 | 3 | software type, `FBL` or `APP` | `FBL` |
| 3 | 1 | separator `_` | |
| 4 | 5 | platform name | `Nexus` |
| 9 | 1 | separator `_` | |
| 10 | 2 | platform version | `v1` |
| 12 | 1 | separator `_` | |
| 13 | 8 | software version `AA-BB-CC`: major, minor, bugfix, two digits each | `00-01-00` |
| 21 | 1 | NUL | |
| 22 | 42 | reserved, `0xFF` | |

`strings` reads `FBL_Nexus_v1_00-01-00`. **The values are written once**, in the project settings of the repository that
builds the image, and the build generates the record and the output file names from them. The build fails when a value does
not fit its field: a version part above 99, a platform name that is not 5 characters, a platform version that is not 2.
The FBL is the first image to carry the record. **The application follows the same pattern, on the application side, later.**

**Why.**

- **A tool has to read the version of an image without parsing it.** The flasher, the image tool and a person with a hex
  dump see the version of an `.srec` or a flash read-back at a known address. A version held only in the ELF's symbols or
  in a build log does not travel with the file that is flashed.
- **It cannot be the first bytes of the image.** At reset the core reads the stack pointer and the reset vector from the
  first two words of the flash (SW-04), so the vector table is first. The record goes directly after it and before the first
  code section.
- **A fixed offset, not "after the table".** The table is 392 bytes for the 98 vectors of the F407 (SW-07) and `0x200` is
  the next 512-byte boundary, the same size as the `VTOR` alignment. The offset does not move if a table changes, and it can
  be the same in the FBL and in the application, so one parser reads both.
- **Fixed widths, not a parsed string.** A reader takes the fields by offset and never scans for separators. A field that
  outgrows its width fails the build, not the parser.
- **The reserved bytes are `0xFF`, the erased state of the flash.** A later field can be written there without moving
  anything that exists.
- **Measured, 2026-10-14:** the FBL image is 772 bytes of flash, the vector table 392 bytes (`0x08000000` to `0x08000187`),
  the record at `0x08000200` to `0x0800023F`, and `strings` on the binary prints only `FBL_Nexus_v1_00-01-00`. Read back from
  the SREC by a script on the host, then from the flash of the board (To confirm, below).

**Rejected.**

- **At the very start of the image.** Not possible, see above.
- **Directly after the vector table, wherever it ends.** The application's table may not be the size of the FBL's, and
  then the two records would be at different offsets.
- **Numbers only, in binary.** Smallest, but `strings` shows nothing and a hex dump needs the layout in hand. The text costs
  21 bytes of a record that has 64.
- **A git hash or a build date in the record.** Not asked for. A build date makes two builds of the same source differ.

**Consequences.**

- **The linker scripts carry the slot.** `interface/linker/memory_map.ld` has `VERSION_OFFSET = 0x200` and
  `VERSION_SIZE = 64`; `fbl.ld` places the section `.version` there and fails the link if the record is missing, is not 64
  bytes, is not at that address, or if the vector table is larger than 512 bytes. The gap between the table and the record
  is never programmed.
- **The record is never copied to the SRAM and the FBL does not read it.** The tools do. The FBL takes the numbers it reports in
  its node info (Nexus-Physical-01-04-R012) from the same settings, at build time.
- **A reader that needs numbers converts `AA-BB-CC` itself.** The record holds text only.
- **The output files carry the same name.** The build writes `FBL_Nexus.srec` and `FBL_Nexus_v1_00-01-00.srec`, the same
  image under a plain and a versioned name.
- **The application follows later.** Its type is `APP`, its record is at `0x08020200` (SW-04), and its linker script has to
  leave the slot free. How the Zephyr build places a section there is a question for `Nexus-STM32-App`.

**To confirm.**

- ~~On the board, that the ST-LINK tools flash the SREC and that a read-back shows the record at `0x08000200`.~~ Checked on
  the STM32F4DISCOVERY (2026-10-14): OpenOCD 0.12.0 through the on-board ST-LINK/V2 flashed `FBL_Nexus.srec` by sector
  erase and verified it, and a read-back of the 64 bytes at `0x08000200` shows `FBL_Nexus_v1_00-01-00`, the NUL, then `0xFF`
  to the end of the record. The configuration and the tasks are in `tools/` and `.vscode/` of `Nexus-STM32-FBL`.
- That the Zephyr application can keep its vector table below `0x200` and place the record at `0x08020200`.
- Whether the record becomes part of the image header, which is still to be decided (the interface headers of
  `Nexus-STM32-FBL`), or stays a separate record next to it.
- Whether the FBL checks the application's record (type `APP`, same platform name and version) before it jumps to it.
- What raises the platform version from `v1`.

---

## SW-09 · STM32H533 flash map: FBL, CFG and NvM in bank 1, the application alone in bank 2 (256 KB), one image and no bank swap

**Decision (2026-11-01).** The STM32H533RE has 512 KB of flash in two banks of 32 sectors of 8 KB, contiguous from
`0x08000000` (RM0481 Rev 5, Table 53). One image is flashed in place and the bank swap (`SWAP_BANK`) is **not used**:

| Region | Sectors | Address range | Size | Bank |
|---|---|---|---|---|
| FBL | 0 to 15 | `0x08000000` to `0x0801FFFF` | 128 KB | 1 |
| CFG | 16 | `0x08020000` to `0x08021FFF` | 8 KB | 1 |
| NvM | 17 to 22 | `0x08022000` to `0x0802DFFF` | 48 KB | 1 |
| Reserve | 23 to 31 | `0x0802E000` to `0x0803FFFF` | 72 KB | 1 |
| Application | 32 to 63 | `0x08040000` to `0x0807FFFF` | 256 KB | 2 |

The FBL's vector table is at `0x08000000`, the default boot address. The application is linked for `0x08040000`, the
start of bank 2. **CFG** holds configuration that does not change at run time; **NvM** holds the data that does. Both
are shared between the FBL and the application. Their content and interface are not defined yet. The reserve is not
claimed: room for a larger FBL (Phase 3) or for more NvM. The numbers are in `interface/linker/memory_map.ld` of
`Nexus-STM32-FBL`. **Bank 2 holds the application and nothing else.**

**Why.**

- **The update comes from the FRDM.** An image lands on the i.MX 91 (FRDM) and goes to the STM32 over CAN, where the FBL
  flashes it in place (SW-01). The FRDM is the staging store and keeps the previous image for a rollback. A bank swap
  would put an A/B copy on the STM32 as well, and cost half of the flash for it.
- **The application gets a bank to itself.** A Zephyr application with CAN, I2C, PWM, logging and Cyphal is estimated at
  100 to 180 KB (not measured, the Zephyr environment is not built yet). 256 KB is above that. A bank swap would have capped it at about 150 KB with a 64 KB FBL, and at
  about 90 KB with the 128 KB one.
- **The boot address is configurable here** (`NSBOOTADD`, RM0481 Tables 25 and 26), unlike the F407, so the FBL is not
  forced into sector 0. It stays at `0x08000000` because that is the default: a blank or recovered chip boots without an
  option-byte change.
- **The data is in bank 1 and the application in bank 2, which is what the two banks are for.** A read of a bank stalls
  while that same bank is written or erased (RM0481 section 7.3.7). Once the application runs, nothing is fetched from
  bank 1, so a CFG or NvM erase, up to 10 ms per sector, never stalls application code, and the application needs no
  linker trick to keep its control loop out of the way. The application reads CFG and NvM from bank 1 and writes NvM
  there while its own code runs from bank 2. Only one write or erase runs at a time on the whole flash (one `BSY` flag).
- **The FBL erases and writes bank 2 while running from the SRAM** (SW-11), so the update stalls nothing it needs.
- **128 KB for the FBL is room, not a measured need.** Phase 3 adds signature checking and anti-rollback. The FBL runs
  from the SRAM (SW-11), so the flash reservation is not the SRAM budget. An oversized region costs unused flash. A start
  address moved later costs every application build, which is why the generous direction was taken.
- **Erase and write are quick.** DS14539 Rev 3, Table 50: an 8 KB sector erases in 2 ms typical and 10 ms at most, a
  128-bit word is written in 31 µs typical and 100 µs at most. The F407's 128 KB sectors took up to 2 s.

**Rejected.**

- **Dual-bank A/B with `SWAP_BANK` (layout I and layout S).** It gives updates with no downtime and a safe FBL update, but
  the application is capped at about 150 KB (64 KB FBL; about 90 KB with 128 KB), the swap needs the option-byte reload and a copy of CFG and NvM before every
  swap, and the ST-LINK tools have to know the swap state. Layout I put NvM in the inactive bank for read-while-write.
  The vehicle has a safe state for an update, so the downtime is acceptable. **The estimated application is already at the cap
  or over it.**
- **FBL of 64 KB or 32 KB.** More room for the application, less for Phase 3 and a start address that may have to move.
- **NvM in the high-cycle data area** (100 kcycles, 6 KB sectors, `0x09000000`, RM0481 section 7.3.10). It needs the
  `EDATA` option bytes set once, takes the last sectors of a bank, and cannot hold code. The NvM is plain flash with the
  endurance of program memory (10 kcycles, DS14539 Table 51) until the wear is known.
- **The application across both banks, after CFG and NvM (328 KB, `0x08020000` to `0x08071FFF`).** The first draft. It
  gives 72 KB more, but 200 KB of the application share bank 2 with NvM, so an NvM erase of up to 10 ms stalls any
  application code fetched there, and the application's linker script would have had to keep its control loop and CAN
  interrupt in the first 192 KB. Dropped for the layout above, at the cost of those 72 KB.

**Consequences.**

- **Write-protection works in groups of four sectors (32 KB)**, seen in OpenOCD's `flash info`. The FBL (16 sectors) can be
  protected alone. CFG (one sector) cannot be protected apart from the NvM sectors that share its group.
- **One `BSY` flag covers the whole flash** (RM0481 section 7.3.3). A CFG write and an NvM write, in the same bank or not,
  must not overlap, and a write to either stalls a read of its own bank.
- **The first FBL goes on with the ST-LINK, by sector erase.** A full-chip erase would also wipe CFG and NvM. Verified
  2026-11-01: flashing the FBL with ST's OpenOCD fork erased sector 0 only.
- **The FBL-Updater rewrites sectors 0 to 15 and the rewrite is still not power-fail safe.** The erase takes 16 sectors at
  2 ms typical and 10 ms at most, 32 ms typical and 160 ms at most, against about 3 s on the F407. A power loss from the
  first erase until the new vector table is written leaves no valid FBL, and the ST-LINK is the recovery path (T1.2).
- **A recovery path other than the ST-LINK is the ST ROM bootloader**, with BOOT0 high (RM0481 Table 25). Whether BOOT0 is
  reachable on the carrier is a hardware question.

**To confirm.**

- That the FBL fits 128 KB with room for Phase 3, measured once it is built (today about 2 KB, release variant).
- The application's real size, once `Nexus-STM32-App` builds.
- The NvM wear: 10 kcycles of an 8 KB sector, and how the application spreads its writes.
- The interface of CFG and NvM between the FBL and the application.

---

## SW-10 · The FBL uses SRAM1 only and no FPU; the hand-off record is in the 2 KB backup SRAM

**Decision (2026-11-01).** The FBL places its stack, variables and buffers, and its code (SW-11), in **SRAM1**, 128 KB at
`0x20000000`. SRAM2 (80 KB, with ECC) at `0x20020000` and SRAM3 (64 KB) at `0x20034000` are left to the application. The
STM32H533 has no CCM. The FBL is built without floating point (`-mfloat-abi=soft`) and never enables the FPU, which the
Cortex-M33 has and which is off after reset.

When the application accepts `uavcan.node.ExecuteCommand` with `COMMAND_BEGIN_SOFTWARE_UPDATE`, it writes a hand-off
record into the **backup SRAM**, **2 KB at `0x40036400`** with ECC, and resets the device. **The first 512 bytes are
reserved for the record**: the requesting node's ID, the file path, a magic value and a CRC. The remaining 1.5 KB is not
claimed. The record's layout is in the interface headers of `Nexus-STM32-FBL`.

**Why.**

- **The backup SRAM is the memory the manual documents as surviving a system reset.** RM0481 Rev 5, Table 43: it is
  erased with a backup domain reset, with tamper detection if configured, and **not** with a system reset, while SRAM1 to
  SRAM3 can be erased with a system reset by an option.
- **It still holds the record.** The path is up to 255 bytes and the record adds the ID, the magic and the CRC, within
  512 bytes. It is 2 KB here and was 4 KB on the F407.
- **The FBL has no floating-point work.** The application enables the FPU, which Zephyr does itself. The two images are
  never linked together.
- **SRAM2 has ECC.** A read of a word that was never written can raise an ECC error, so the FBL does not touch it.

**Rejected.** As SW-05 and SW-06 on the F407: a stack in a second region, hard-float, the main SRAM at a fixed address
for the record, the RTC backup registers, and a flag in the flash.

**Consequences.**

- Both images enable the BKPSRAM clock (`RCC_AHB1ENR.BKPRAMEN`, bit 28) and write access to the backup domain
  (`PWR_DBPCR.DBP`) before touching the record. The application is Zephyr, so how it gets there is a question for
  `Nexus-STM32-App`.
- After a power-on the record is garbage unless VBAT keeps the SRAM. The magic value and the CRC separate a request from
  noise, and the FBL clears the record once it has read it.
- The linker scripts of both images carry the region and the section, and the numbers are in `memory_map.ld`.

**To confirm.**

- That the backup SRAM keeps its content over the reset from the application, on the board.
- What the ECC does on the first read of an unwritten BKPSRAM word after a power-on, and whether the FBL has to initialise
  it first.
- What VBAT is wired to on the NUCLEO-H533RE, which sets what survives a power loss.
- The record layout against the 512 bytes reserved.

---

## SW-11 · The FBL still runs from the SRAM; the H533 vector table is 596 bytes, so the version record moves to 0x400

**Decision (2026-11-01).** SW-07 stands: the FBL is stored in the flash (SW-09) and executes from SRAM1, with a start-up
routine and the vector table in the flash, and a copy of the table in the SRAM that `VTOR` points to. The numbers change
for the STM32H533:

- The vector table has **149 entries**, 16 system and 133 interrupts (RM0481 Table 153), **596 bytes**.
- `VTOR` needs the table aligned to the next power of two, **1024 bytes**. `SCB_VTOR_TBLOFF` starts at bit 7 in
  `core_cm33.h` (CMSIS 5.9.0), so 128 bytes is the floor, and rounding up to a power of two for more than 16 interrupts
  is the rule Zephyr applies to every Cortex-M.
- **The version record (SW-08) is at offset `0x400`**, `0x08000400` for the FBL. The table no longer fits under `0x200`.
  `0x400` is the next 1 KB boundary and the `VTOR` alignment, the reasoning SW-08 used for `0x200`. The application's
  table has the same 149 entries, so it uses the same offset and one parser reads both.

**Why SW-07 stands.**

- **The stall mostly went away, but not all of it.** The application is in bank 2 (SW-09), so erasing it no longer
  stalls an FBL that fetches from bank 1. What still stalls is the FBL writing CFG or NvM, and the FBL-Updater rewriting
  the FBL's own sectors: both are bank 1, where the FBL's code is. Each erase is 2 ms typical and 10 ms at most (DS14539
  Table 50), where the F407 stalled for up to 2 s. A CAN node publishes a heartbeat at least every second (Cyphal
  Specification v1.0), so 10 ms is well within it, but the receive FIFO of the FDCAN is not yet measured against a stall
  of that length. Running from the SRAM removes the question at the cost of the start-up copy.
- **Kept by choice (Hedi, 2026-11-01), and the copy is small.** The FBL is about 2 KB today. Copying it takes well under a
  millisecond.
- **The debugger works with it on the M33.** A hardware breakpoint set at `main` in the SRAM before the start-up copy hits
  (checked 2026-11-01 with ST's OpenOCD fork), so the M4 limit that the launch configuration worked around is gone.

**Consequences.**

- The vector table copy is aligned to 1024 bytes at the start of SRAM1 and is complete before `VTOR` is written.
- `memory_map.ld` carries `VERSION_OFFSET = 0x400`, and the build checks it (`fbl.ld`).
- SW-08's own text still says `0x200`; the offset in this entry applies.

**To confirm.**

- That the FBL keeps receiving on the FDCAN over a sector erase of 10 ms, or whether SW-07 can be dropped later.
- The time the start-up copy takes, still not measured.
- The `VTOR` alignment in Arm's own reference manual, which is not in `vendor/`. It is checked in CMSIS and Zephyr.
