BaslyHedi/Nexus-Platform/requirements/renders/traceability.html

# Nexus Requirements Traceability

Generated by tools/check-requirements.py from requirements/; do not edit · 154 requirements in 21 files: 39 system, 54 subsystem, 61 component · each card is a system in its colour from the drawings, each bubble one of its requirements

Fit −100%+ Expand allCollapse all Tidy Reset layout Phase and earlier Links Theme

R001 derived below R002 leaf, met here R003 passed on as-is one line per pair of systems, the badge counts its requirements · hover a card to light its lines · click a bubble for its own lineage

No requirements in this phase yet.

drag a card by its header · drag the background to pan · wheel to zoom · click a header without moving it to fold
