BaslyHedi/Nexus-Platform/mechanical/cad/carrier-tray-hand-template.pdf

# NEXUS carrier tray - hand-made - 1:1 template (MEC-17)

3 or 4 mm sheet, at least 189 x 116 mm. Top view, front of the vehicle to the LEFT, vehicle right at the TOP. Print at 100 %, no fit-to-page: the bar below must measure 100 mm. Centre-punch every cross, drill, then saw along the heavy line (12 straight cuts), file the edges, tap or countersink as the table says.

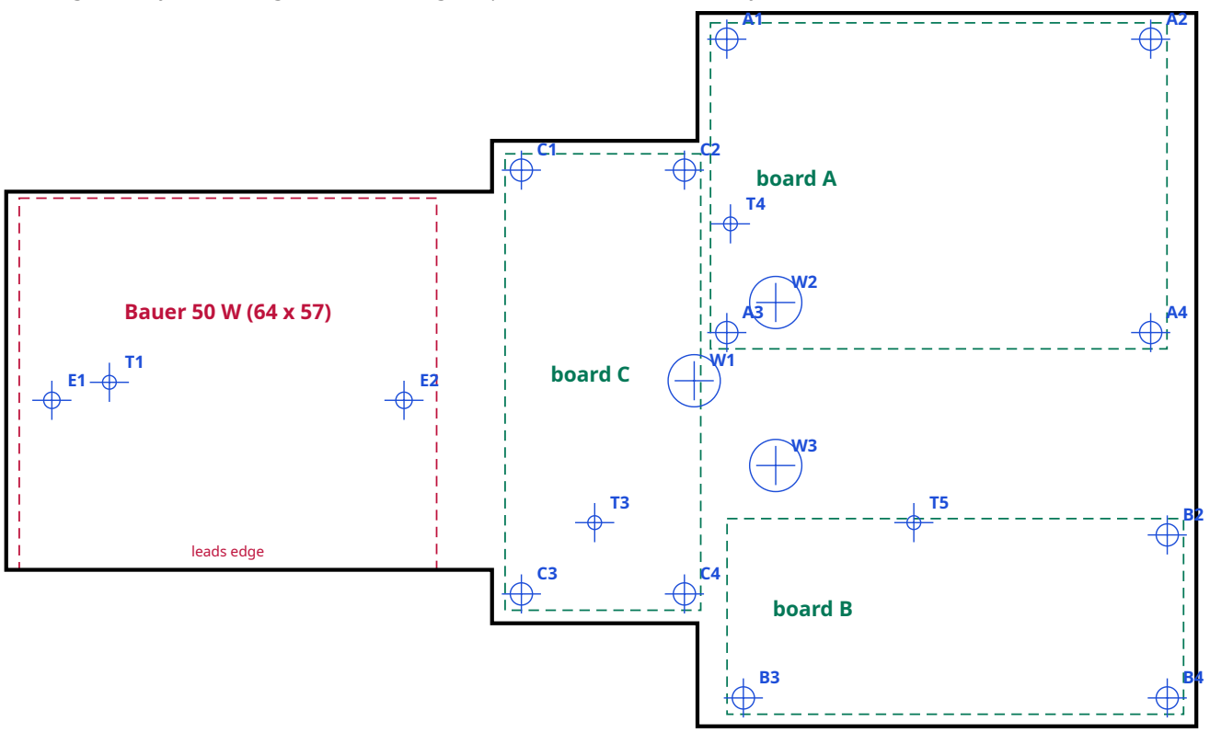
[picture p1: figure]
board A; board B; board C; Bauer 50 W (64 x 57); leads edge

100 mm | dimensions in the tables are from the tray's top left corner, x to the rear, y toward the vehicle's left

## Holes (centre from the top left corner of the tray)

A1 x 110.50 y | 4.01 | drill 3.4 | board A standoff screw, countersink from below
A2 x 175.50 y | 4.01 | drill 3.4 | board A standoff screw, countersink from below
A3 x 110.50 y 49.01 | drill 3.4 | board A standoff screw, countersink from below
A4 x 175.50 y 49.01 | drill 3.4 | board A standoff screw, countersink from below
B2 x 178.04 y 80.05 | drill 3.4 | board B standoff screw, countersink from below
B3 x 113.04 y 105.05 | drill 3.4 | board B standoff screw, countersink from below
B4 x 178.04 y 105.05 | drill 3.4 | board B standoff screw, countersink from below
C1 x 79.00 y 24.10 | drill 3.4 | board C standoff screw, countersink from below
C2 x 104.00 y 24.10 | drill 3.4 | board C standoff screw, countersink from below
C3 x 79.00 y 89.10 | drill 3.4 | board C standoff screw, countersink from below
C4 x 104.00 y 89.10 | drill 3.4 | board C standoff screw, countersink from below
T1 x 15.82 y 56.64 | drill 2.1 | to plate 2, tap M2.5 (under the Bauer)
T3 x 90.24 y 78.16 | drill 2.1 | to plate 2, tap M2.5 (under board C)
T4 x 111.06 y 32.34 | drill 2.1 | to plate 2, tap M2.5 (under board A)
T5 x 139.18 y 78.16 | drill 2.1 | to plate 2, tap M2.5 (under board B)
E1 x | 7.00 y 59.40 | drill 2.5 | Bauer, tap M3
E2 x 61.00 y 59.40 | drill 2.5 | Bauer, tap M3
W1 x 105.50 y 56.40 | drill 8.0 | cable window beside C (6 V pair)
W2 x 118.00 y 44.40 | drill 8.0 | cable window under board A (5 V and 6 V pairs)
W3 x 118.00 y 69.40 | drill 8.0 | cable window beside board B (I2C leads)

## Outline corners, in the same measure (saw straight between them)

(0.0, 27.4) | (74.5, 27.4) | (74.5, 19.6) | (106.0, 19.6) | (106.0, 0.0) | (182.5, 0.0) | (182.5, 109.4) | (106.0, 109.4) | (106.0, 93.6) | (74.5, 93.6) | (74.5, 85.4) | (0.0, 85.4)

Better for the board holes: set the real boards, with their standoffs fitted, on the sheet in their dashed outlines and mark through the standoffs - the 2.5 mm corner inset here is an estimate.

Tray 182.5 x 109.4 mm. Tap M2.5 / M3 into the sheet (or open to 2.8 / 3.2 and glue a nut on top). Board holes: 3.4 mm, countersunk 90 degrees from below for flat-head M2.5 x 8.
