BaslyHedi/Nexus-Platform/bom/parts/1.1-FRDM-IMX91S/NOTES.md

# 1.1 - NXP FRDM-IMX91S

Both documents below are **NXP**, copyrighted, and **not in the repository** - search the
titles on nxp.com. Everything they settled for us is written out here.

| Document | What it is |
|---|---|
| *FRDM-IMX91S Quick Start Guide* | Official QSG for **our** board. Connector map, 40-pin pinout, boot switch table, J1/J11 |
| *UM12262, FRDM-IMX91 Board User Manual*, Rev 3.0, 22 Apr 2025 | Board user manual - **for the FRDM-IMX91, not the -IMX91S** |
| *FRDM-IMX91S design files*, board 95020 rev B (May-Jul 2025): schematic `SCH-95020_B`, assembly `ASY-95020_B`, Gerbers and drill `GRB-95020_B`, 3D `STP-95020_B`, `BOM-95020_B`, IPC-D-356 netlist | **The -S's own manufacturing data.** Authoritative for outline, holes and connector positions |

⚠️ UM12262 covers the non-S board. Use it for the shared FRDM form factor and board-level
detail, but **verify anything -S-specific against the QSG**. The -S adds the IW610 wireless
module and 256 MB QSPI NAND.

## Confirmed from the QSG

- **95.0 × 65.0 mm**, 10-layer - **from the -S's own Gerbers** (2026-10-06). The 105 × 65 here and in UM12262 is the *non-S* board's. ⚠️ Earlier text, kept for the record: **The -S looks about 95 × 65 mm**: in the Quick Start Guide's top and bottom views (figures 1 and 2) the outline is 95 mm long at the scale where the six mounting holes sit 49.0 mm apart, then 39.5, on a 58 mm spacing. Photo, +-1 mm. Hedi measured **96 x 67 over the connectors** (2026-10-06), which fits: the RJ45 overhangs the board edge by about 2.5 mm and the USB-A by about 1.8 mm. **Measure the bare PCB** (MEC-18)
- i.MX 91, 1× Cortex-A55 · 512 MB LPDDR4 · 256 MB QSPI NAND (NAND boot) · microSD 3.0
- IW610: Wi-Fi 6 + BLE 5.4 + 802.15.4 · 1 Gbps Ethernet · external RTC w/ coin cell
- **Power: J1, USB-C only.** No barrel jack, no terminal block
- Debug: J11 USB-C UART, 115200 8N1
- **2×5 NXP custom connector: 1× CAN port, 2× ADC channels, I2C/I3C**
- 40-pin (2×20) expansion: 5 V on pins 2/4, 3V3 on 1/17, I2C4 on 3/5, UART3 on 8/10, SPI3, SAI3, PDM
- Boot switch SW1[4-1]: `0011` = microSD (default), `0101` = FlexSPI NAND, `0001` = serial downloader
- Kit ships a 32 GB TF card with the BSP and a USB-C→A cable

## ✅ Power input - RESOLVED 2026-09-13

**The FRDM-IMX91S boots and runs from a dumb 5 V / 1 A supply.** No PD negotiation, no
12–20 V. Confirmed on the bench.

This means **UM12262 does not describe this board's power input.** That manual is written
for the FRDM-IMX91, where §2.2 states: "The primary power supply to the FRDM-IMX91 board is
VBUS_IN (12 V - 20 V) through USB Type-C PD connector (P1)", negotiated by two PTN5110 PD
PHYs with an MP8759GD bucking VBUS_IN down to 5 V internally. **None of that applies to the
-S.** The -S evidently feeds SYS_5V directly and skips the pre-buck stage - consistent with
it being the smaller board (one Cortex-A55, no M.2/PCIe) and with the kit shipping a
USB-C-to-USB-**A** cable, which can only ever carry 5 V.

**Treat UM12262's entire power chapter as not applicable to the -S.** It remains useful for
the shared FRDM form factor and for board-level detail, but not for anything on the input side.

### What this settles

| Question | Answer |
|---|---|
| Input voltage | **5 V** |
| PD negotiation required? | **No** |
| Idle/boot draw | **< 1 A** (it ran on a 1 A supply) |
| Feed from the Bauer 50 W? | **Yes** |

### Still to measure

Draw **under load** - Wi-Fi transmitting, Ethernet up, USB host peripherals, CPU busy. 1 A
is the boot/idle figure, not the budget. The 50 W converter has ample headroom either way,
but the number is needed to size the branch fuse properly.

### Connector detail

The bench test worked through a C-to-A cable, which carries a **56 kΩ Rp** in the plug and
therefore advertises only USB default current (500–900 mA). Fine on the bench; not what you
want on the robot, because a sink that honours the advertisement could current-limit itself.

*Superseded 2026-10-07.* The plan was a USB-C source pigtail with 10 kΩ Rp on both CC pins. The
KUOQIY socket turned out to carry its own 5.1 kΩ Rd (a sink), and the board **booted with VBUS and GND
only, CC unconnected**, through the C-to-C cable. So on the vehicle J1 is fed on VBUS and GND alone and
no Rp is fitted (HW-02). Loaded current is still untested.

## Open question this folder should answer

**Are the CAN pins on the 2×5 connector already transceived, or raw TX/RX?**
Neither the QSG nor UM12262 (non-S) settles it for this board. This decides whether the
project buys one CAN transceiver or two - see BOM 4.1 / 4.2.

## Connector positions (Quick Start Guide, figures 1 and 2, 2026-10-06)

Top view with the 40-pin header on the left; u along the long edge, v along the short, mm, +-1, from the photo. Used by the compute tray's preview (MEC-18).

| Edge | Connector | Where |
|---|---|---|
| left | 40-pin header | u 0.5-6, v 7-59 |
| top | 30-pin FPC · 2x5 NXP custom header J7 (the CAN port) · USER / ONOFF / RESET | u 27-47 · u 60.5-73.5 · u 74-88, all v 1-7 |
| right | USB-C DBG (J11) · USB-C (J5) · USB-A | v 10-19 · v 27-36 · v 43-56, at u 81-97 (overhanging the edge by about 1 mm) |
| bottom | audio jack · USB-C power (J1) · RJ45 | u 16-23 · u 31-41 · u 60-77, v 54-67 (the RJ45 overhangs by 2.5 mm) |
| underside | microSD slot | u 29-45, opening to the **top** edge |

## From the -S's own design files (2026-10-06)

Read from `GRB-95020_B.zip` (fab drawing, drill file) and the IPC-D-356 netlist. Frame: **u** along the long edge from the 40-pin header end, **v** along the short edge from the CAN / microSD edge, mm (u = x - 8.69, v = 72.42 - y in the files).

**Outline.** 95.0 x 65.0 mm (the fab drawing's own dimension line reads 8.69 to 103.69; the outline's long edges are at y 7.42 and 72.42), corner radius about 1.3 mm.

**Mounting holes - six, plated, ⌀3.175 mm (125 mil), exact:**

| | v 3.5 | v 61.5 |
|---|---|---|
| u 3.5 | ● | ● |
| u 52.5 | ● | ● |
| u 91.5 | ● | ● |

Spacings 49.0 and 39.0 along u, 58.0 along v. The first two columns are what MEC-11 matched to the chassis grid (49.00 x 58.00); the third column is 39 mm further on (the non-S board has its outer holes at u 101.5, one of them pulled inboard). The four ⌀3.0 mm and two ⌀3.25 mm non-plated holes in the drill file are the panel's tooling holes and the RJ45's locating posts, not mounting holes.

**Connectors** (pin extents from the netlist; all agree with the Quick Start Guide photo to within 1 mm):

| Part | What | u | v |
|---|---|---|---|
| J12 | 40-pin header, 2 x 20 | 2.2-4.8 | 8.4-56.6 |
| J7 | **2x5 header, 2.54 mm**, the CAN port | 61.6-71.8 | 3.4-5.9 |
| J1 | USB-C **power** | 31.6-40.2 | 59.1-63.4 |
| J11 | USB-C **debug** (UART console) | 88.0-93.3 | 10.6-19.2 |
| J5 | USB-C (USB1) | 88.0-93.3 | 27.3-35.9 |
| J6 | USB-A | 83.0-85.7 | 43.2-56.3 |
| J2 | RJ45 | 60.2-75.7 | 46.2-60.0 |
| J13 | audio jack | 16.3-23.5 | 53.5-62.8 |
| SW1 | boot-mode switch | 57.1-65.2 | 19.0-22.8 |

**J7 pinout (the -S's netlist, replacing the "inferred for the -S" in BOM 4.2):** 1 VDD_3V3_EXT · 2 VDD_5V_EXT · 3 ADC_IN0 · 4 ADC_IN1 · 5 CLKO04_3V3 · **6 GND** · 7 I2C1_SCL · **8 CAN_H** · 9 I2C1_SDA · **10 CAN_L**.

**CAN.** The -S has its own **TJA1051T/3** transceiver (U11) on CAN1, through a common-mode choke to J7 pins 8 and 10, with a split termination of 60.4 ohm resistors and a jumper **JP1** (schematic sheet with `CAN1_TX` / `CAN1_RX`). Which termination resistors are fitted on the real board is not stated in the text of the schematic: **read JP1 and the resistors on the desk board before wiring the bus**, since BOM 4.3 allows 120 ohm at the two ends only.

Hedi's hand measurement of the desk board (2026-10-06) matches the Gerber outline, 95.0 x 65.0 mm.
