BaslyHedi/Nexus-Platform/mechanical/cad/plate2-rear-pad.stl

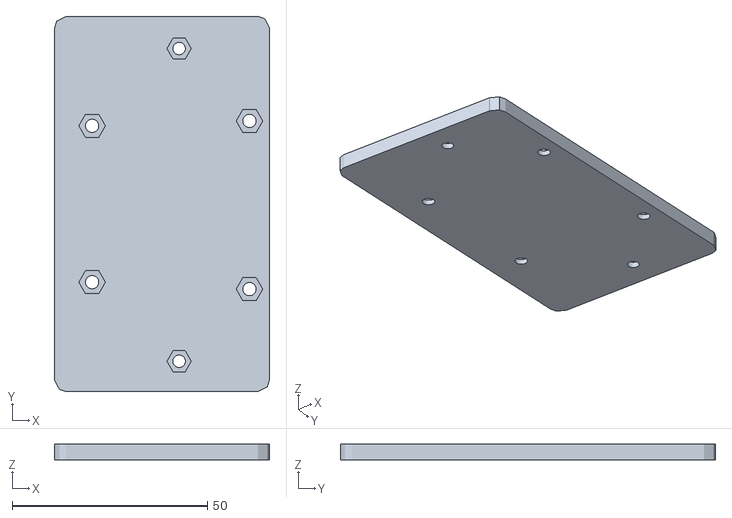
[picture p2: CAD file, 2026-10-06]
mechanical/cad/plate2-rear-pad.stl
55.0 x 96.0 x 4.00
