BaslyHedi/Nexus-Platform/mechanical/cad/compute-tray.stl

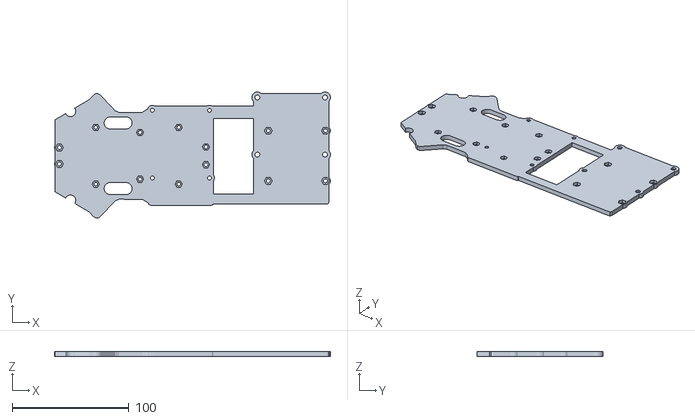
[picture p3: CAD file, 2026-10-06]
mechanical/cad/compute-tray.stl
236.6 x 108.0 x 4.00
