BaslyHedi/Nexus-Platform/mechanical/cad/carrier-tray.stl

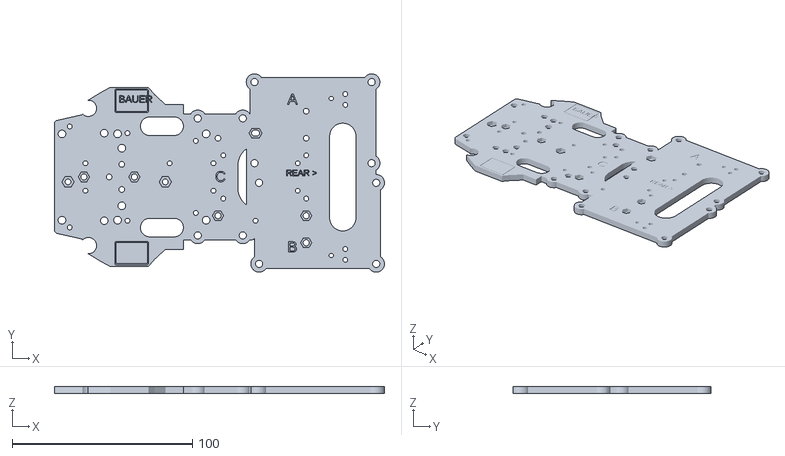
[picture p4: CAD file, 2026-10-06]
mechanical/cad/carrier-tray.stl
183.1 x 110.1 x 4.00
