BaslyHedi/Nexus-Platform/mechanical/cad/fascia-lower.stl

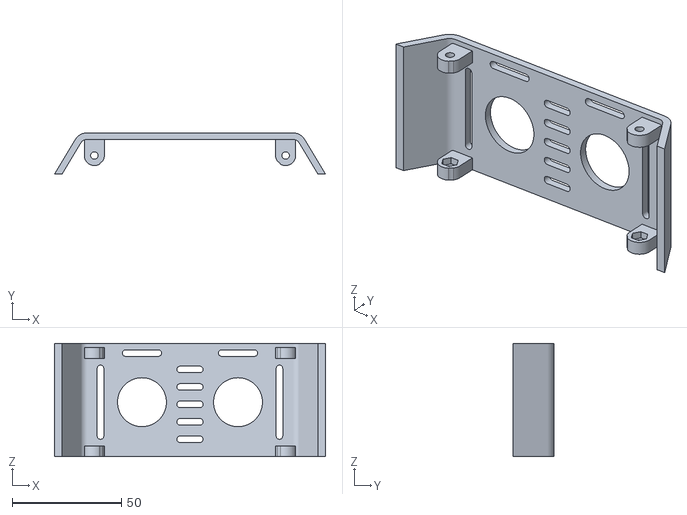
[picture p5: CAD file, 2026-09-25]
mechanical/cad/fascia-lower.stl
124.2 x 18.9 x 52.0
