BaslyHedi/Nexus-Platform/mechanical/cad/fascia-upper.stl

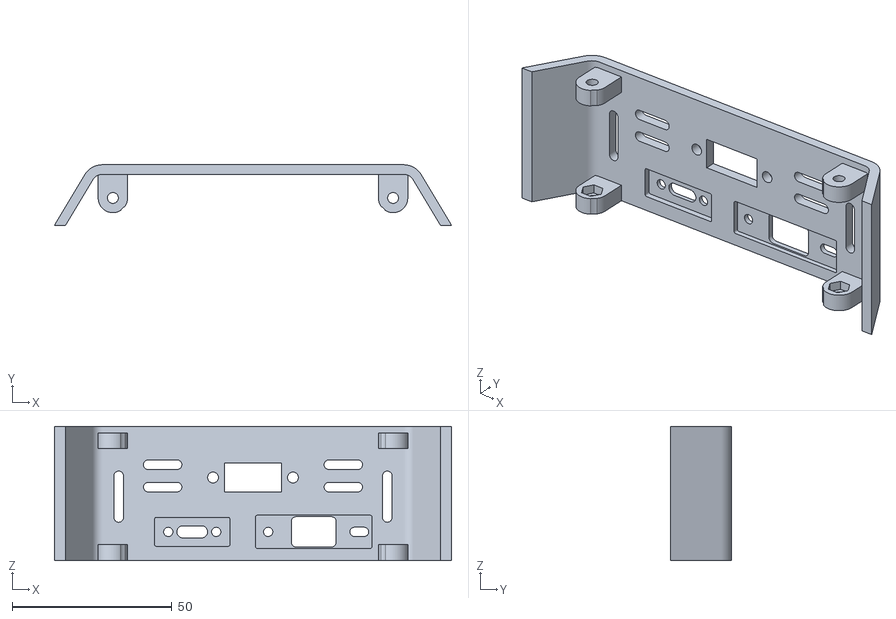
[picture p6: CAD file, 2026-09-25]
mechanical/cad/fascia-upper.stl
124.2 x 18.9 x 42.0
