BaslyHedi/Nexus-Platform/mechanical/cad/plate3-data.scad

// GENERATED by mechanical/scripts/plate3-data.py from hardware/scripts/chassis-layout.py. Do not edit.
OUTLINE = [[0, 33.35], [0.53, 32], [1.53, 31.06], [40, 8.29], [47, 0.99], [48, 0.41], [50, 0], [52, 0.41], [53.53, 1.48], [68.53, 17.42], [70, 18.05], [87.53, 17.95], [113, 2.83], [114.53, 2.47], [251.53, 0.89], [253.53, 1.58], [268.53, 10.59], [269.53, 11.65], [269.53, 108.88], [268.53, 109.94], [252.53, 119.47], [114, 118], [112.53, 117.42], [87.53, 102.58], [70, 102.48], [68.53, 103.12], [53, 119.53], [51, 120.42], [49, 120.42], [46.53, 119.05], [40, 112.23], [1.53, 89.47], [0.53, 88.53], [0, 87.18]];
HOLES = [[186.12, 9.71, 3.18], [186.12, 110.82, 3.18], [245.88, 96.77, 3.18], [245.88, 81.77, 3.18], [196.88, 38.76, 3.18], [196.88, 81.77, 3.18], [196.88, 96.77, 3.18], [245.88, 38.76, 3.18], [262.94, 16.41, 3.18], [196.88, 23.76, 3.18], [245.88, 23.76, 3.18], [262.94, 104.05, 3.18], [99.24, 38.76, 3.18], [148.18, 23.76, 3.18], [45.82, 67.24, 3.18], [10.82, 60.23, 3.18], [99.24, 23.76, 3.18], [52.82, 60.23, 3.18], [148.18, 81.77, 3.18], [45.82, 53.24, 3.18], [38.82, 60.23, 3.18], [148.18, 38.76, 3.18], [24.82, 60.23, 3.18], [99.24, 81.77, 3.18], [148.18, 96.77, 3.18], [17.82, 53.24, 3.18], [99.24, 96.77, 3.18], [17.82, 67.24, 3.18], [50, 115.52, 3.18], [104.41, 19.59, 3.18], [104.41, 100.95, 3.18], [50, 5, 3.18], [227.88, 14.23, 2.71], [169.88, 100.23, 2.71], [227.88, 100.23, 2.71], [169.88, 14.23, 2.71], [86.94, 80.23, 2.71], [86.94, 40.23, 2.71], [120.06, 35.94, 2.71], [96.71, 52.65, 2.71], [96.71, 67.88, 2.71], [143.47, 67.88, 2.71], [143.47, 52.65, 2.71], [120.06, 84.53, 2.71], [16.94, 32.24, 2.71], [16.94, 88.24, 2.71], [49, 84.53, 2.71], [25.65, 67.88, 2.71], [169.88, 106.24, 2.71], [25.65, 52.65, 2.71], [72.41, 52.65, 2.71], [169.88, 20.23, 2.71], [227.88, 106.24, 2.71], [49, 35.94, 2.71], [72.41, 67.88, 2.71], [227.88, 20.23, 2.71], [102.18, 72.24, 2.71], [148.18, 72.24, 2.71], [148.18, 48.24, 2.71], [102.18, 48.24, 2.71], [251.29, 112.35, 2.47], [251.29, 8.17, 2.47], [162.06, 16.7, 2.47], [162.06, 103.83, 2.47]];
SLOTS = [[161.18, 30.42, 14.6, 59.76], [110.29, 42.53, 22.7, 35.35], [260.29, 23.55, 5.36, 73.4], [219.47, 26.12, 4.3, 68.3], [235.47, 26.12, 4.3, 68.3], [203.47, 26.12, 4.3, 68.3], [187.47, 26.12, 4.3, 68.3], [109.35, 9.88, 48.3, 5.3], [109.35, 105.34, 48.3, 5.3], [56.18, 26.94, 23.9, 10.3], [56.18, 83.17, 23.9, 10.3], [3, 38.62, 3.2, 43.2], [41.35, 55.76, 9, 9], [13.35, 55.76, 9, 9], [41.35, 34.17, 4.3, 4.3], [41.35, 82.06, 4.3, 4.3], [43.71, 42.11, 4.3, 4.3], [43.71, 74.12, 4.3, 4.3], [232.76, 11.69, 4.3, 4.3], [232.76, 104.52, 4.3, 4.3], [205.88, 104.52, 4.3, 4.3], [10.53, 34.17, 4.3, 4.3], [254.71, 20, 4.3, 4.3], [205.88, 11.69, 4.3, 4.3], [10.53, 82.06, 4.3, 4.3], [254.71, 96.18, 4.3, 4.3], [90.47, 34.17, 4.3, 4.3], [25.18, 20, 4.3, 4.3], [90.47, 82.06, 4.3, 4.3], [25.18, 96.18, 4.3, 4.3], [34, 33.83, 4.2, 4.2], [34, 82.47, 4.2, 4.2]];
STANDOFFS = [[256.82, 22.17], [256.82, 98.36], [27.35, 22.17], [27.35, 98.36]];
CLAMPS = [[262.94, 16.41], [262.94, 104.05]];
