BaslyHedi/Nexus-Platform/(commit log)

2026-09-22 Baseline: the platform definition as it stands
    First commit of NEXUS under version control. The tree is exactly as it was on
    disk today, minus the vendor reference library - datasheets, NXP's design-file
    package, Hiwonder's 186 MB chassis CAD and the two generated meshes - which is
    ignored in place rather than moved.
    This commit exists so the restructure that follows reads as renames rather
    than as 32 new files, and so progress diffs start from a known point.
    [fascia-lower.stl, fascia-upper.stl, fascia.scad]
2026-09-22 Restructure into the definition repo, and settle the vendor-document rule
    Puts NEXUS under version control and reshapes the tree around what the
    repository is for: it is cited from elsewhere, so the top level now reads as
    the definition rather than as the folders the research happened in.
    system/ decisions/ hardware/ mechanical/ bom/ tools/
    Firmware, the Linux image and each application will get their own repositories
    and consume this one by decision ID. No code lands here.
    No vendor document is committed - copyrighted and not ours to redistribute,
    which applies to the 28 MB of PDFs exactly as it applies to Hiwonder's 186 MB
    .3dm. The repository records the vendor, the exact titl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
    [fascia-lower.stl, fascia-upper.stl, fascia.scad]
2026-09-25 Fascia: finalise both panels for ordering (MEC-13, MEC-14) (#2)
    Upper panel: USB-C, DE-9 and Mini-B mount from behind in pockets, all horizontal in two rows centred on the face (MEC-13). Lower panel: switch holes 22.4 from the vendor drawing, legends at z 41 (MEC-14). Vents redesigned for cooling, most area on the lower panel. New portclash gate; make-assembly.py no longer sinks deck 3 on re-runs. Open, not blocking the print: USB-C body length vs the STM32 carrier (MEC-13), switch harness depth (MEC-14).
    [fascia-lower.stl, fascia-upper.stl, fascia.scad]
2026-09-28 STM32 carrier on the kit perfboards, placed on plate 2 (MEC-15, HW-19) (#3)
    * STM32 carrier: rebuild on the kit boards in hand (MEC-15, HW-19)
    No board in the RUNCCI-YUN kit spans the Discovery, so the carrier becomes
    board A (3x7) under P1 and board B (5x7) under P2, aligned by the Discovery
    itself, plus board C (3x7) as the 5 V split. The new sheet gives component
    side and solder side hole by hole, a netlist, and the pre-solder checks.
    - Both 470 uF caps and every resistor are now on a board: C2 at the servo
    header, C1 and the USB-C Rp pair on board C, R4 1k in the servo PWM.
    - CAN termination at the STM32 end is R3 120R behind a TERM jumper.
    - Fixes the old sheet's P2 pinout: P2-3/4 a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
2026-09-29 Lower deck wiring: three fuses, plate 2's lower face as the harness board (MEC-16, HW-20) (#4)
2026-10-05 STM32 carrier: boards A/B as built, board C socket, insulated routing, CAN module, tray proposal (MEC-15, MEC-17, HW-19, HW-21) (#5)
    One working session on the STM32 carrier.
    - Carrier drawing generated by hardware/stm32-carrier.py. Hole names as printed on the kit
    boards, fixings F1-F6, and an orientation panel.
    - All wiring insulated and pad to pad, checked by tools/check-carrier-routing.py.
    - As built: A's P1 sockets one hole toward CN1, R3 = 100 + 20 ohm, the CAN module face down on
    a 1x4 and a 1x2 socket, and A's ground from its own P1-5. Board C gets the USB-C socket.
    - HW-10 corrected; HW-21 added (servo PWM on PE9); MEC-17 tray proposed; BOM 4.1 module
    dimensions.
    - mechanical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
    [carrier-tray.scad, carrier-tray.stl, fascia-lower.stl, fascia-upper.stl, fascia.scad]
2026-10-05 Carrier tray: boards, Bauer and splices on one tray; drawing generators; folder pattern (MEC-17) (#6)
    The STM32 carrier, the Bauer 50 W and the S6/S7 splices on one 183 x 110 mm printed tray that bolts to plate 2 at six holes clear of every taped part (T1-T6). Boards A, B, C placed on the tray, then the tray on plate 2. Bauer screwed through its own two holes, with cable lanes; splices moved out from under board C.
    Also: board C's silkscreen runs the other way round (F5/F6 are C-F4/C-F21); hardware/ and system/ get scripts/ and renders/; chassis-layout.py and wiring-schematic.py generate their SVGs (tools/check-drawings.py fails on drift); a Blender assembly animation of the tray.
    Open: st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
    [carrier-tray.scad, carrier-tray.stl]
2026-10-06 Hand-made carrier tray: 1:1 template, hole table, cable windows (MEC-17) (#7)
    * Hand-made tray: 1:1 template and hole table for a 4 mm sheet, straight cuts only, 19 holes (MEC-17)
    * MEC-17: say what was actually quoted (laser cutting, not milling)
    * Hand-made tray: store the printable 1:1 template PDF in mechanical/cad (MEC-17)
    * Hand-made tray: three cable windows spread over plate 2's opening (W1-W3), template and PDF regenerated (MEC-17)
    * MEC-17: print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
2026-10-06 Carrier tray: fit review before the single print (MEC-17) (#8)
    * Carrier tray fit review before printing: clear the chassis standoffs, loosen board and fixing holes, wider nut pockets (MEC-17)
    * Bauer measured from a photo: body ~64 wide, remove the rim, note washers and slot access (MEC-17)
    * MEC-17: M2.5 nut measured 5.0 mm; M3 purchase spec
    * Review fixes: layout drawing and MEC-17 text follow the measured Bauer, stale rim and lane wording removed
    -----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
    [carrier-tray.scad, carrier-tray.stl]
2026-10-06 Compute tray, plate 2 rear pad, layout update: plates 2 and 3 ordered (MEC-18, MEC-19) (#9)
    The three trays of the Craftcloud order #516727254320 (2026-10-06, BOM 3.28): the carrier tray (MEC-17, already on main), the compute tray for plate 3 (MEC-18) and a separate rear pad for plate 2 (MEC-19), with the connector positions of the FRDM-IMX91S read from NXP's Quick Start Guide.
    - MEC-18: one 236.6 x 108 x 4 mm tray on plate 3, both boards turned across the vehicle: spare nose pad, Pi 5 pad, plug gap, FRDM pad; 14 fixings on plate 3's own holes. Wiring traced for the BOM's parts only (J1, J11, J7); none needs a tray change.
    - MEC-19: a 55 x 96 x 4 mm plain pad spread over plate 2's rear, six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
    [carrier-tray.scad, compute-tray-preview.scad, compute-tray.scad, compute-tray.stl, plate2-rear-pad.scad, plate2-rear-pad.stl, plate3-data.scad]
2026-10-07 Switch wiring, BOM cross-check and FRDM from vendor files; drawings, model and animations updated (MEC-16, MEC-17) (#10)
    * BOM cross-checked against the order emails; FRDM-IMX91S confirmed from its own design files (95.0 x 65.0, holes, J7 pinout)
    Hiwonder #9835, BerryBase #975842 (Pi 5 set with Sense HAT), the fascia Craftcloud
    order, the M2.5 and M2/M3/M4 kits, soldering iron and adhesive pads recorded; the
    M2.5 x 6 screws the trays need are not in the M2.5 kit; J7 identified as a 2.54 mm
    2x5 header; DE-9 F-F cable ordered per Hedi (no email found).
    * SW1/SW2 in hand; FRDM hand measurement matches the Gerbers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
    [compute-tray.scad]
2026-10-07 Board C drops Rp and the CC wires; CAN adapter ordered, isolation waived (#11)
    * Board C drops Rp and the CC wires; CAN adapter ordered, isolation waived (HW-02, HW-18, HW-19, BOM 4.7, 5.1)
    The KUOQIY socket carries its own 5.1k Rd (4.98k measured on a spare), and the
    FRDM boots with VBUS and GND only, so R1, R2 and the CC wires are removed from
    board C. The USB-CAN adapter is ordered with a screw terminal and no isolation;
    the ST-LINK already ties the same grounds, so isolating CAN alone is waived.
    Carrier drawing, wiring schematic, routing check and animation script updated.
    * Review fixes: board C hole names in the HW-19 revisi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
    [animate-stm32-carrier.py, stm32-carrier.py, wiring-schematic.py]
2026-10-11 Phase plan, system layout script, Phase 1 bench demo, SW-01 Cyphal FBL (SYS-02, SW-01) (#13)
    * System layout gets its script; five-phase plan with Phase 1 defined (SYS-02)
    * Matrix lives in the STM32 App repo; FBL is bare-metal
    * Separate Nexus-CAN-Utils repo (matrix + UDS flasher), kas decided, learning focus rewritten for an experienced firmware engineer
    * SW-01: the flash bootloader speaks OpenCyphal
    * Phase 1 bench demo defined (T1.1-T2.3); one repo pe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
2026-10-11 Public-readiness cleanup: licences, README about section, order numbers stripped, video section removed (#14)
    * Strip order numbers and a private individual's name from the records
    * Licences (Apache-2.0 code, CC BY 4.0 documents, NOTICE), README about section, video-series section removed
    ---------
    [carrier-tray.scad, compute-tray.scad, plate2-rear-pad.scad]
2026-10-11 Systems engineering method, logical and physical views, Phase 1 requirements and traceability tool (SYS-03) (#15)
    * Requirements method: four levels of systems of interest; layout renamed Logical-Architecture (SYS-03)
    * Requirements format A: requirements/ folder, SoI registry, checker with generated TRACE.md (SYS-03)
    * Phase 1 requirements, vehicle to repositories: 113 requirements, physical architecture, as-is allocation and the V (SYS-03)
    * Physical architecture drawing, Draft A: merged and physical-only element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
2026-10-14 Record SW-08: every image carries a 64-byte version record (#17)
    * Record SW-08: every image carries a 64-byte version record
    Fixed offset 0x200, plain ASCII with fixed field widths, generated from the
    project settings. The FBL is the first image to carry it; the application
    follows later on its own side.
    * SW-08: the record is read back from the board
    The to-confirm item on the board is checked: OpenOCD through the
    ST-LINK/V2 flashed FBL_Nexus.srec by sector erase, and a read-back of
    0x08000200 shows the record, the NUL and 0xFF to its end.
    ---------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
2026-10-24 Add the learn-review skill and its C++ ladder (#18)
    * Add the learn-review skill and its C++ ladder under tools/claude-skills
    * learn-review: pair its own changes with the session of the reviewed repository
    * learn-review: flatten slashes of the reviewed branch name
    * Ladder: references versus pointers seen (Nexus-STM32-FBL cyphal-transfer-crc)
    * Ladder: errors without exceptions seen (Nexus-STM32-FBL cyphal-transfer-crc)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
2026-10-30 NUCLEO-H533RE replaces the dead Discovery: carrier, HW-22, requirements, BOM (MEC-15, MEC-17) (#20)
    * Carrier A/B for the NUCLEO-H533RE: sockets, wiring, drawings, 3D mock
    The Discovery is dead and the NUCLEO-H533RE replaces it. Boards A, B, C,
    their standoffs and the tray (MEC-17) stay where they are.
    - Its morpho rows are 63.50 apart (25 pitches, UM3121 Fig. 7), so the
    sockets move two columns outboard on each board: A g/h under CN10,
    B i/j under CN7, four 1x19 strips. The board sits 5 rows forward of
    the Discovery's row 1, rear edge at x 202.7.
    - Nets: E5V (CN7-6) from 5V IN, 3V3 from CN7-16, FDCAN2 PB12/PB13,
    I2C1 PB6/PB7, TIM1_CH1 PA8. Three bridges: 3V3 to I2C-A, and the
    FD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
    [carrier-tray.scad, compute-tray-preview.scad, fascia.scad, plate2-rear-pad.scad]
2026-11-01 Record SW-09 to SW-11: the STM32H533 flash map, SRAM and hand-off, vector table (HW-22) (#21)
    SW-04 to SW-07 were written for the failed F407. SW-09 supersedes SW-04 (FBL, CFG and NvM in bank 1, the application alone in bank 2), SW-10 supersedes SW-05 and SW-06, SW-11 updates SW-07 and moves the SW-08 version record to 0x400. Requirements, glossary and the traceability page follow.
2026-11-06 Carrier as soldered: A under CN7, B under CN10, parts follow the pins (HW-24, MEC-15) (#22)
    * Carrier as soldered: A under CN7, B under CN10, parts follow the pins (HW-24)
    The drawing showed the NUCLEO-H533RE mirrored across the vehicle, so the
    boards were soldered with CN7 over A and CN10 over B. The sockets stay;
    the parts change boards, with no GPIO change:
    - A (CN7): 5V IN to E5V, 6V IN, C2, R4 and SERVO from PC2, the LED
    stick header from PC12
    - B (CN10): the SN65HVD230 module, the CAN terminal under plate 3's
    left slot, I2C-A and I2C-B on PB6/PB7
    - one wire still crosses: 3V3, now behind the sockets
    CN7 has no FDCAN TX, its only I2C pins carry the HSE crystal, and
    CN7-36/38 give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
    [compute-tray-preview.scad, plate2-rear-pad.scad]
