BaslyHedi/Nexus-Platform/(notices)

Notices in the files:
requirements/renders/traceability.html:
{"asis":[],"dec":"","der":[],"fn":[],"kids":[],"need":"Deliverable 1.7","phase":"1","real":"SYS","soi":"Nexus-Enabling","text":"Each repository shall cite the requirement IDs of each software element that the repository implements.","up":[],"ver":"Inspection The software requirements of each reposit
